intergalaktik/Extension_Boards_for_Olimex_GateMate/GamePad_I2S_audio_Buttons/KiCad/README.md

# Olimex Simple Extension Boards
Simple extension boards for Olimex GateMate FPGA Board

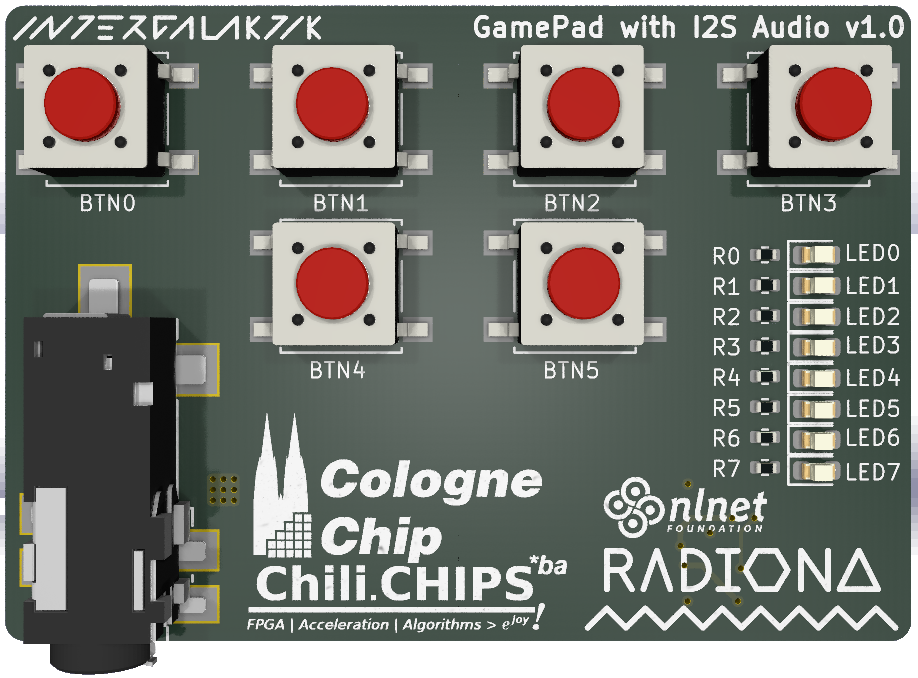
[picture p13: GamePad_I2S_audio_Buttons/pic/GamePad_I2S_audio_top.png]
GamePad_I2S_audio_TOP


Current schematic: https://github.com/intergalaktik/Extension_Boards_for_Olimex_GateMate/blob/main/GamePad_I2S_audio/doc/GamePad_I2S_audio.pdf
