intergalaktik/Extension_Boards_for_Olimex_GateMate/simpleIO/KiCad/README.md

# Olimex Simple Extension Boards
Simple extension boards for Olimex GateMate FPGA Board

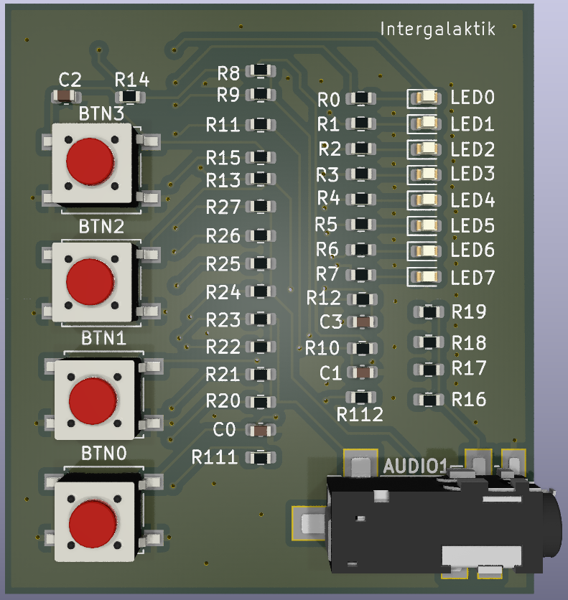
[picture p14: simpleIO/pic/simpleIO.png]
SimpleIO_TOP
