intergalaktik/Extension_Boards_for_Olimex_GateMate/extension_template/meta/olimex_extension.png

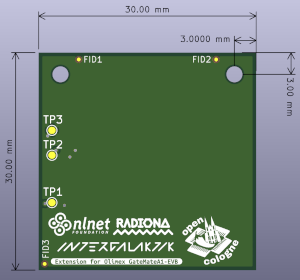
extension_template/meta/olimex_extension.png
