intergalaktik/Extension_Boards_for_Olimex_GateMate/GamePad_I2S_audio_Buttons/pic/StepUp_schematic.png

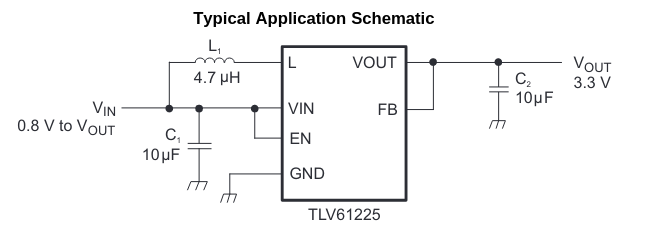
GamePad_I2S_audio_Buttons/pic/StepUp_schematic.png
