intergalaktik/Extension_Boards_for_Olimex_GateMate/(threads)

Thread 3 (2024-12-10):

dvi: GPDI_Dn and GPDI_CLK capacitor values

pu-cc, 2024-12-10:
I really like this extension!

Could you share the reasoning behind choosing 220nF for the AC coupling? For high-speed signals like DVI, I would consider changing it to 100nF to avoid excessive attenuation. 100nF is how we tested it on our platforms.

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

goran-mahovlic, 2024-12-10:
220nF is also working good - but yes I can change to lower.
I have copy pasted old version - I would say at last revision we are down to 22nF

As I have plenty of 100nF that sounds as a best value to go with...

Closed 2024-12-12.

Thread 4 (2024-12-10):

camIO: no support for LP modes and possible saving of U1

pu-cc, 2024-12-10:
Great idea for an extension!
This is more of a summary of some of my thoughts:

To support LP (single-ended) mode as well, we would have to use an additional bank that is configured to 1.2V.
It would be interesting to investigate whether we could use the entire bank with 1.2V, i.e. for both the single-ended and the differential inputs.

The Raspberry Pi Camera pull-ups `SCL` and `SDA` to 1.8V. But, thanks to the MOSFET, we could also manage without `U1` with pull-ups to 1.2V or whatever the GPIO voltage is. What do you think?
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*
(* [reference schematic](https://datasheets.raspberrypi.com/camera/camera-module-2-schematics.pdf))

Btw., I assume that the global names are still there by mistake:
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

goran-mahovlic, 2024-12-10:
Tnx!

You are right, I2C translation chip is not needed, I just assumed camera side, and was wrong :)
As you described, we just need PULL UP to our low voltage level.

2. that is just label converted to text - so nothing important, will change to just SDA/SCL

goran-mahovlic, 2024-12-10:
>> It would be interesting to investigate whether we could use the entire bank with 1.2V, i.e. for both the single-ended and the differential inputs.

oooo - no I think I get it  - you are suggesting to use remaining pins and connect them over resistor to P lines on CAM?

pu-cc, 2024-12-10:
> oooo - no I think I get it - you are suggesting to use remaining pins and connect them over resistor to P lines on CAM?

Almost :) We need both `*_N` and `*_P` in LP mode, as it transmits information such as HS-request etc. (LP-11, LP-01, LP-10 and LP-00).

Basically like this:
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
With `R{1,2,4,5,6,8}=100R` and `R{3,7,9}=150R` -- these are the values   from our evaluation with the HS bank at 2.5V and the LP bank at 1.2V.

goran-mahovlic, 2024-12-10:
@pu-cc could you check current schematic?

Now all 4 pairs have added LP on Positive side I think this could work as those are slow signals and we can always get N with just ~P.

As for R{3,7,9}=150R GateMate does not have internal termination, as that is better then terminate on extension board?

Just in case I can add termination resistors, and we can remove them and check if it is better without them.

goran-mahovlic, 2024-12-10:
@pu-cc I have placed termination resistor like on your schematics

Yes, from this picture it could be that you need P and N LP pins - but you only need P CLK pin?

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

If so I will have enough pins for the two data lines setup - like this

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

Closed 2024-12-12.

Thread 7 (2025-01-14):

usbIO - voltage lovel converter is sonnected wrong

goran-mahovlic, 2025-01-14:
This should be opposite - now we always have 3V3 on FPGA pins - voltages need to be switched so we have FPGA voltage at voltage pins, and 3V3 on USB connectors

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
