intergalaktik/Extension_Boards_for_Olimex_GateMate/ethIO/ethIO.pdf

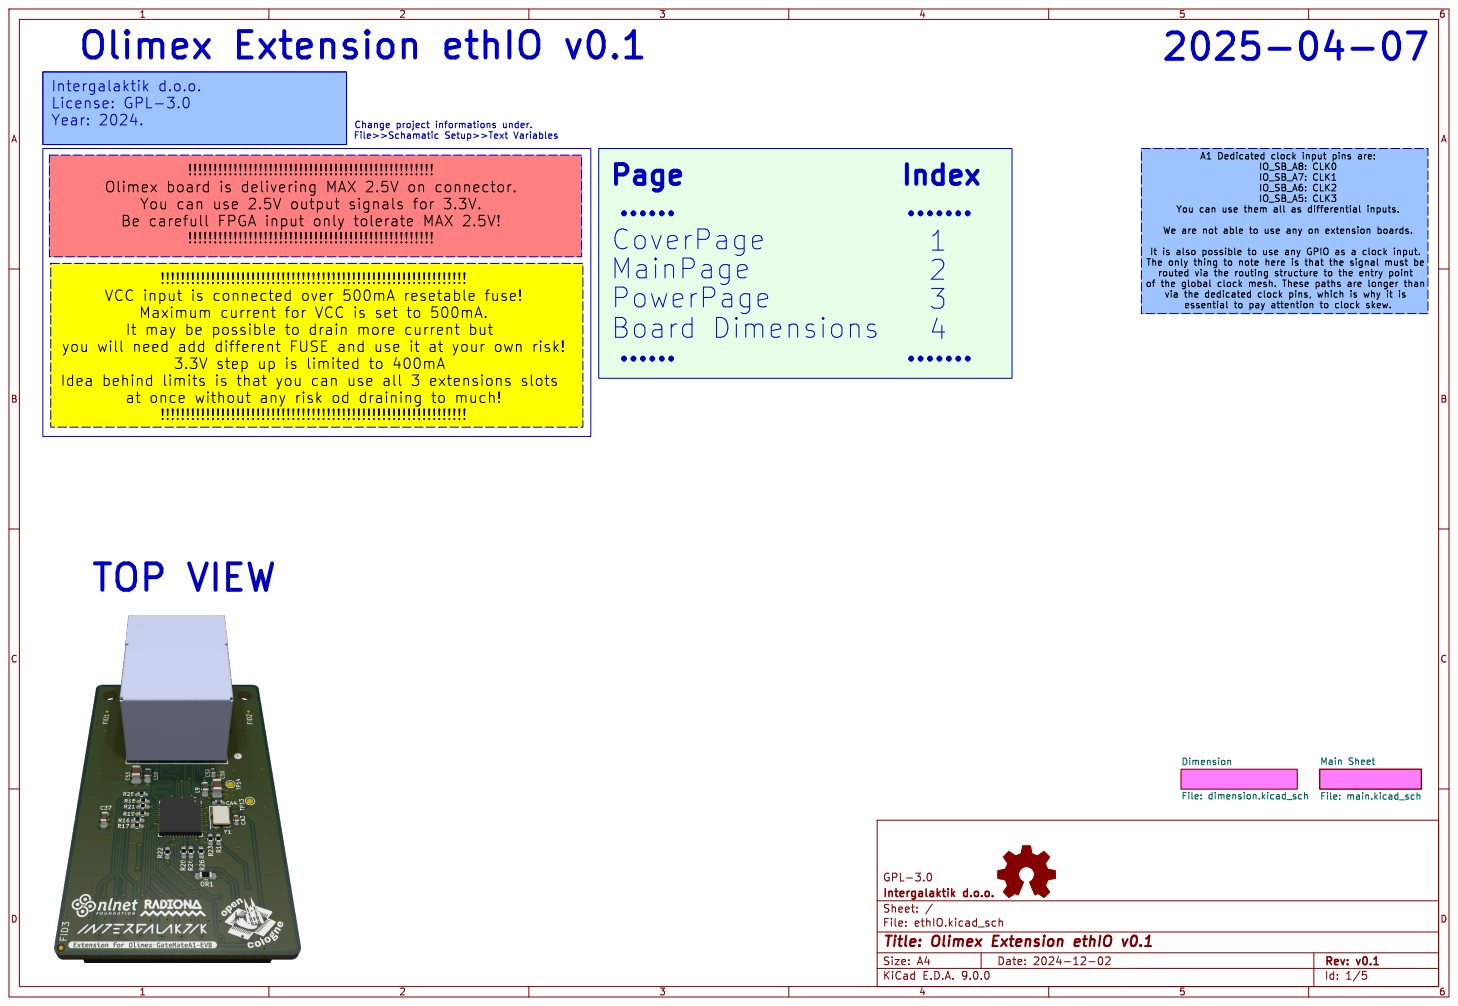
[picture p18: page 1]

You can use 2.5V output signals for 3.3V.

Maximum current for VCC is set to 500mA.
It may be possible to drain more current but

3.3V step up is limited to 400mA

at once without any risk od draining to much!

File: ethIO.kicad_sch Sheet: /
Id: 1/5 Title: Olimex Extension ethIO v0.1

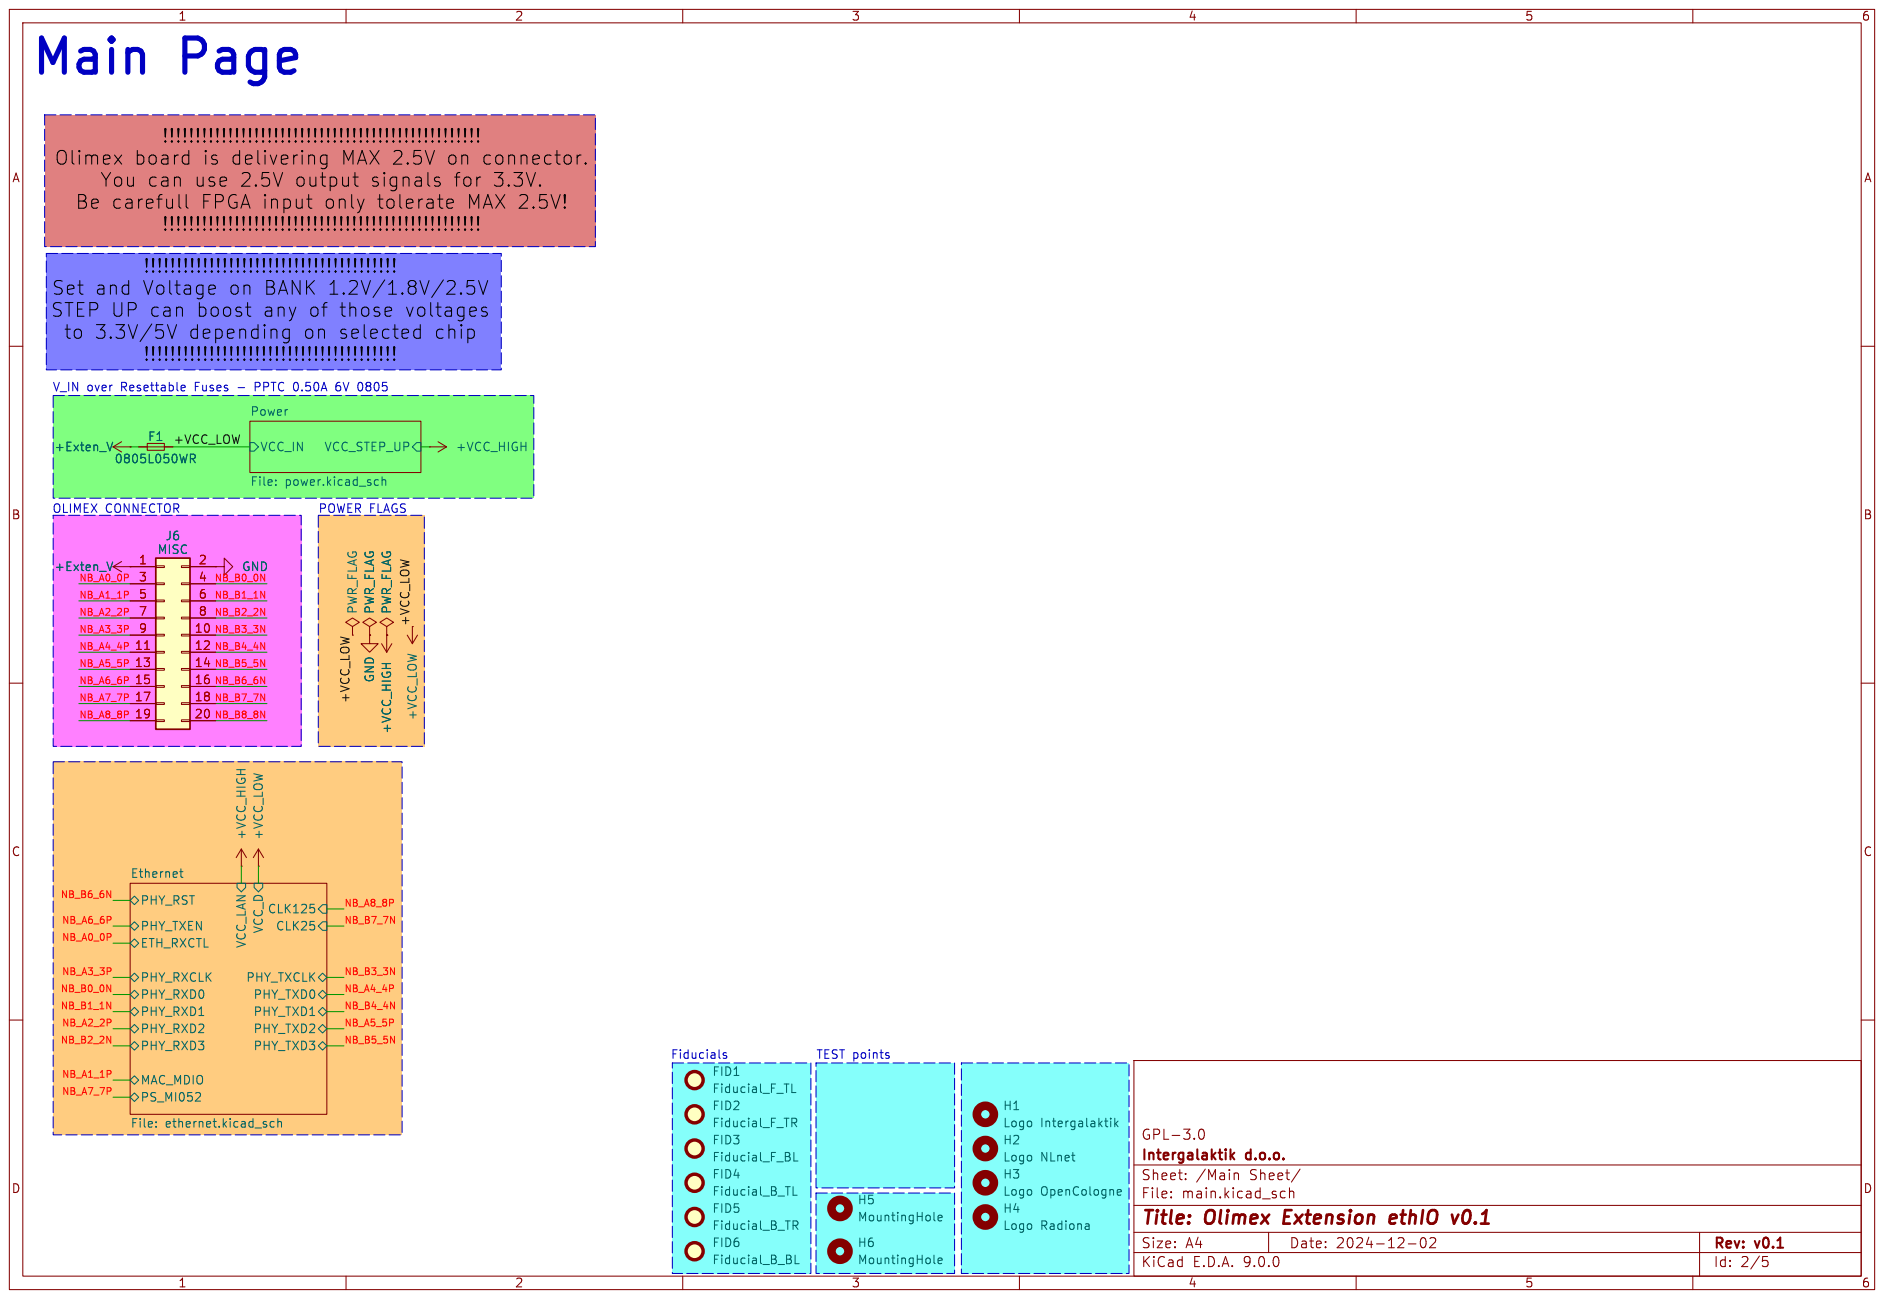
[picture p19: page 2]

You can use 2.5V output signals for 3.3V.
Power File: power.kicad_sch +VCC_LOW
J6 MISC 13579

Set and Voltage on BANK 1.2V/1.8V/2.5V
STEP UP can boost any of those voltages
to 3.3V/5V depending on selected chip

File: main.kicad_sch Sheet: /Main Sheet/
Id: 2/5 Title: Olimex Extension ethIO v0.1

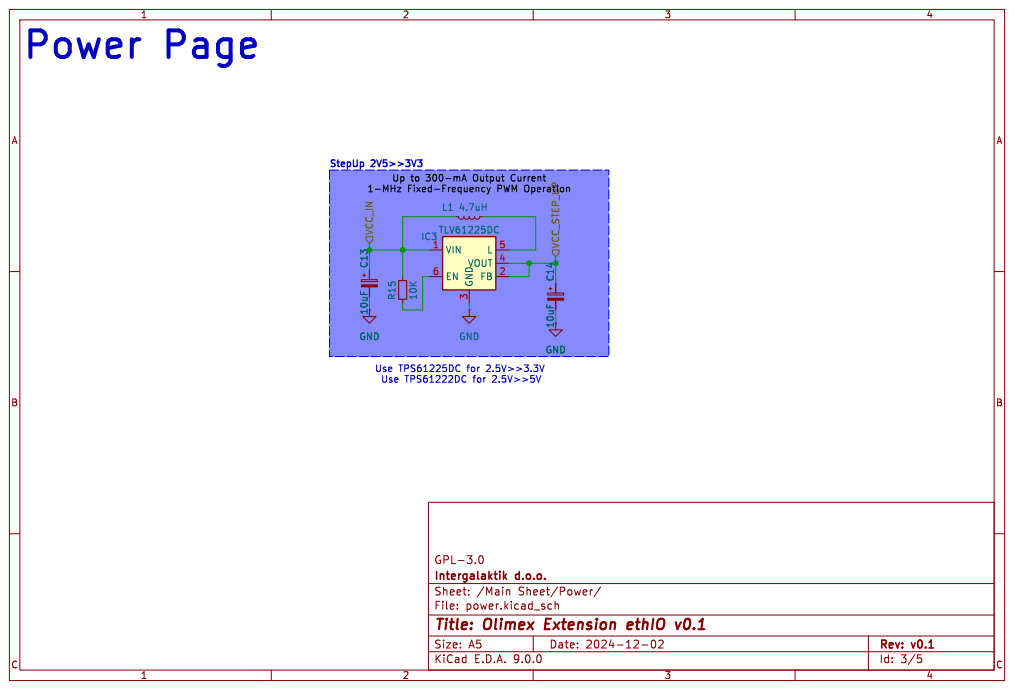
[picture p20: page 3]

Id: 3/5 Title: Olimex Extension ethIO v0.1

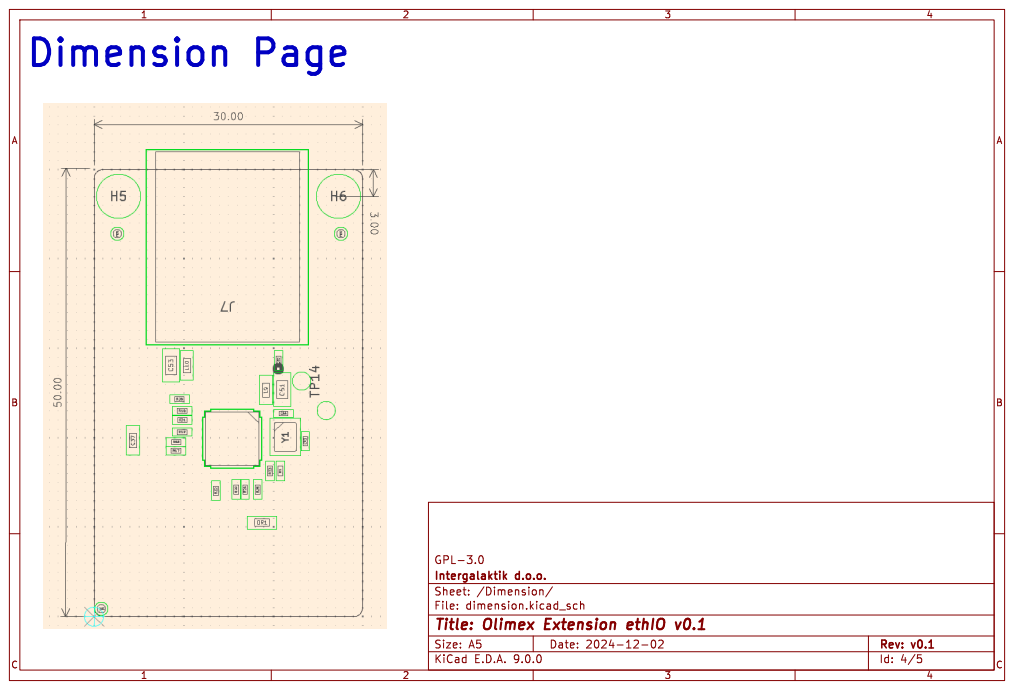
[picture p21: page 4]

File: dimension.kicad_sch Sheet: /Dimension/
Id: 4/5 Title: Olimex Extension ethIO v0.1

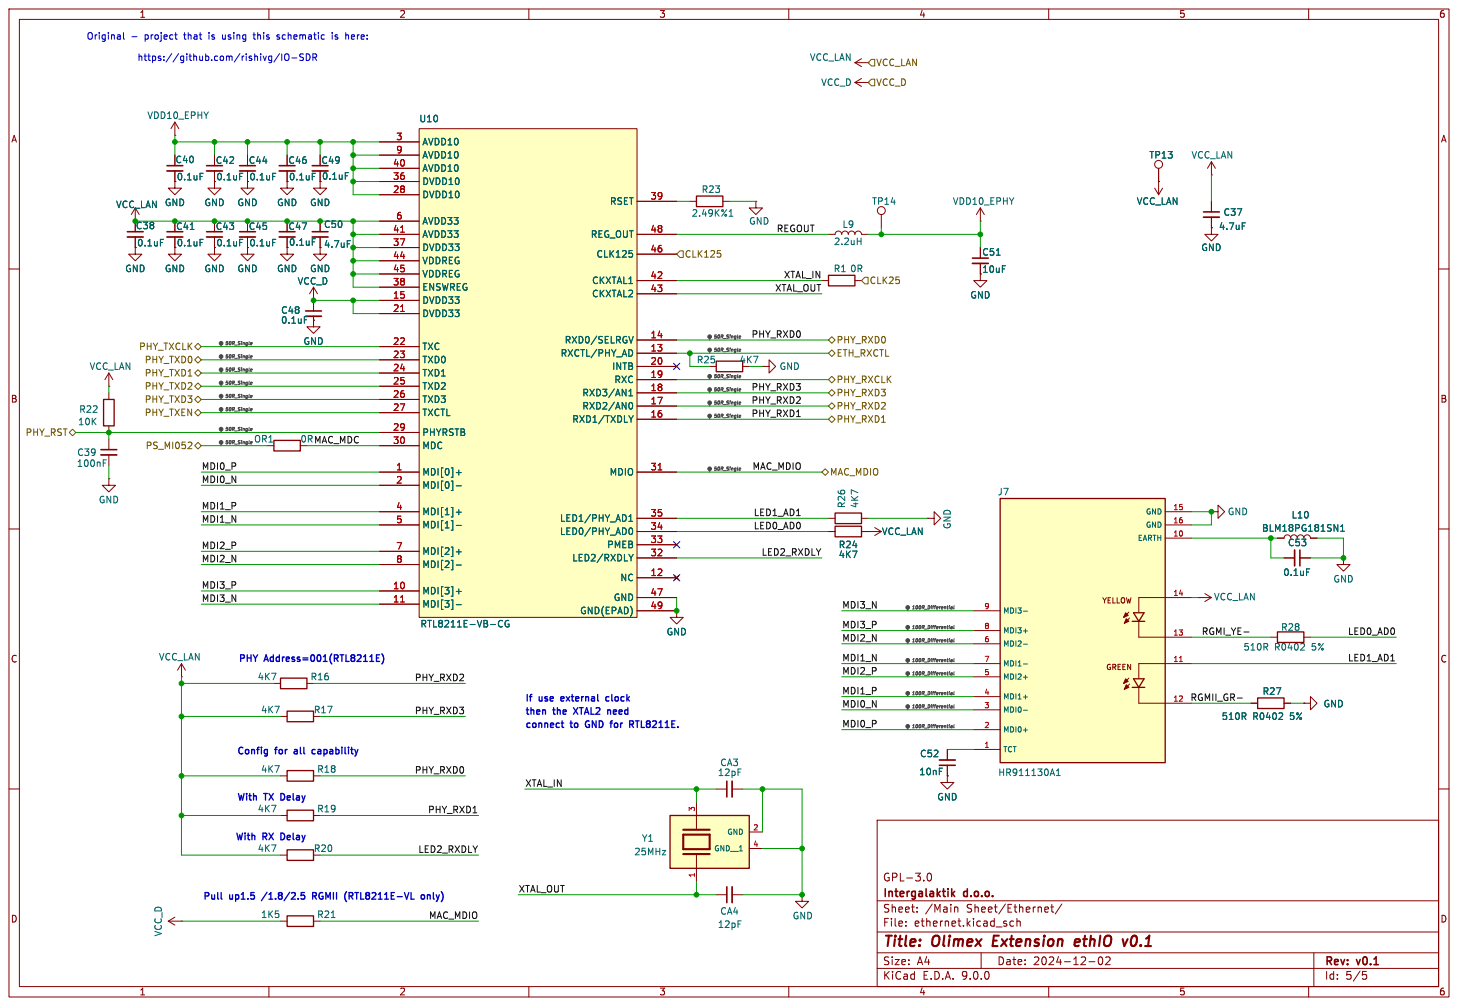
[picture p22: page 5]

If use external clock With RX Delay PHY Address=001(RTL8211E)

connect to GND for RTL8211E. With TX Delay

File: ethernet.kicad_sch Sheet: /Main Sheet/Ethernet/
Id: 5/5 Title: Olimex Extension ethIO v0.1
