intergalaktik/Extension_Boards_for_Olimex_GateMate/dvi/dvi.pdf

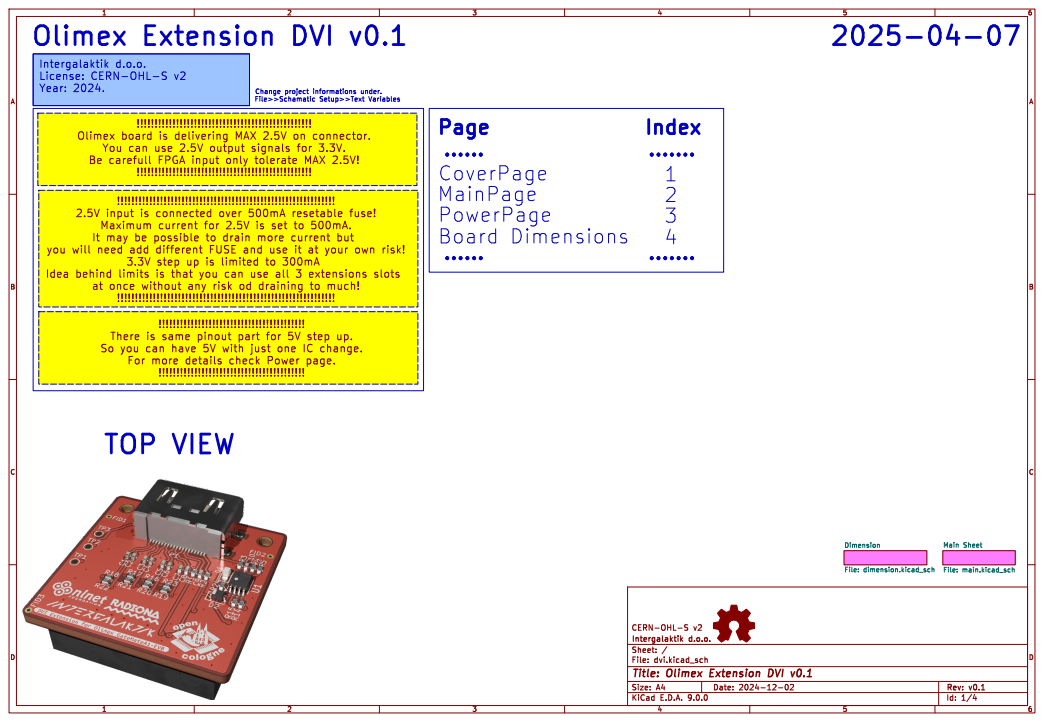
[picture p23: page 1]

You can use 2.5V output signals for 3.3V.

There is same pinout part for 5V step up.
So you can have 5V with just one IC change.
For more details check Power page.

File: dvi.kicad_sch Sheet: /
Id: 1/4 Title: Olimex Extension DVI v0.1

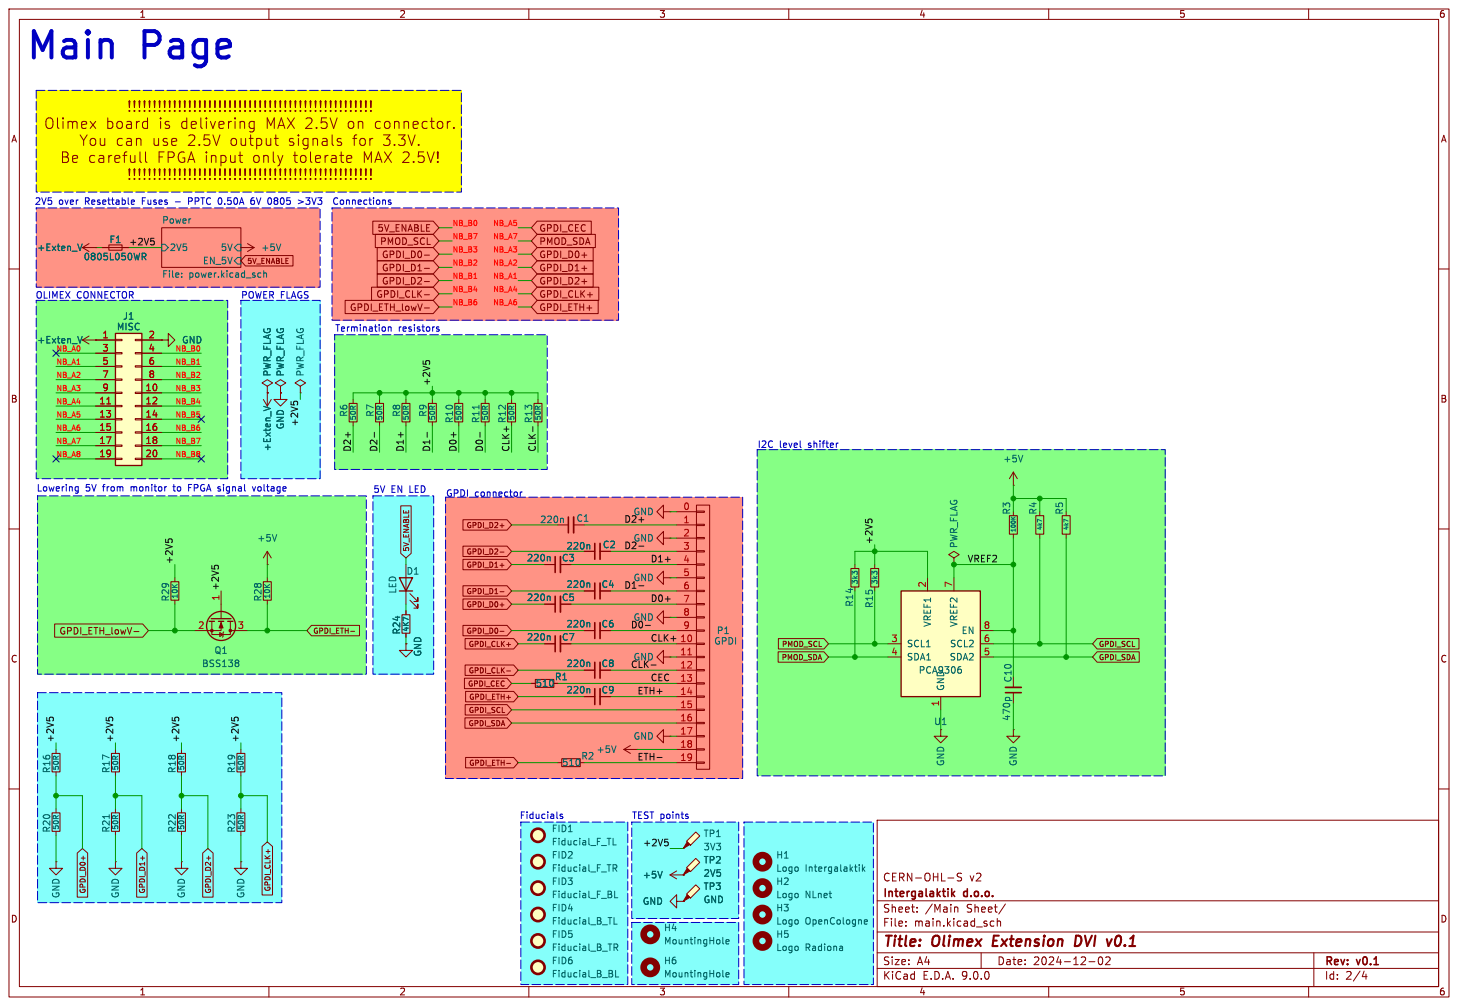
[picture p24: page 2]

You can use 2.5V output signals for 3.3V.

File: main.kicad_sch Sheet: /Main Sheet/
Id: 2/4 Title: Olimex Extension DVI v0.1

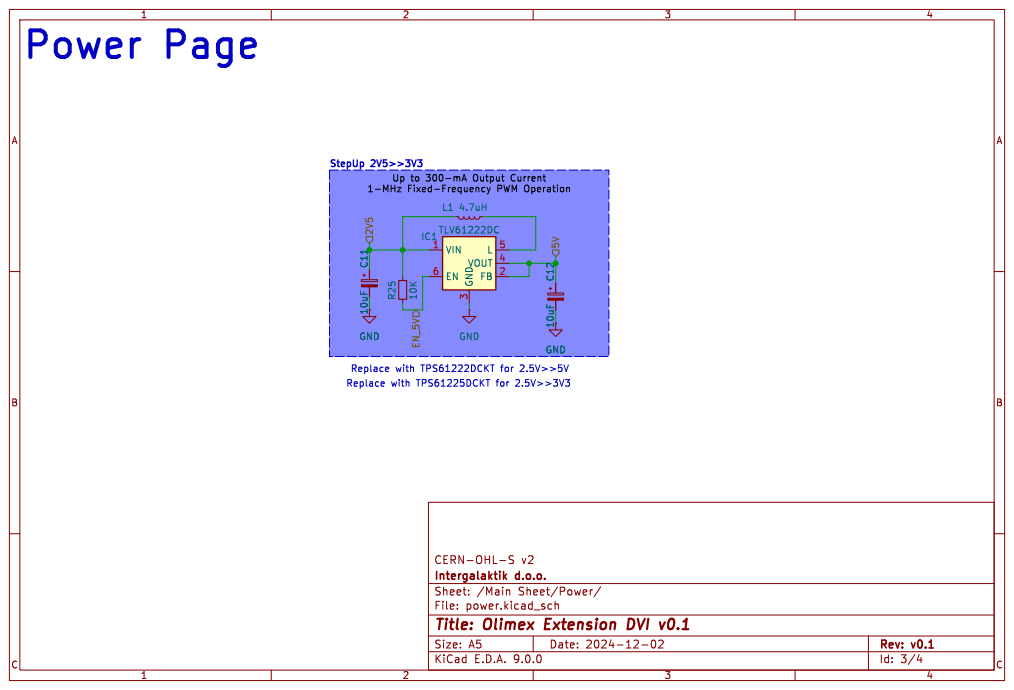
[picture p25: page 3]

Id: 3/4 Title: Olimex Extension DVI v0.1

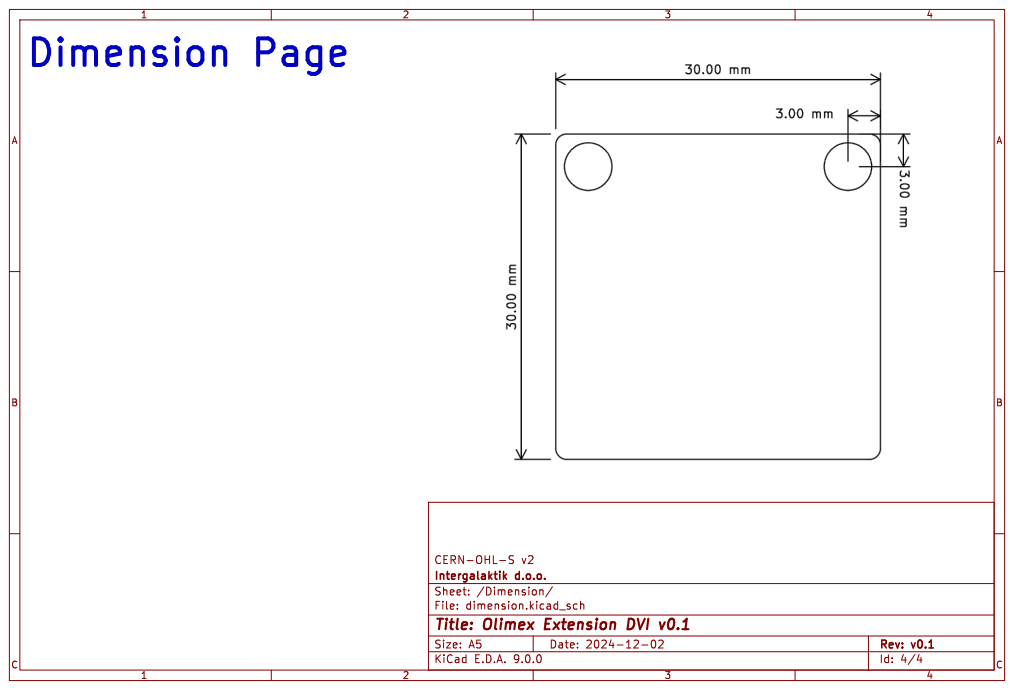
[picture p26: page 4]

File: dimension.kicad_sch Sheet: /Dimension/
Id: 4/4 Title: Olimex Extension DVI v0.1
