intergalaktik/Extension_Boards_for_Olimex_GateMate/tmrIO/tmrIO.pdf

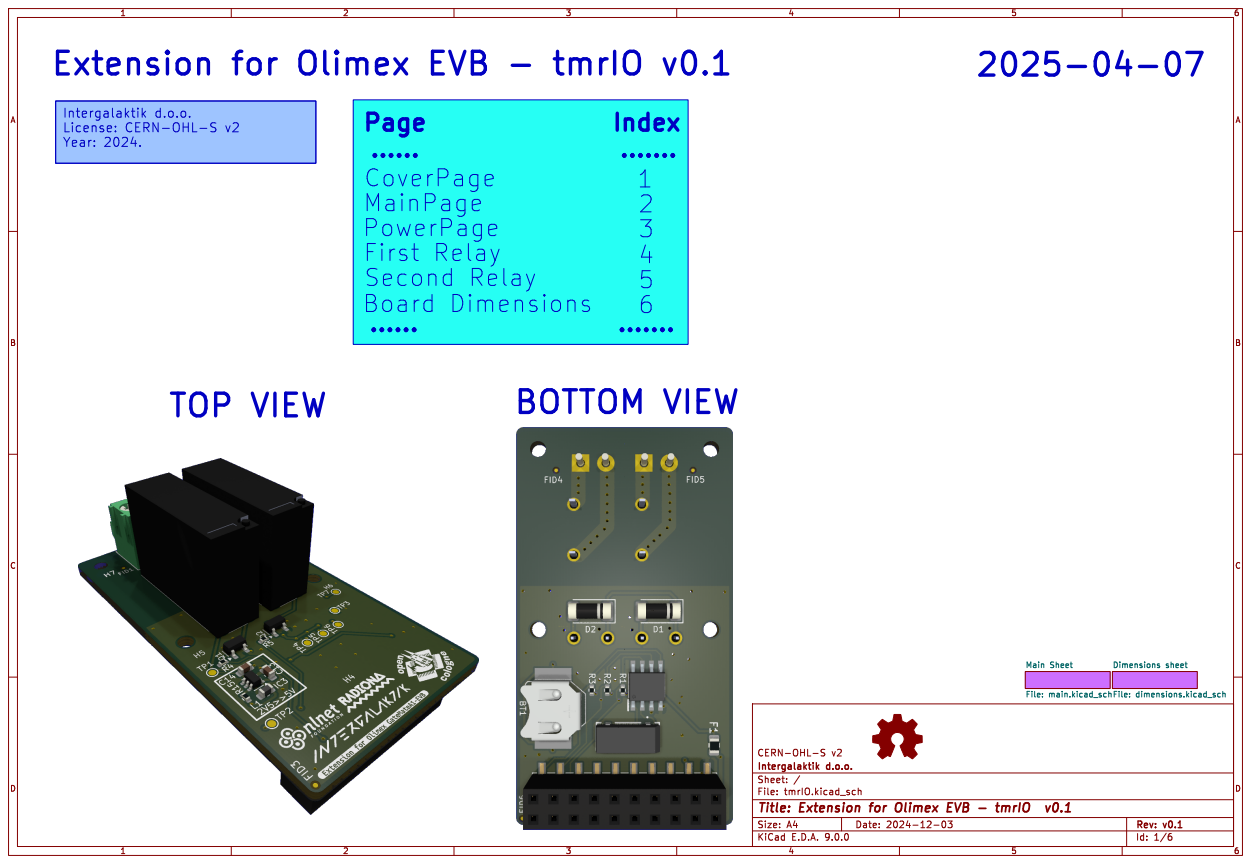
[picture p27: page 1]

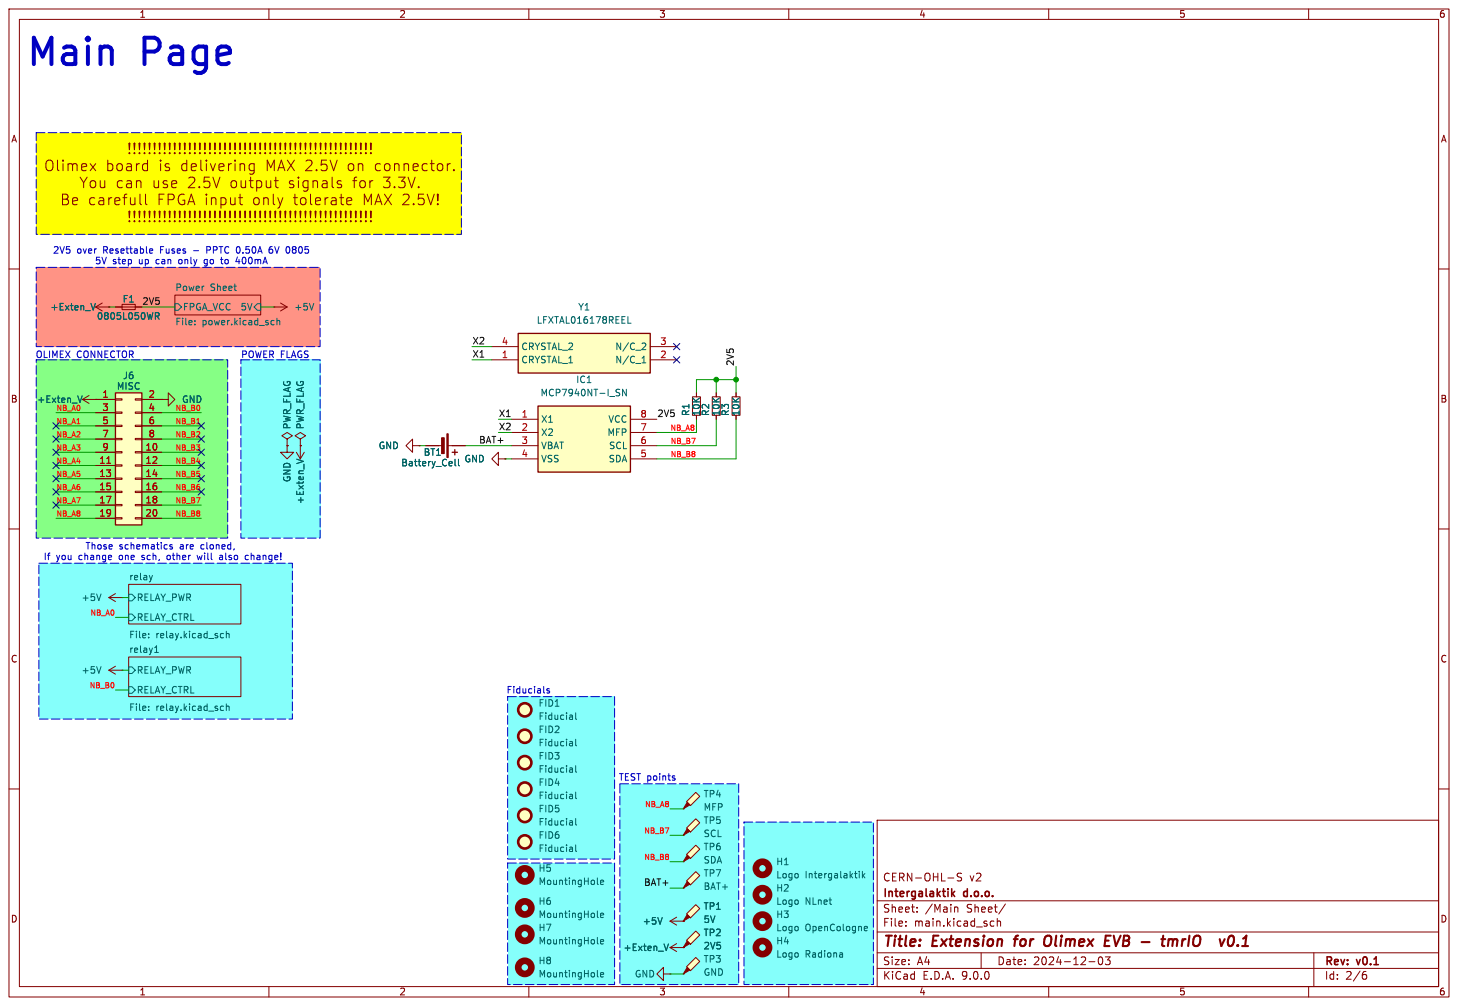
[picture p28: page 2]

You can use 2.5V output signals for 3.3V.

5V step up can only go to 400mA OLIMEX CONNECTOR

If you change one sch, other will also change! +Exten_V

5V H8 MountingHole H5 MountingHole H6 MountingHole H7 MountingHole FID5 Fiducial GND +Exten_V

File: main.kicad_sch Sheet: /Main Sheet/

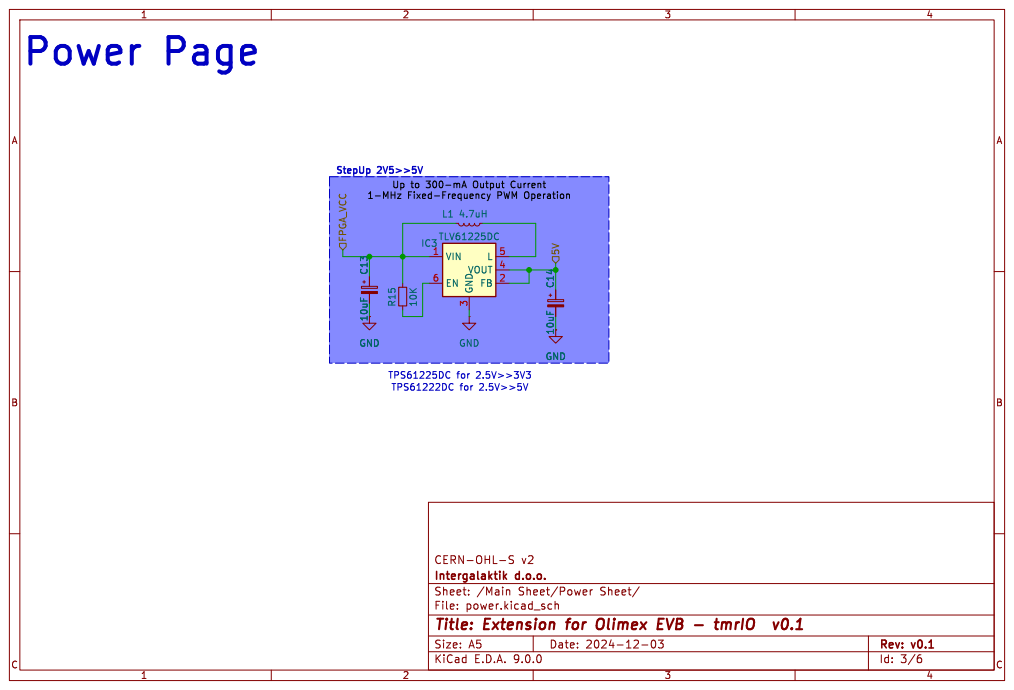
[picture p29: page 3]

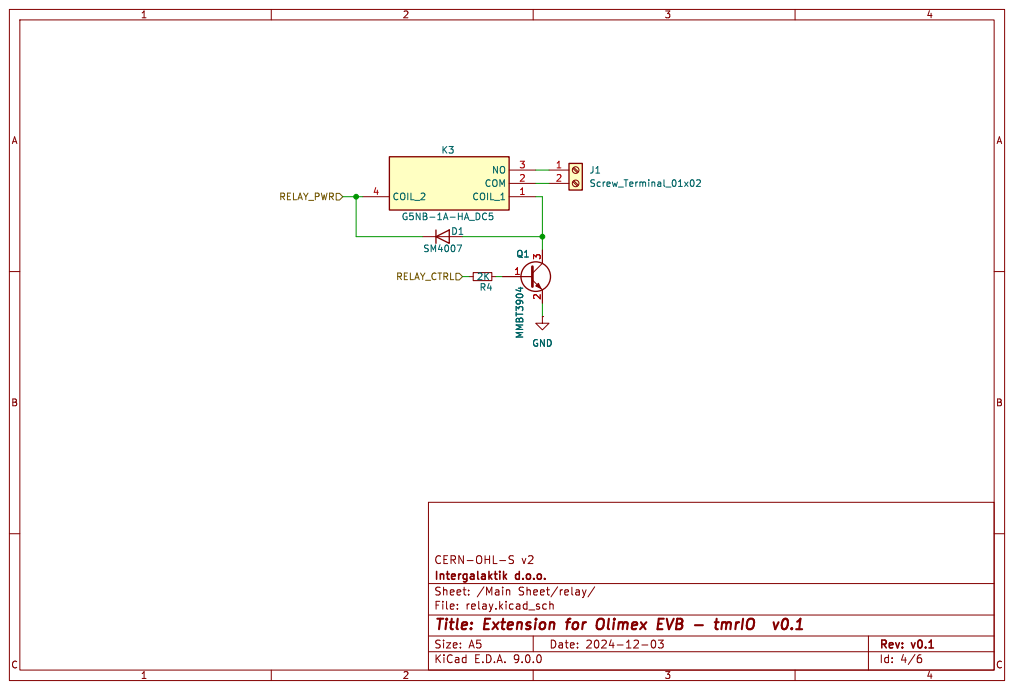
[picture p30: page 4]

File: relay.kicad_sch Sheet: /Main Sheet/relay/

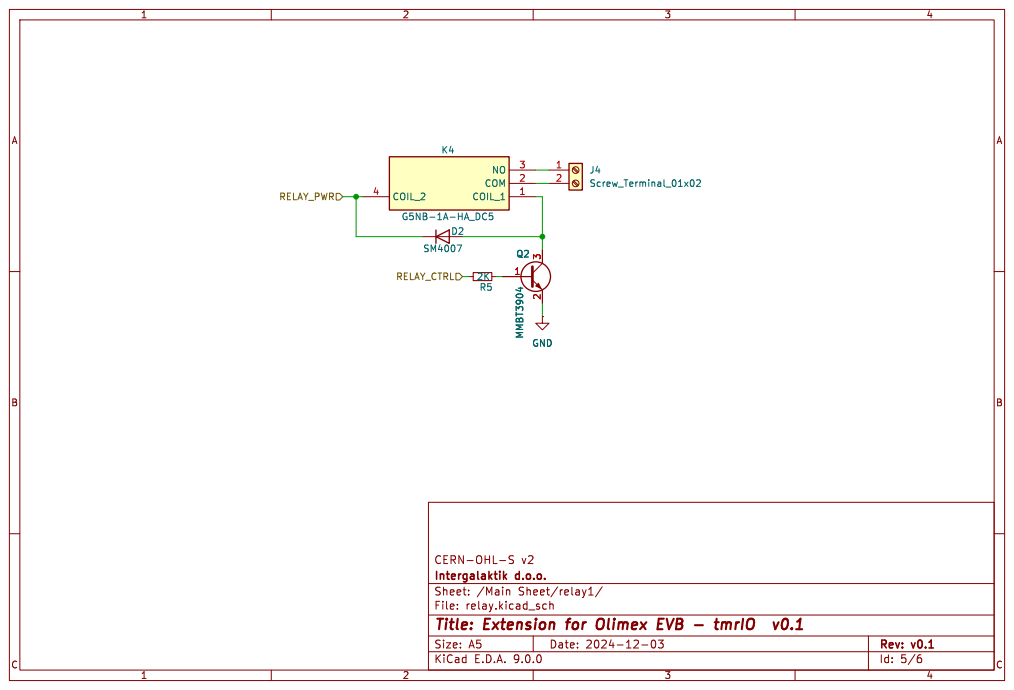
[picture p31: page 5]

File: relay.kicad_sch Sheet: /Main Sheet/relay1/

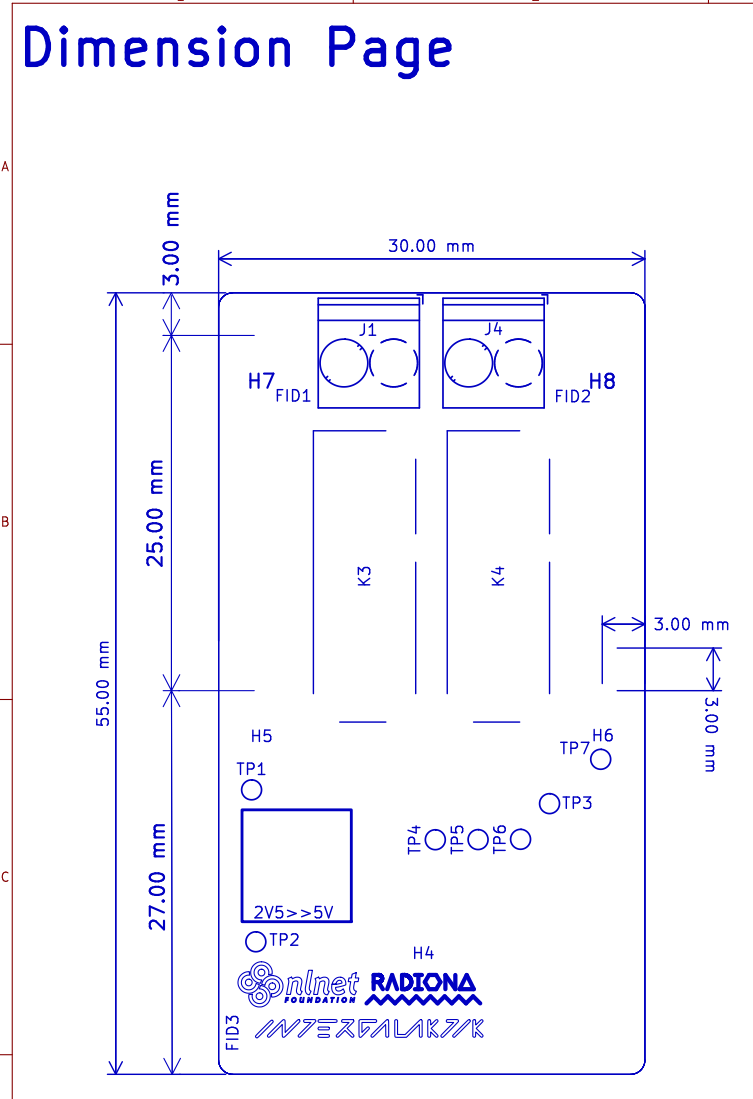
[picture p32: page 6]
