intergalaktik/Extension_Boards_for_Olimex_GateMate/adcIO/adcIO.pdf

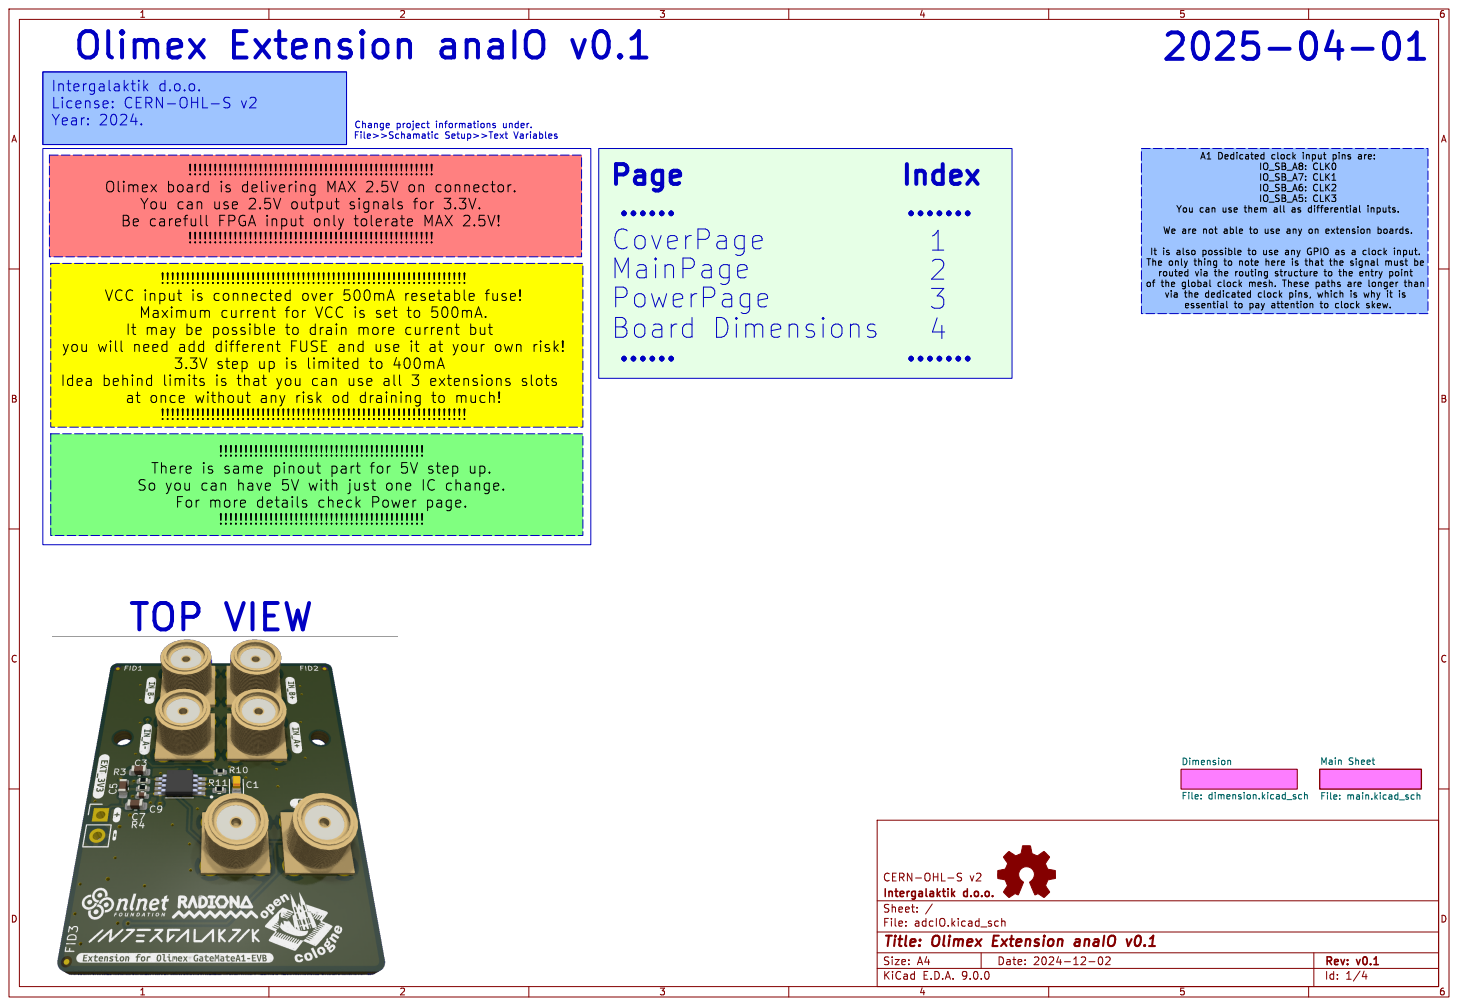
[picture p37: page 1]

You can use 2.5V output signals for 3.3V.

Maximum current for VCC is set to 500mA.
It may be possible to drain more current but

3.3V step up is limited to 400mA

at once without any risk od draining to much!

There is same pinout part for 5V step up.
So you can have 5V with just one IC change.
For more details check Power page.

File: adcIO.kicad_sch Sheet: /
Id: 1/4 Title: Olimex Extension anaIO v0.1

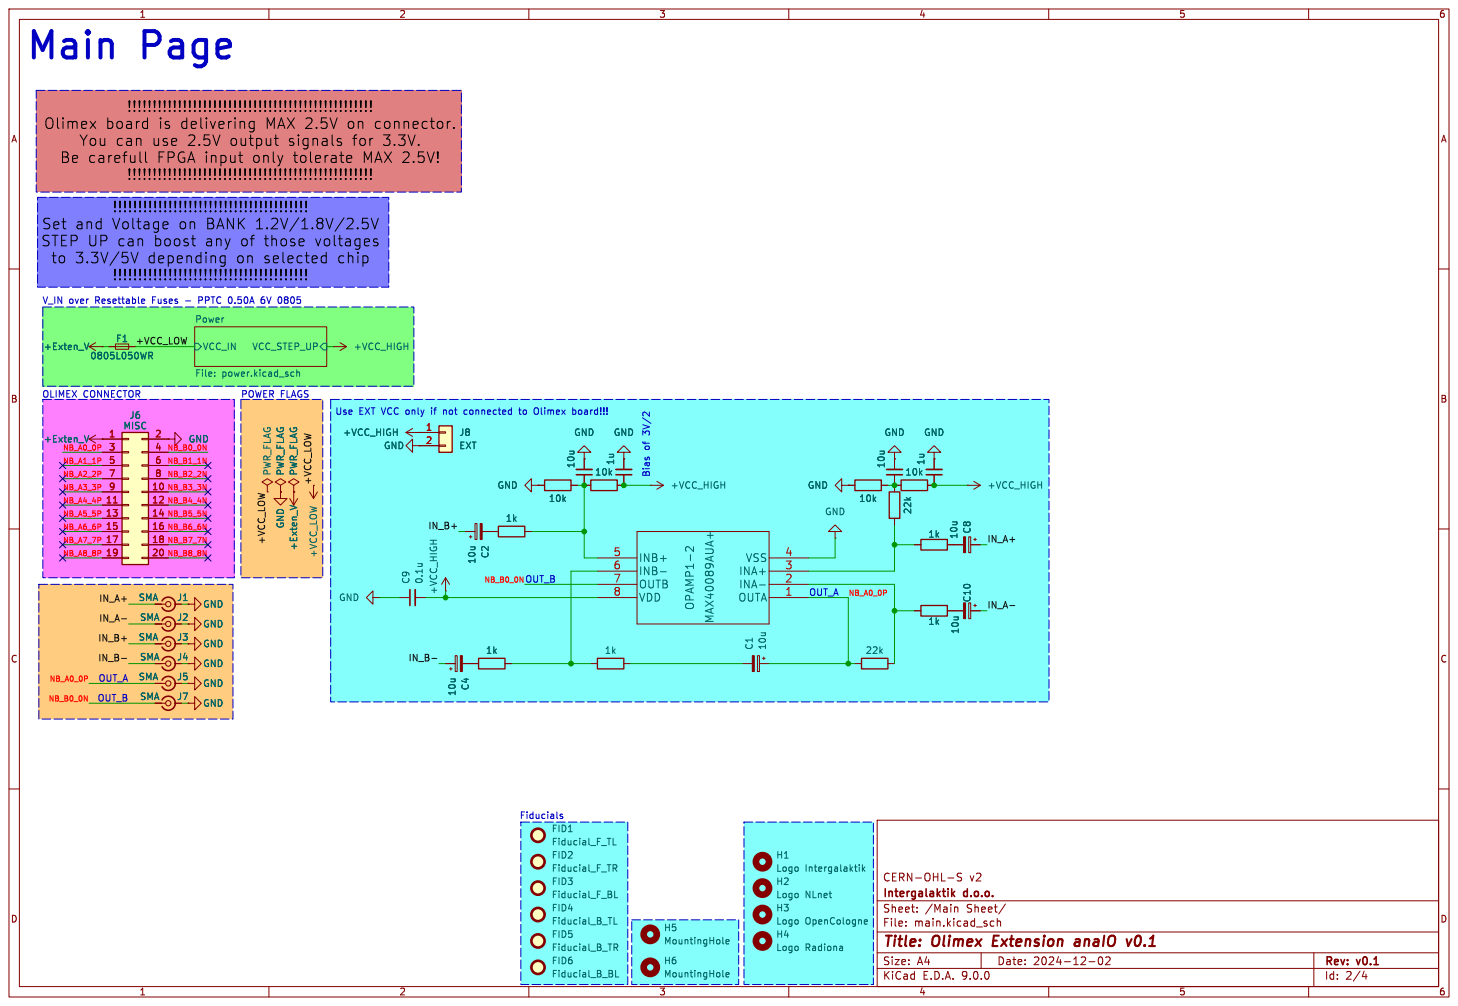
[picture p38: page 2]

You can use 2.5V output signals for 3.3V.
Power File: power.kicad_sch GND

Set and Voltage on BANK 1.2V/1.8V/2.5V
STEP UP can boost any of those voltages
to 3.3V/5V depending on selected chip

File: main.kicad_sch Sheet: /Main Sheet/
Id: 2/4 Title: Olimex Extension anaIO v0.1

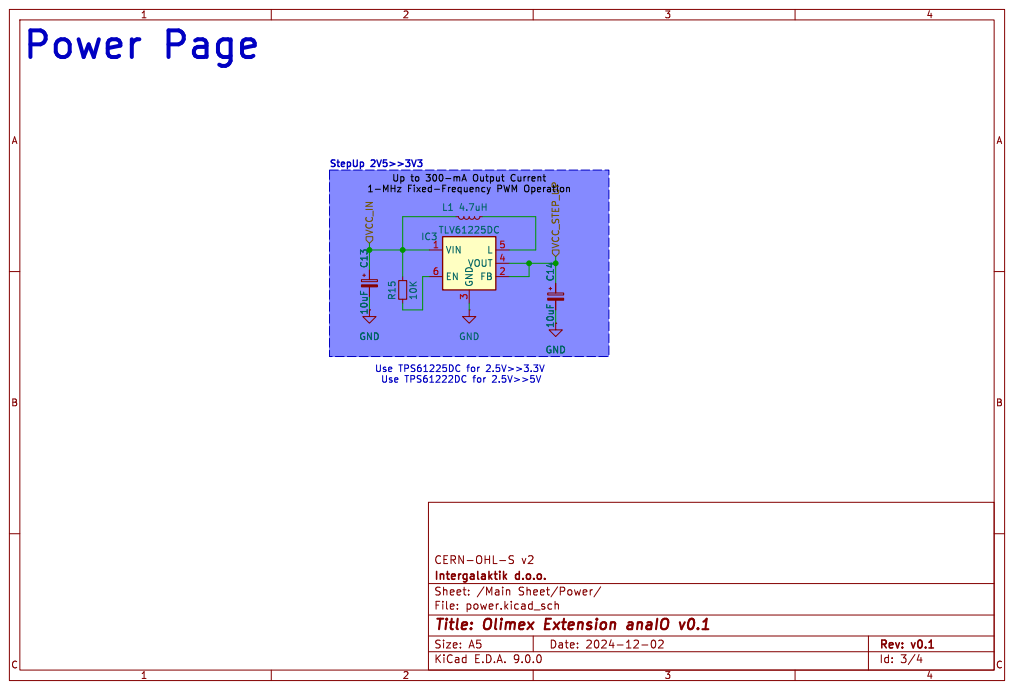
[picture p39: page 3]

Id: 3/4 Title: Olimex Extension anaIO v0.1

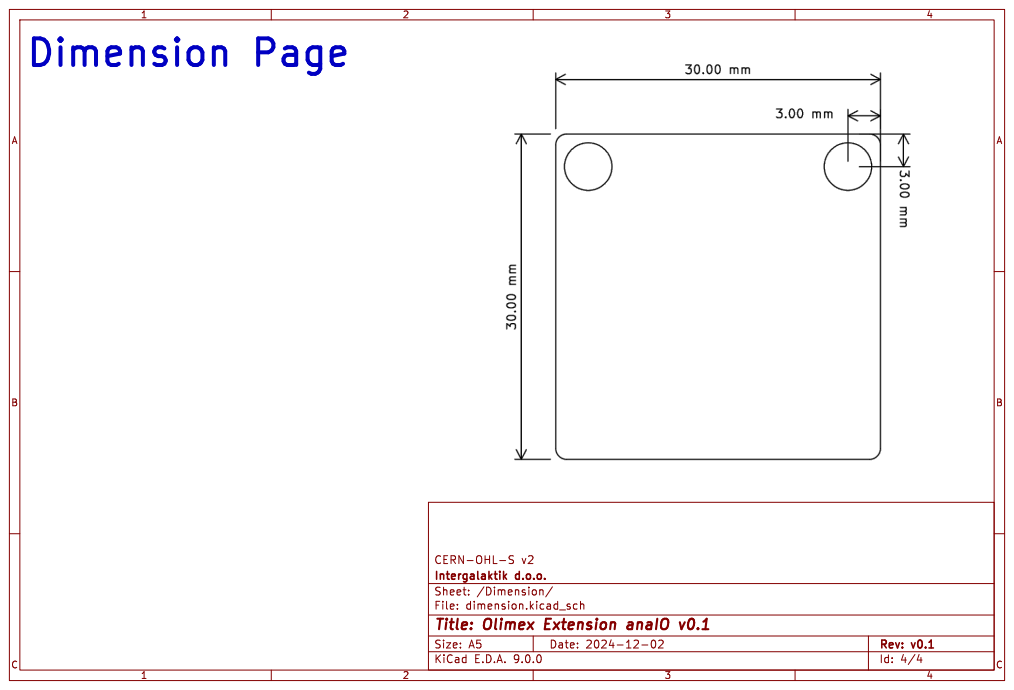
[picture p40: page 4]

File: dimension.kicad_sch Sheet: /Dimension/
Id: 4/4 Title: Olimex Extension anaIO v0.1
