intergalaktik/Extension_Boards_for_Olimex_GateMate/pwrIO/pwrIO.pdf

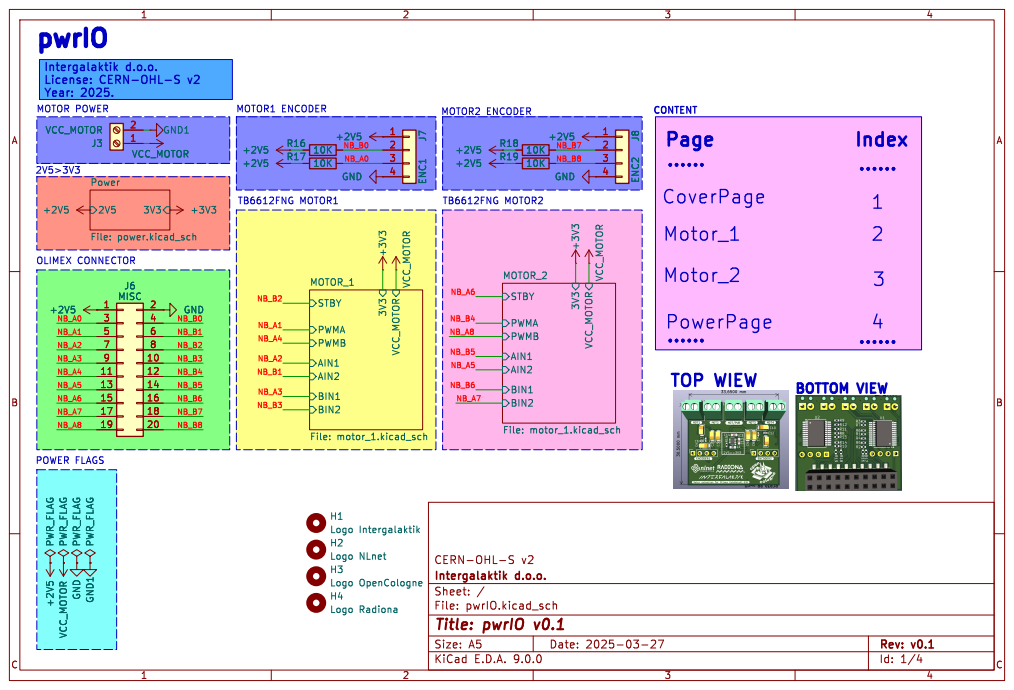
[picture p45: page 1]

POWER FLAGS MOTOR POWER pwrIO

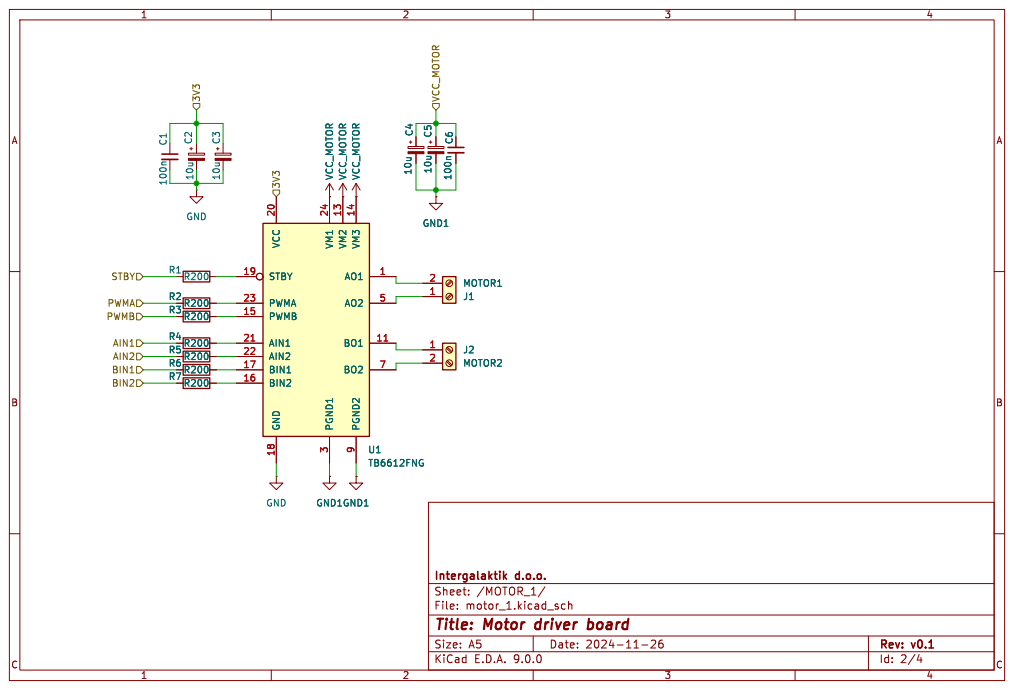
[picture p46: page 2]

File: motor_1.kicad_sch Sheet: /MOTOR_1/
Id: 2/4 Title: Motor driver board

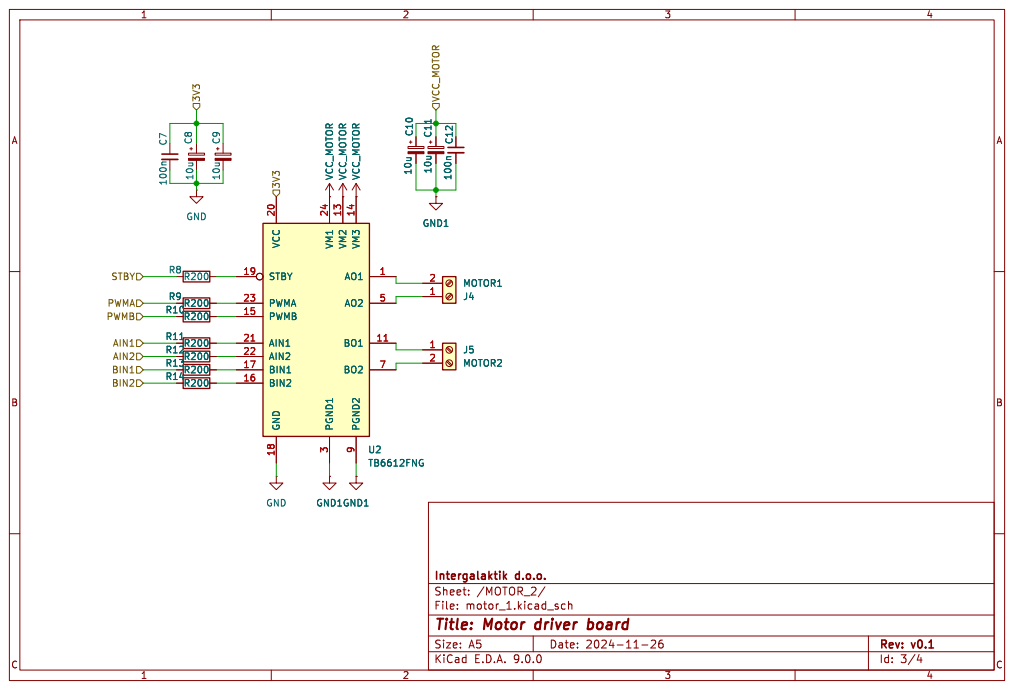
[picture p47: page 3]

File: motor_1.kicad_sch Sheet: /MOTOR_2/
Id: 3/4 Title: Motor driver board

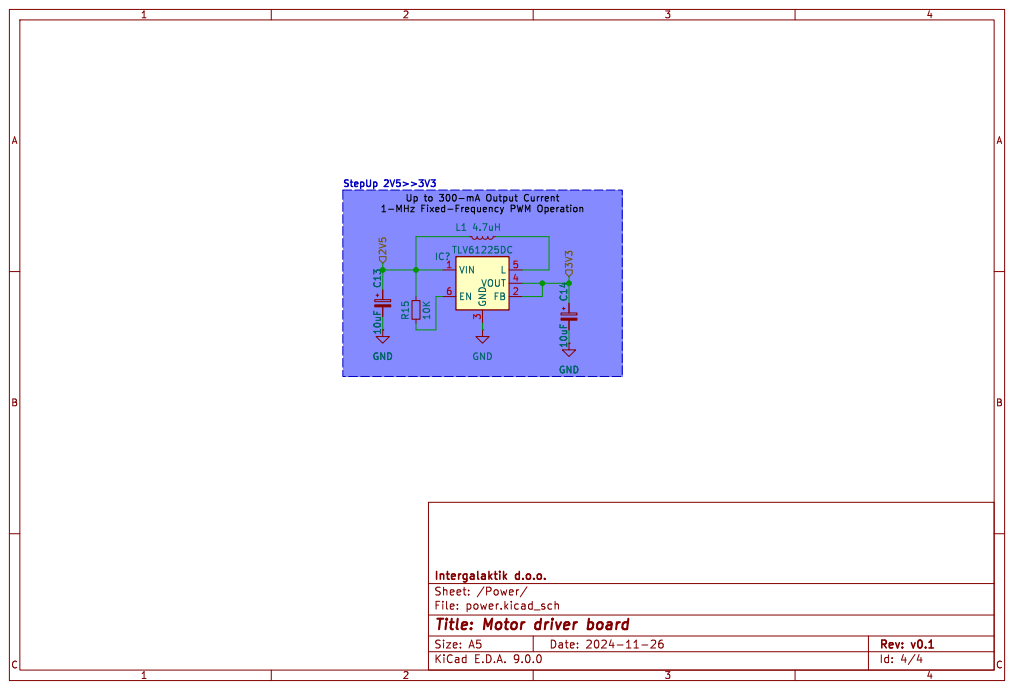
[picture p48: page 4]

Id: 4/4 Title: Motor driver board
