intergalaktik/Extension_Boards_for_Olimex_GateMate/USB/USB.pdf

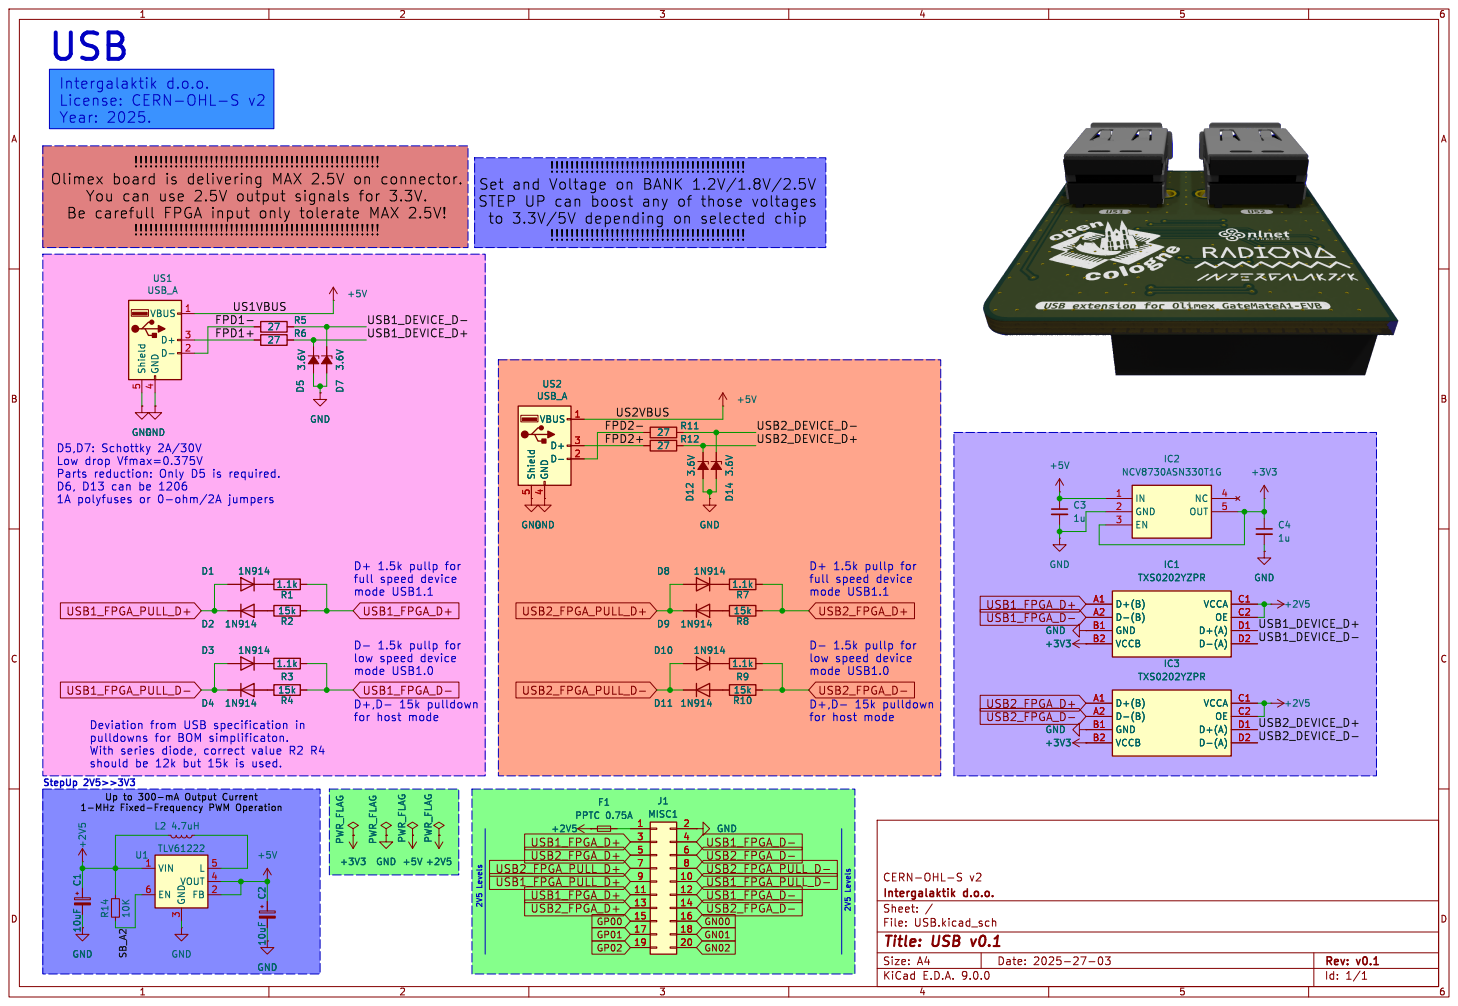
[picture p49: page 1]

You can use 2.5V output signals for 3.3V.

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

low speed device mode USB1.0 D+ 1.5k pullp for
full speed device mode USB1.1

full speed device mode USB1.1 D- 1.5k pullp for

for host mode 2V5 Levels

low speed device mode USB1.0
