intergalaktik/Extension_Boards_for_Olimex_GateMate/eduIO/eduIO.pdf

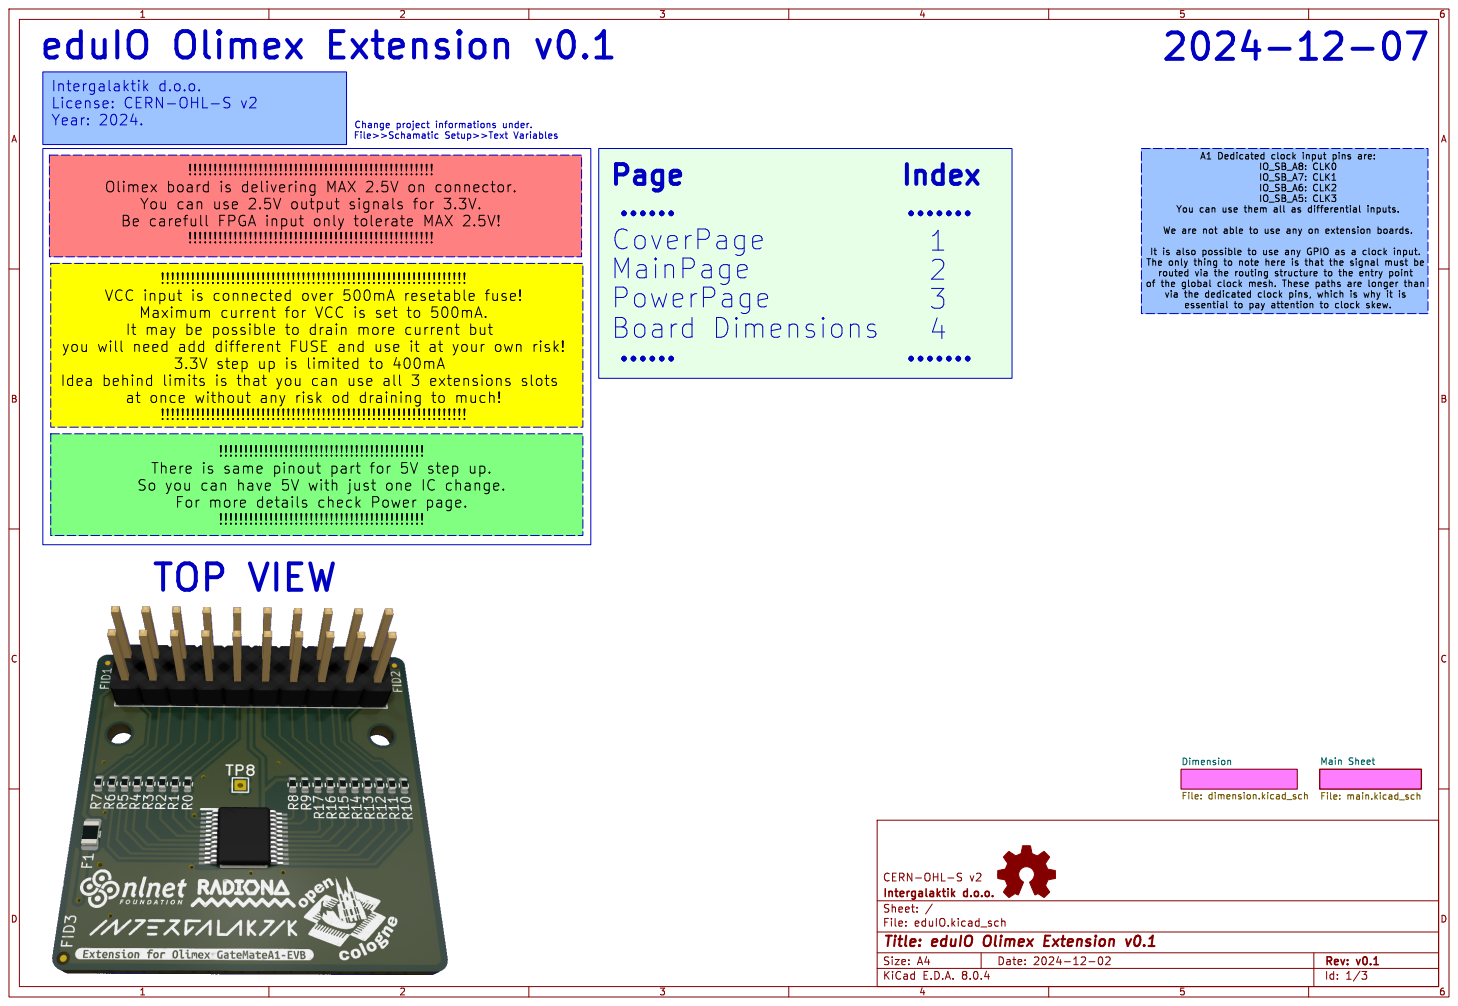
[picture p50: page 1]

You can use 2.5V output signals for 3.3V.

Maximum current for VCC is set to 500mA.
It may be possible to drain more current but

3.3V step up is limited to 400mA

at once without any risk od draining to much!

File: eduIO.kicad_sch Sheet: /
Id: 1/3 Title: eduIO Olimex Extension v0.1

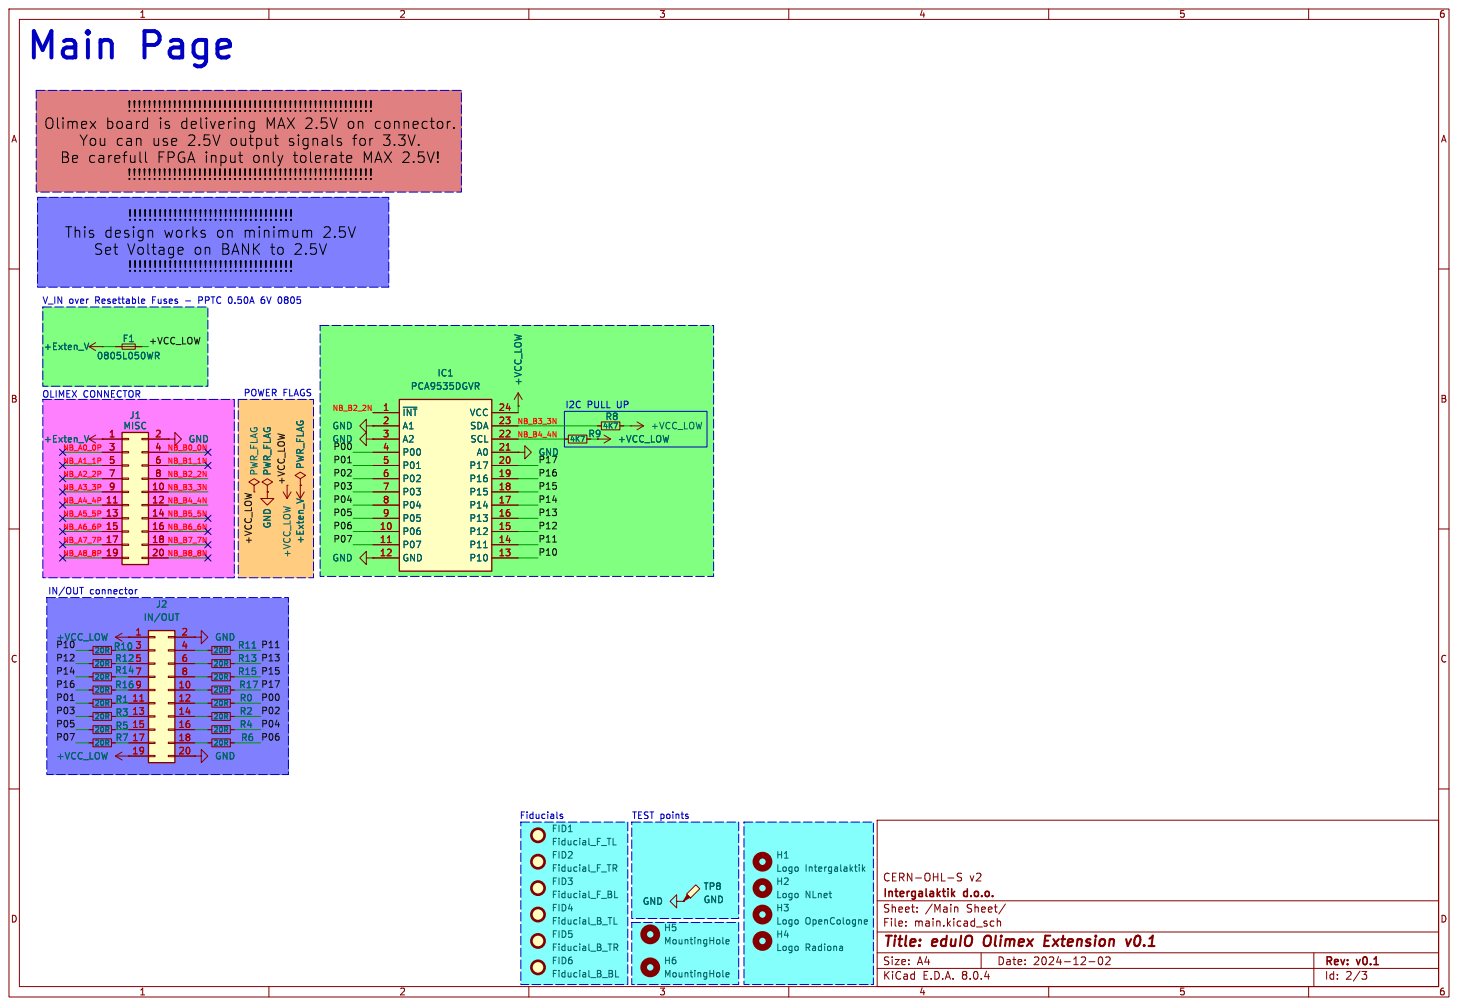
[picture p51: page 2]

You can use 2.5V output signals for 3.3V.
!!!!!!!!!!!!!!!!!!!!!!!!!!!!!!!!!!!!!!!!!!!!!!!!! OLIMEX CONNECTOR

This design works on minimum 2.5V
Set Voltage on BANK to 2.5V
!!!!!!!!!!!!!!!!!!!!!!!!!!!!!!!!! POWER FLAGS

Logo Intergalaktik H6 MountingHole GND

File: main.kicad_sch Sheet: /Main Sheet/
Id: 2/3 Title: eduIO Olimex Extension v0.1

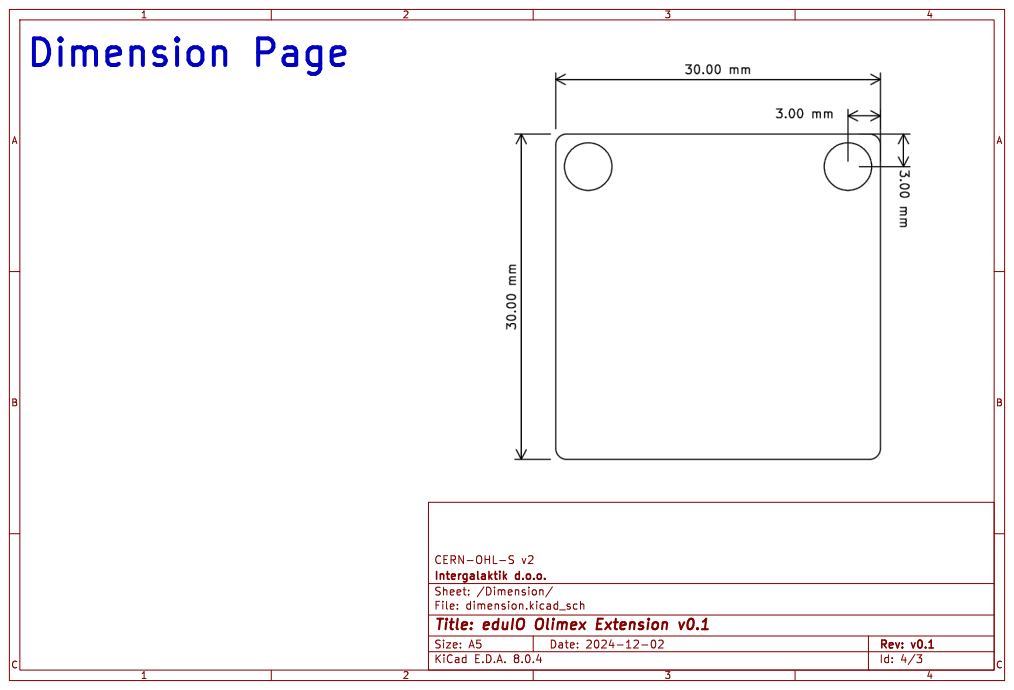
[picture p52: page 3]

File: dimension.kicad_sch Sheet: /Dimension/
Id: 4/3 Title: eduIO Olimex Extension v0.1
