intergalaktik/Extension_Boards_for_Olimex_GateMate/GamePad_I2S_audio/KiCad/GamePad_I2S_audio.pdf

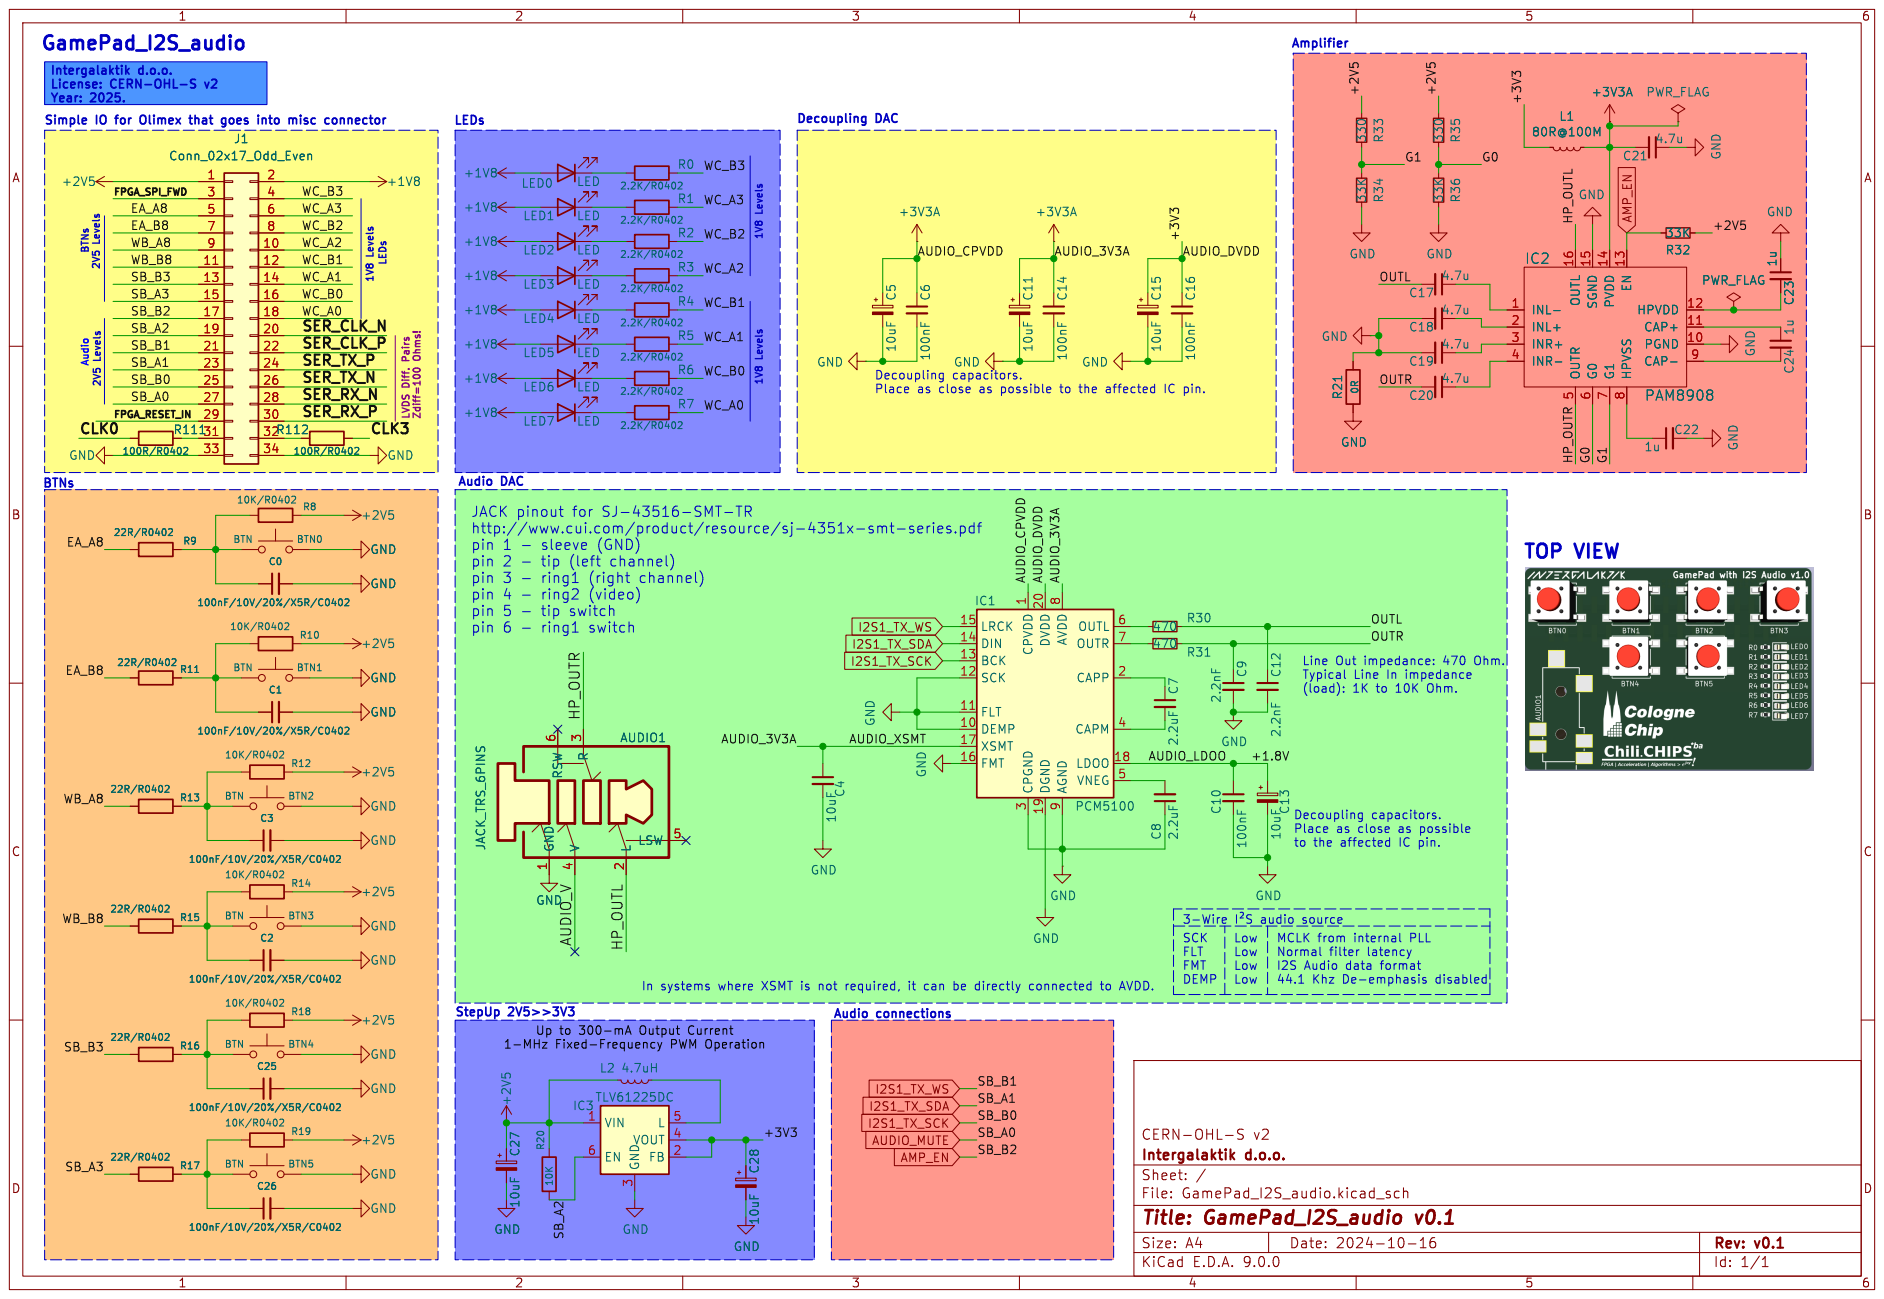
[picture p53: page 1]

Simple IO for Olimex that goes into misc connector BTNs 2V5 Levels
J1 Conn_02x17_Odd_Even GND

8 HPVDD 12 CAP+ 11 PGND 10 CAP- 9 C23 1u

8 HPVDD 12 CAP+ 11 PGND 10 CAP- 9

Low LVDS Diff. Pairs Zdiff=100 Ohms!
4.7u GND

http://www.cui.com/product/resource/sj-4351x-smt-series.pdf
pin 1 - sleeve (GND)
pin 2 - tip (left channel)
pin 3 - ring1 (right channel)
pin 4 - ring2 (video)
pin 5 - tip switch
pin 6 - ring1 switch

9 OUTL 6 OUTR 7 CAPP 2 CAPM 4
