intergalaktik/Extension_Boards_for_Olimex_GateMate/simpleIO/KiCad/simpleIO.pdf

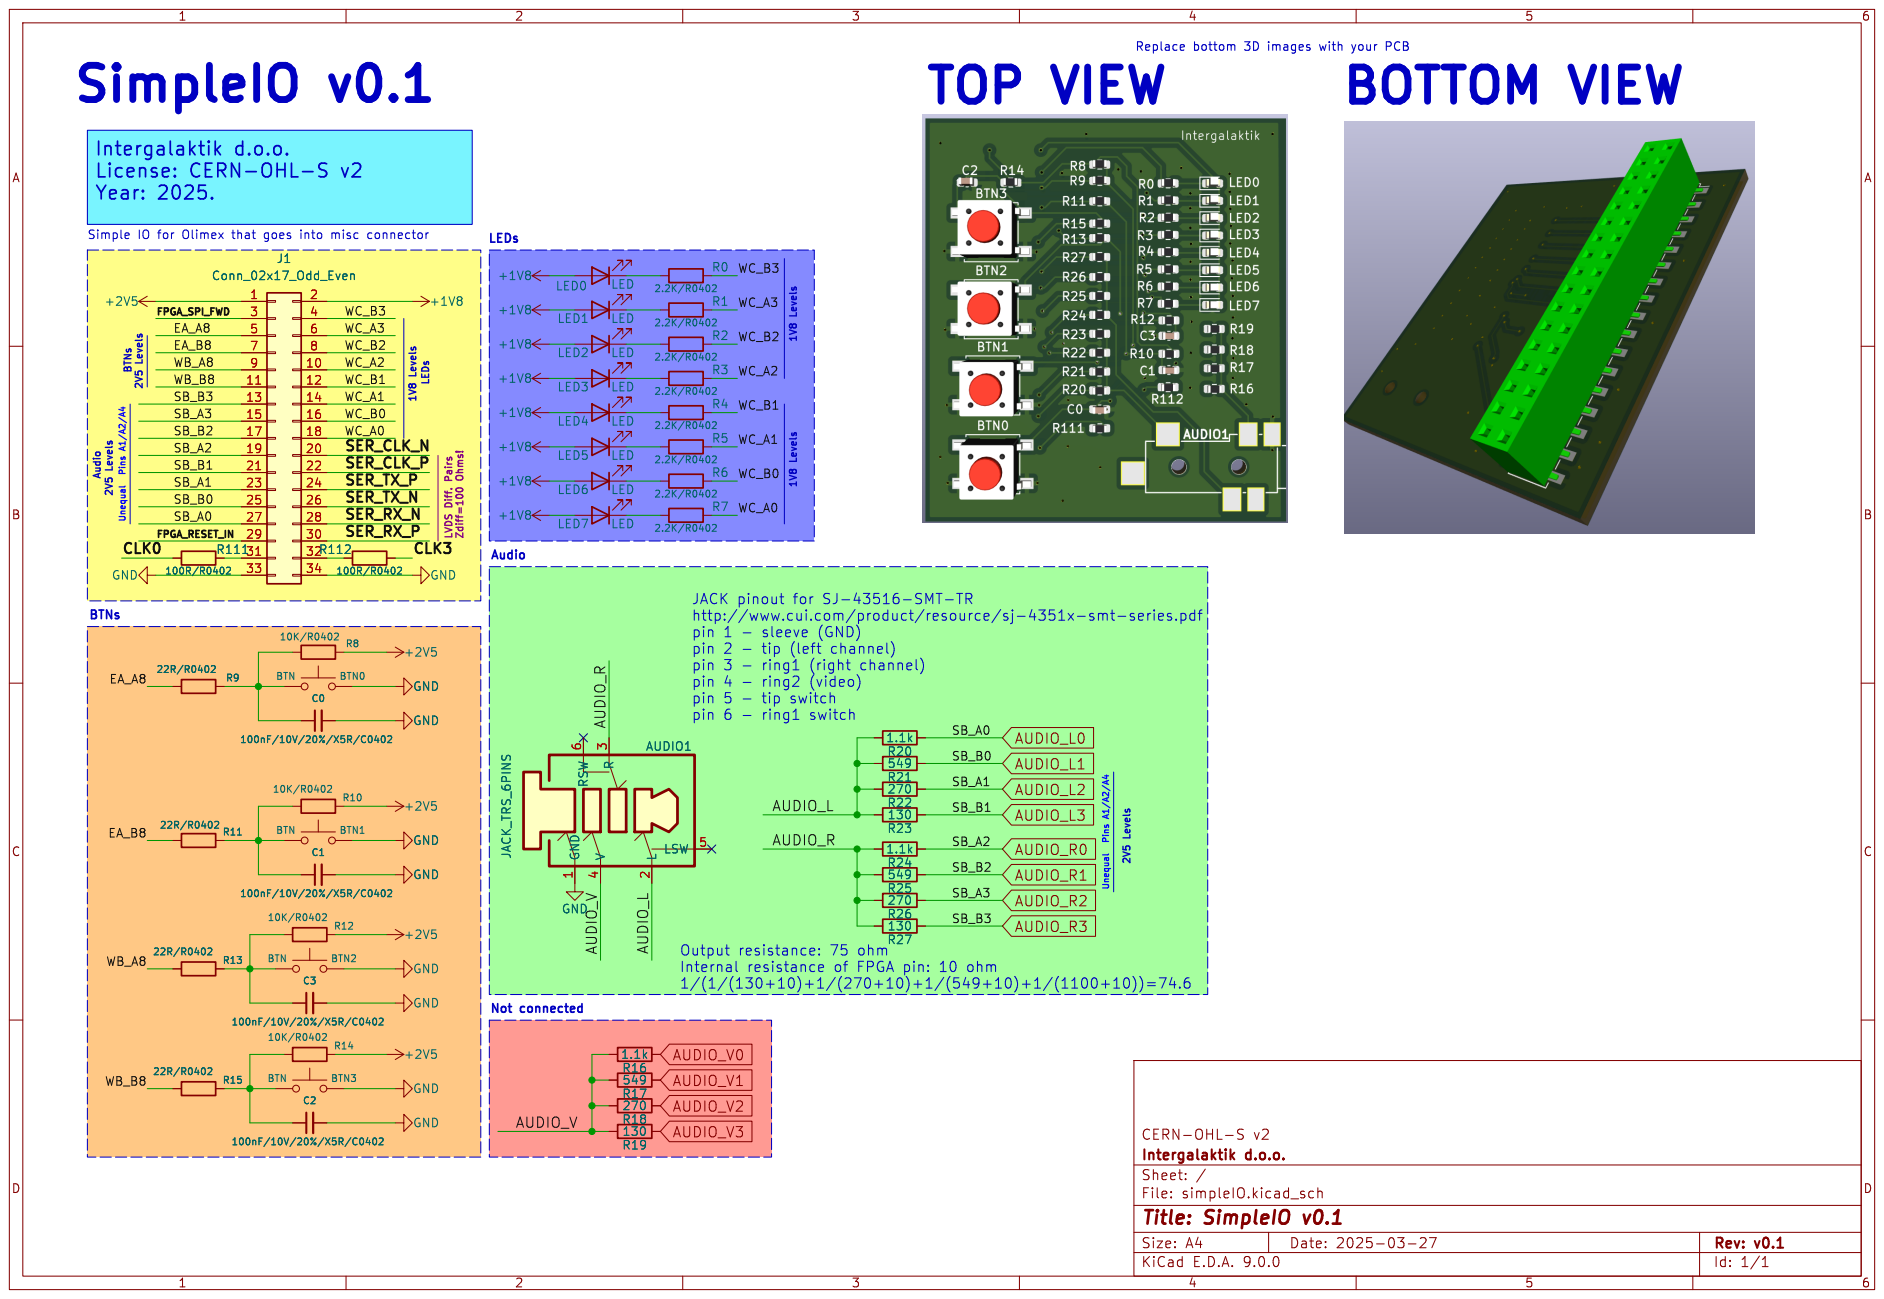
[picture p54: page 1]

Replace bottom 3D images with your PCB 1V8 Levels 1V8 Levels

JACK pinout for SJ-43516-SMT-TR
http://www.cui.com/product/resource/sj-4351x-smt-series.pdf
pin 1 - sleeve (GND)
pin 2 - tip (left channel)
pin 3 - ring1 (right channel)
pin 4 - ring2 (video)
pin 5 - tip switch
