intergalaktik/Extension_Boards_for_Olimex_GateMate/GamePad_I2S_audio_Buttons/doc/GamePad_I2S_audio.pdf

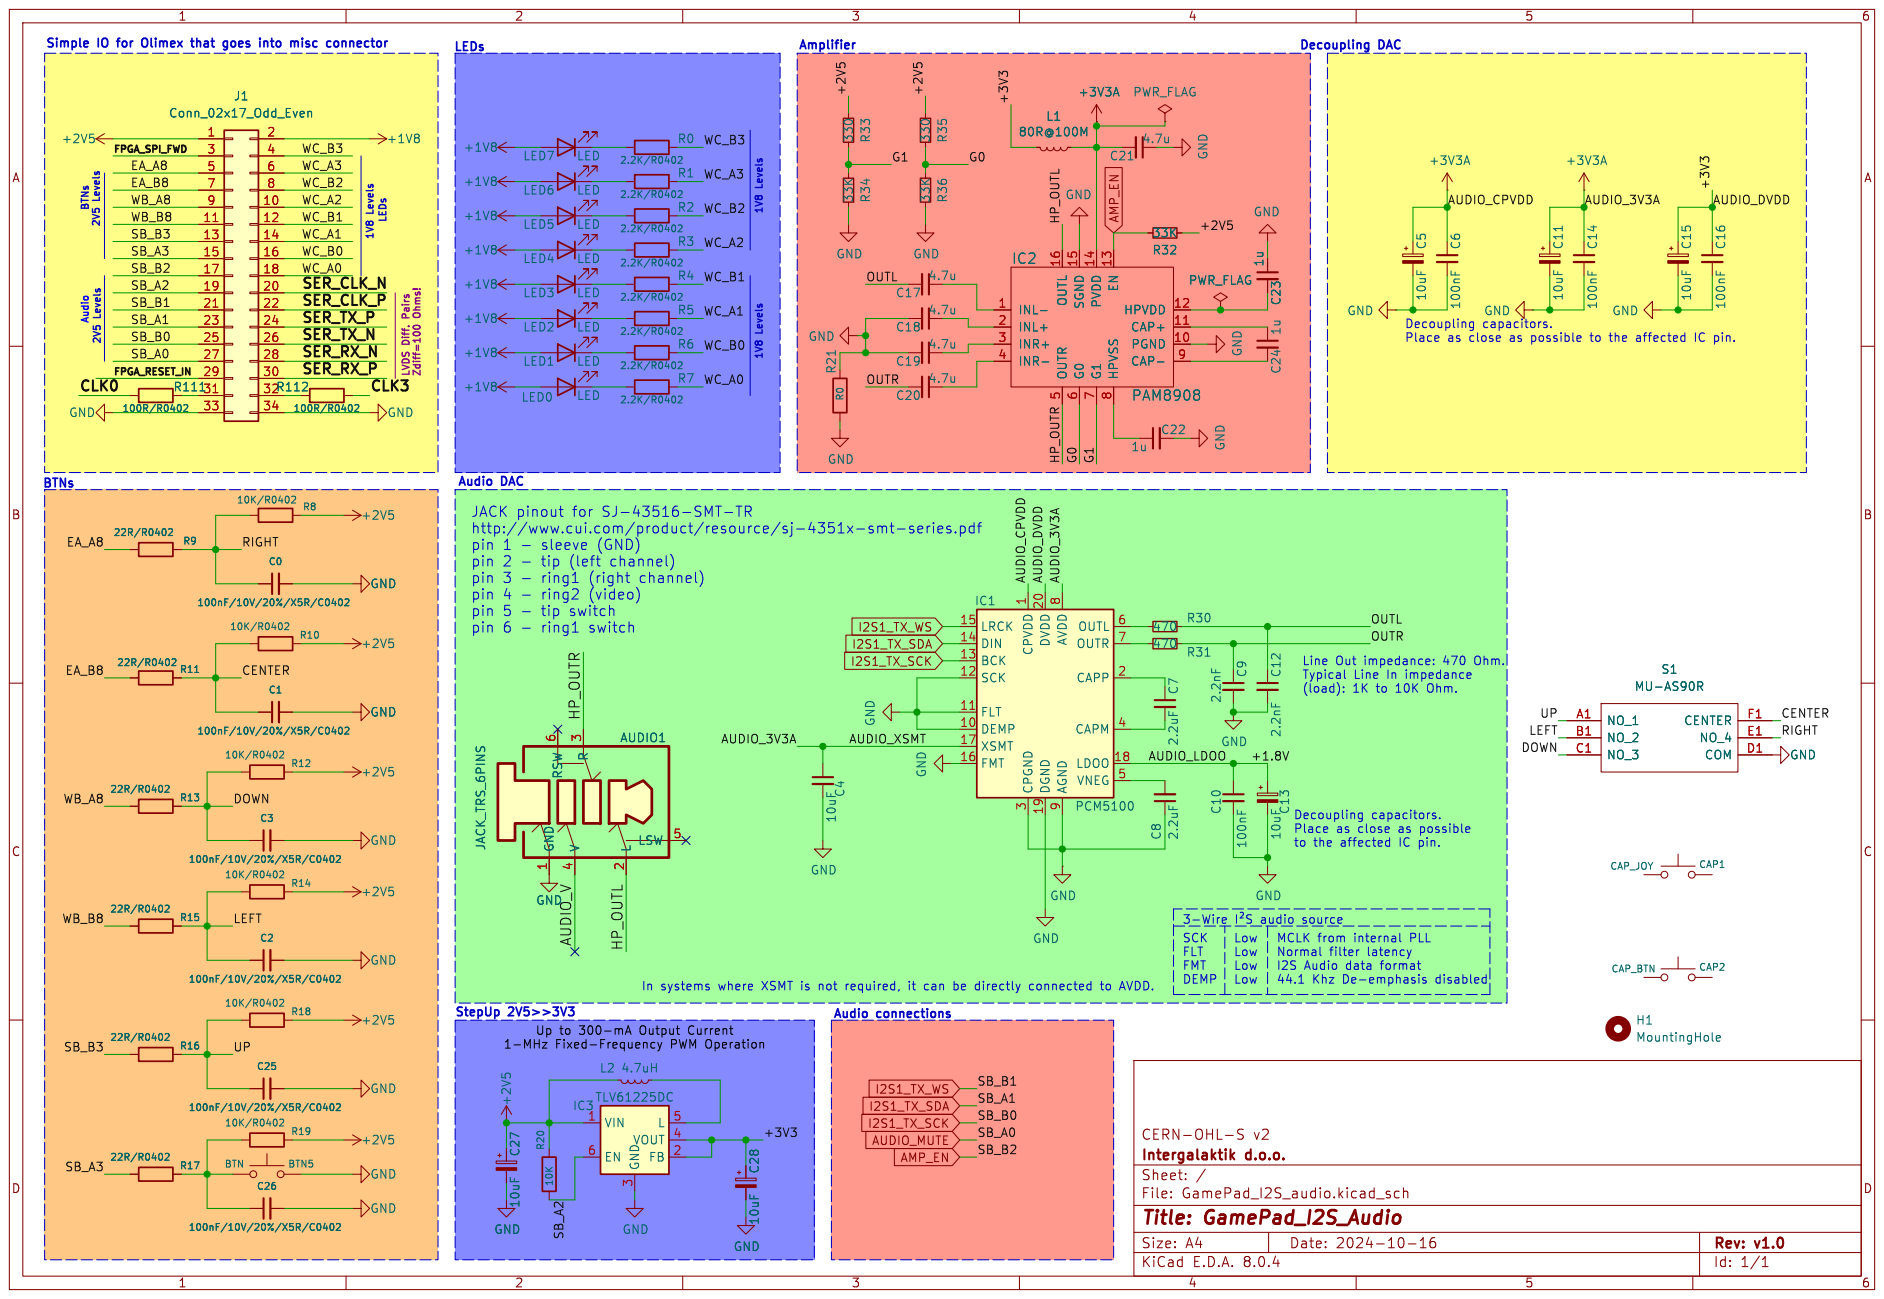
[picture p55: page 1]

Simple IO for Olimex that goes into misc connector

Audio DAC LVDS Diff. Pairs Zdiff=100 Ohms!

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

1 DEMP 10 FLT 11 SCK 12 BCK 13 DIN 14

3 CAPM 4 VNEG 5 OUTL 6 OUTR 7 AVDD
470 CPVDD
