intergalaktik/Extension_Boards_for_Olimex_GateMate/dualTranslation/dualTranslation.pdf

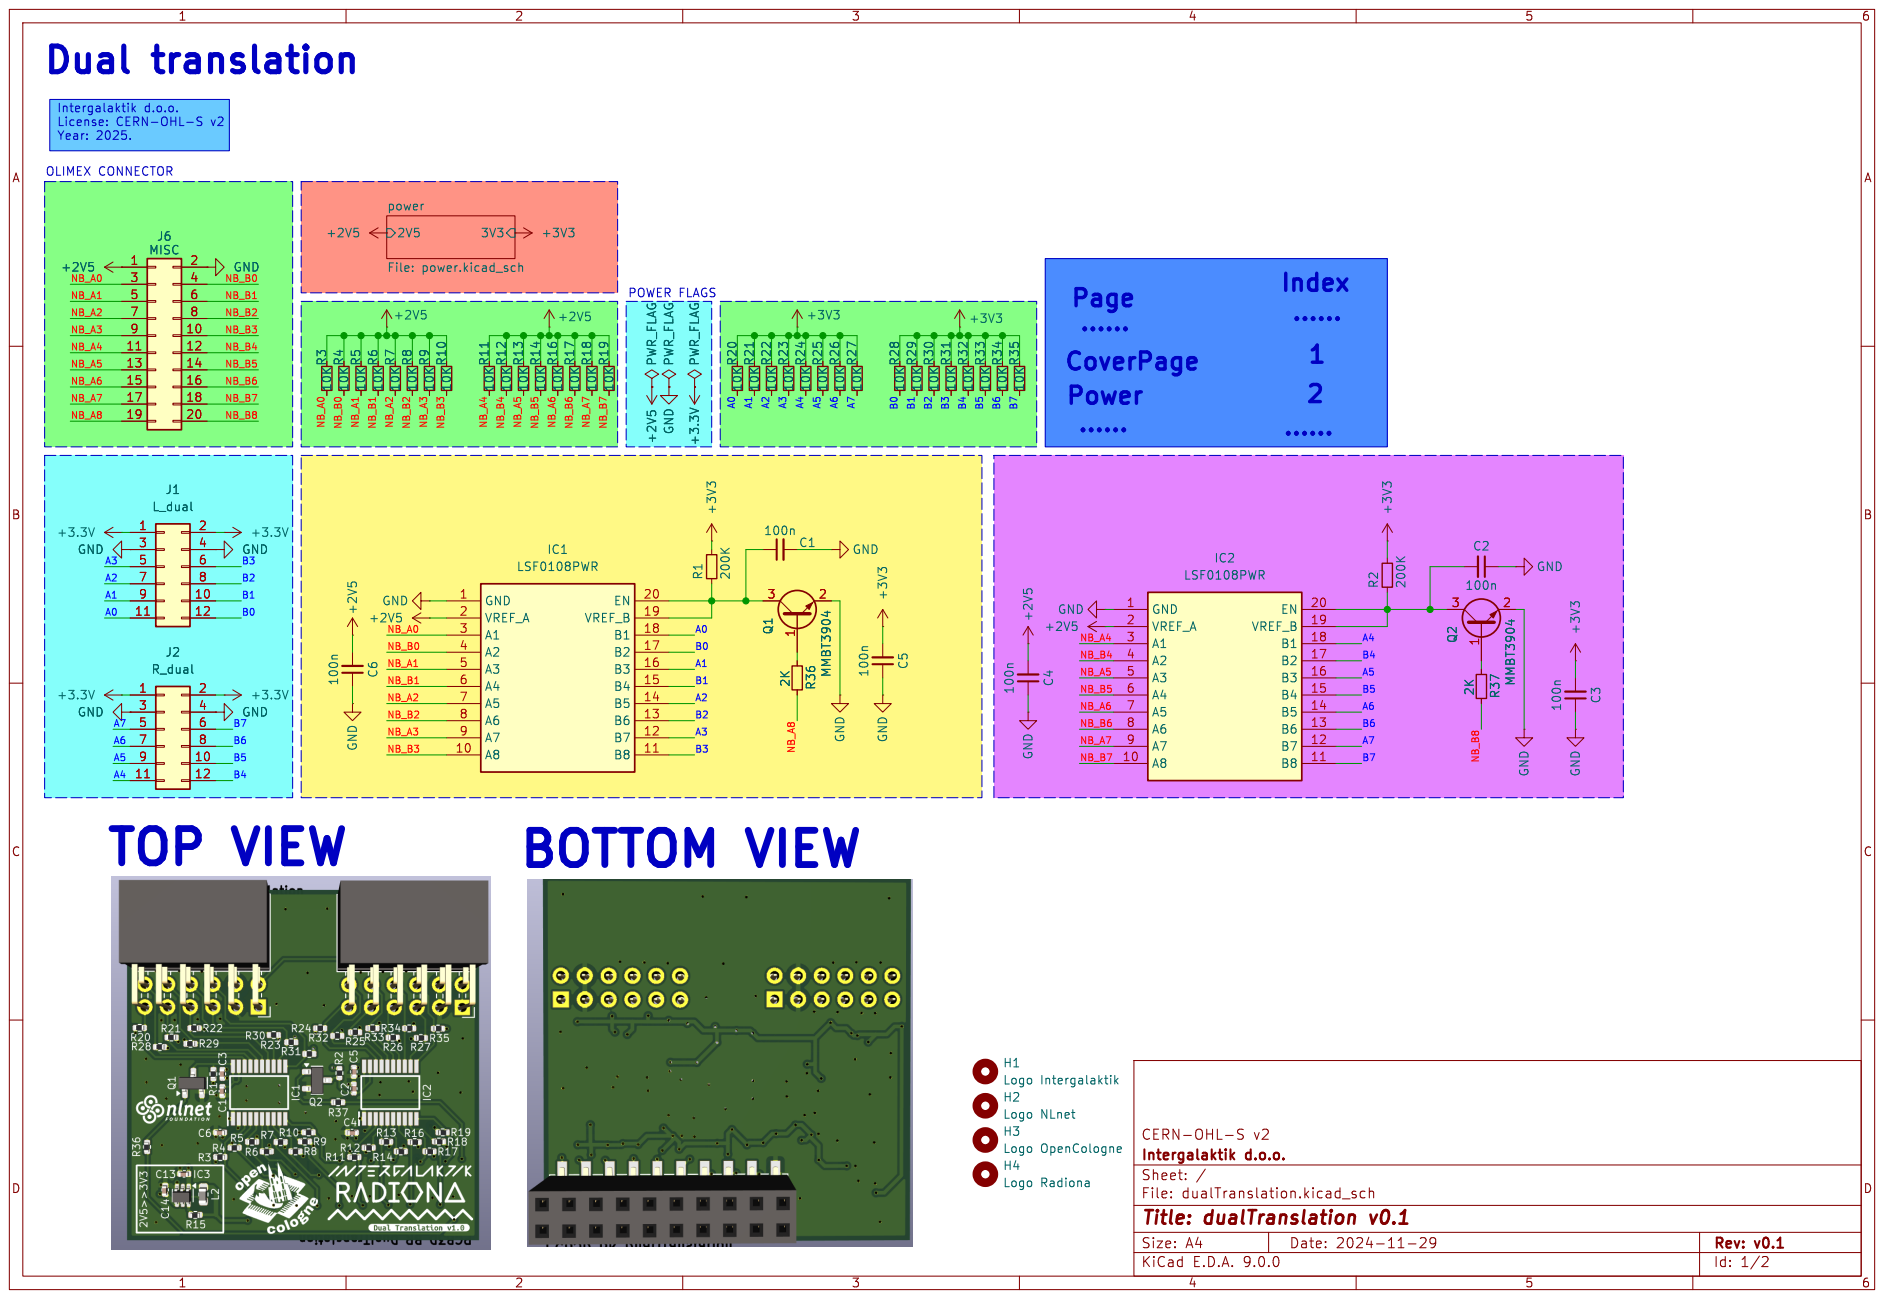
[picture p56: page 1]

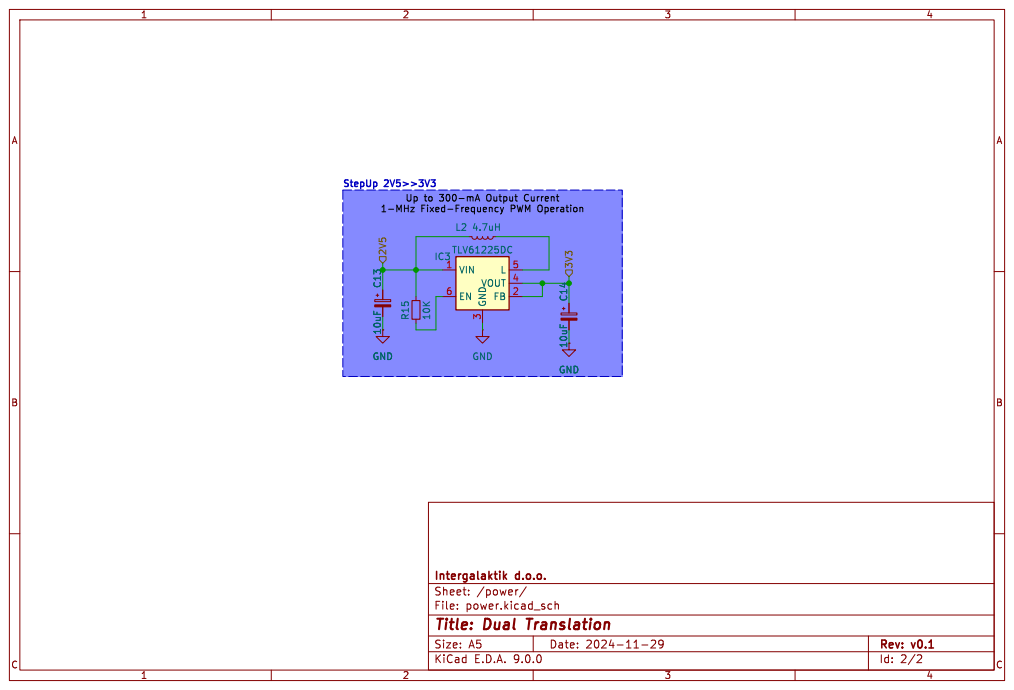
[picture p57: page 2]

Id: 2/2 Title: Dual Translation
