intergalaktik/Extension_Boards_for_Olimex_GateMate/dualTranslation/dualTranslation.kicad_pcb

## KiCad design dualTranslation/dualTranslation.kicad_pcb (2025-06-30)

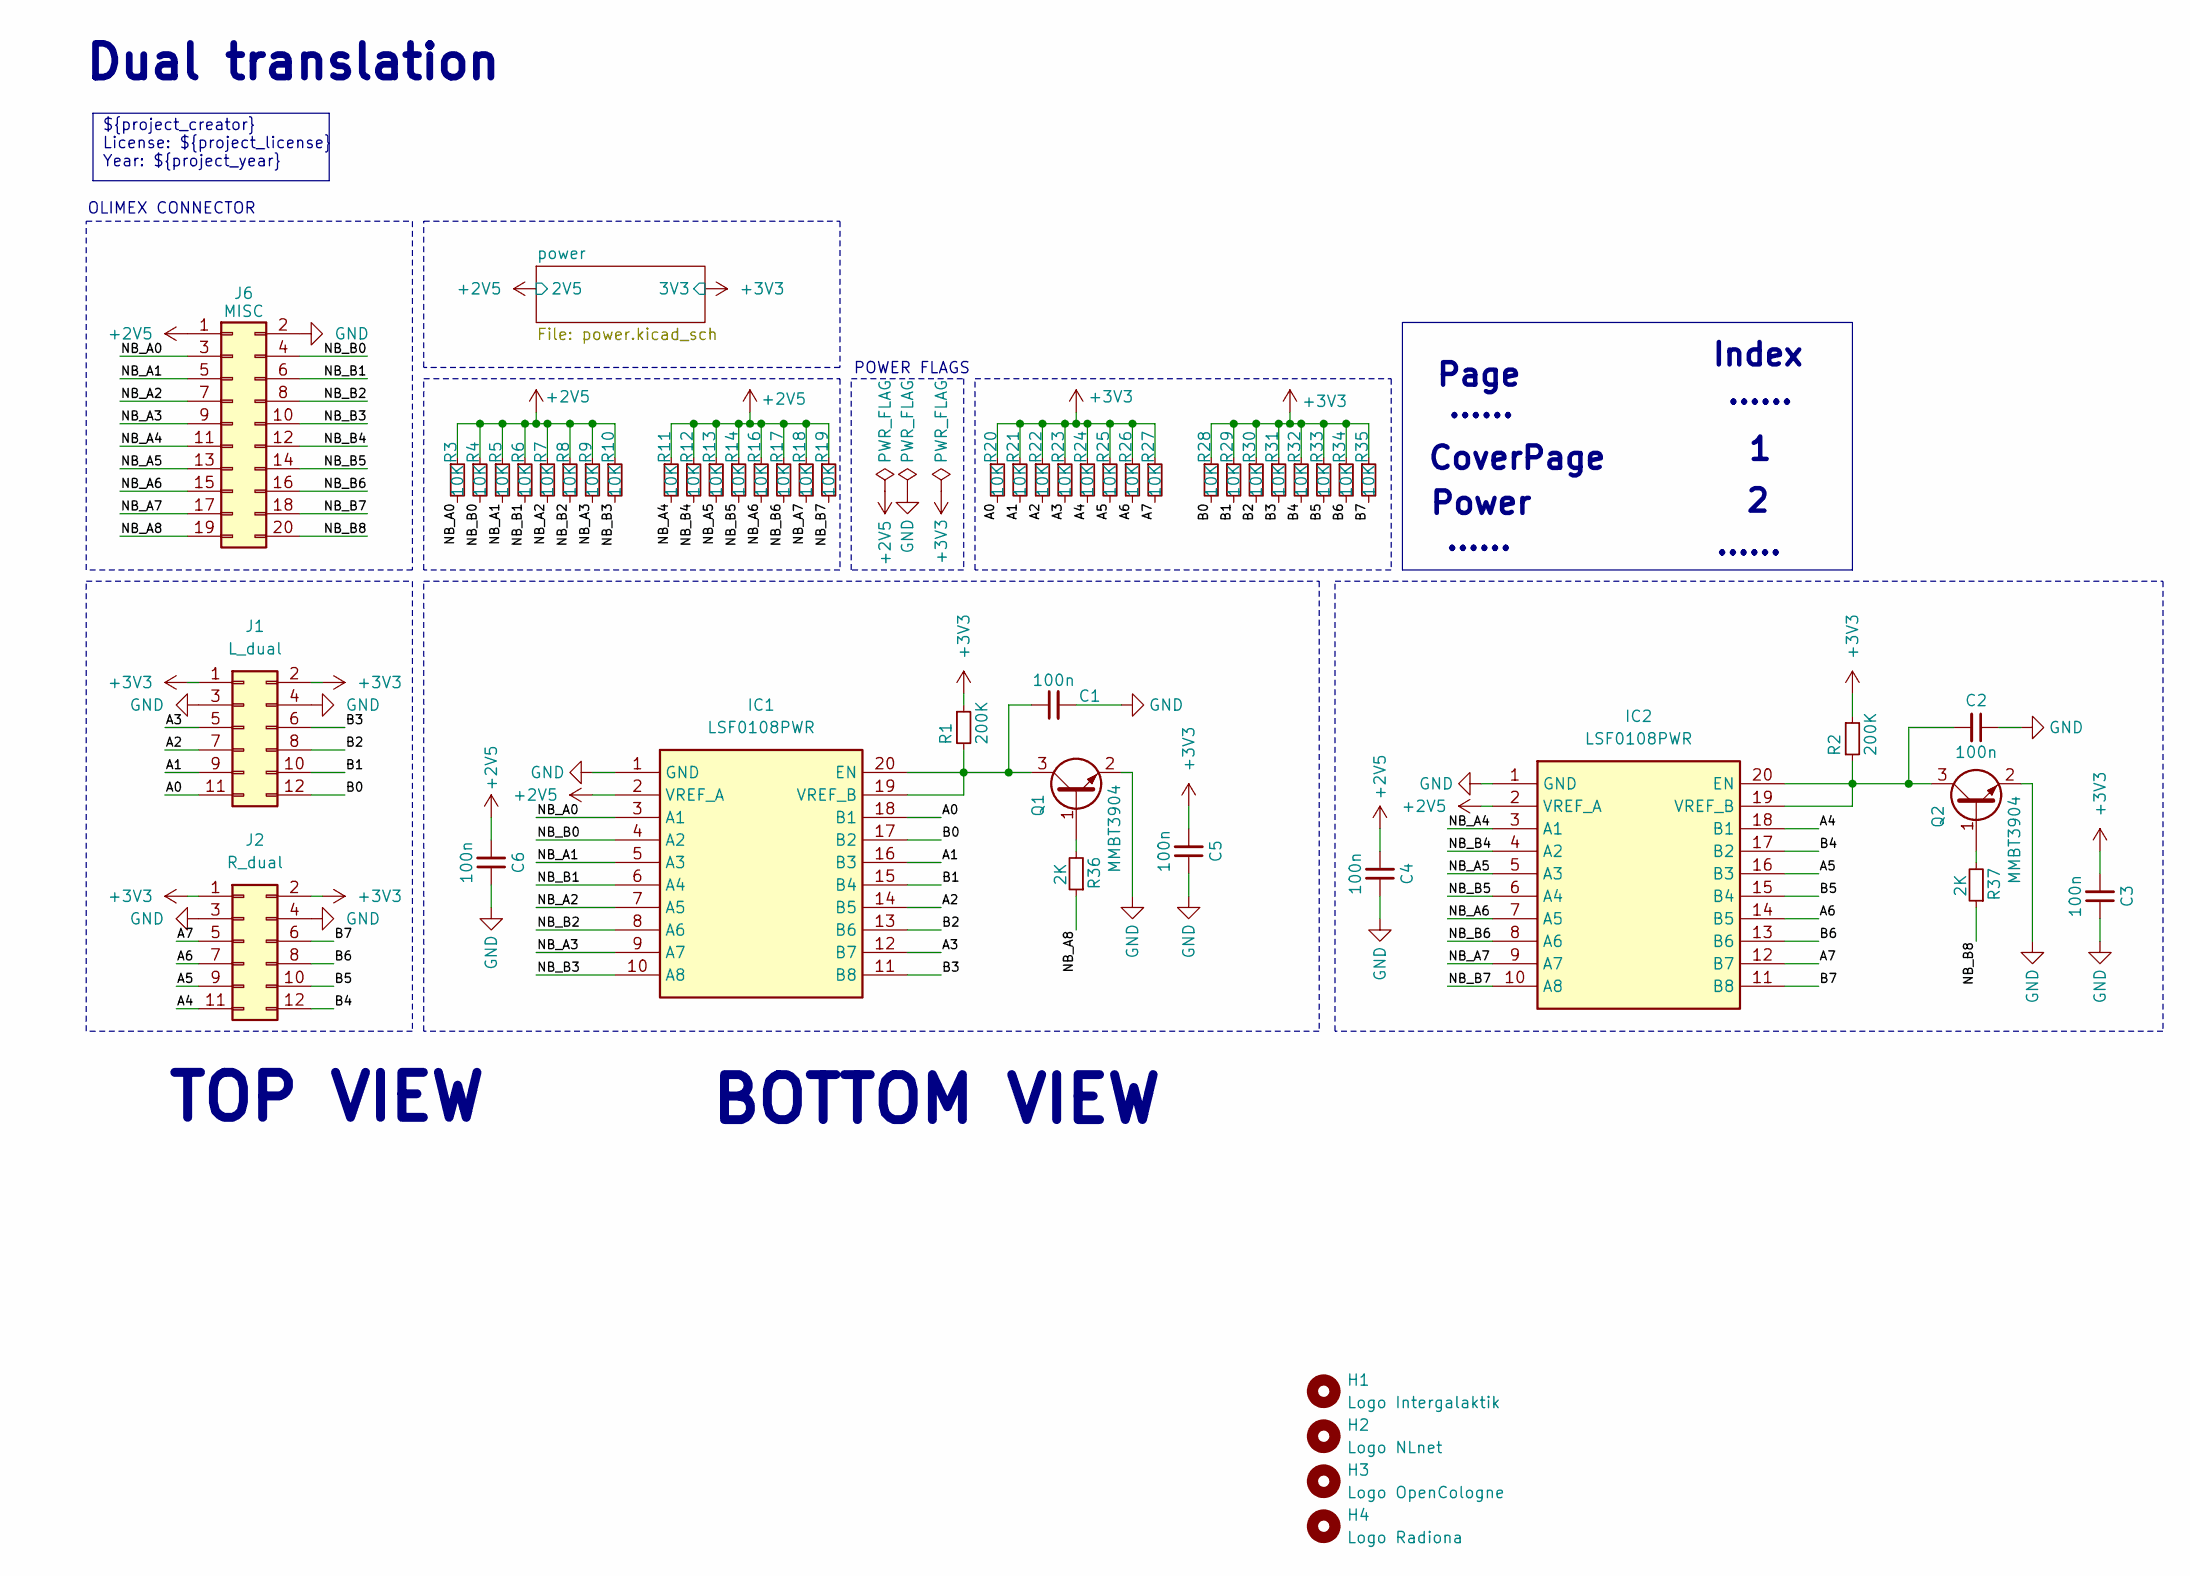
[picture p58: schematic dualTranslation.kicad_sch, ${project_name} ${project_version}]

Parts:
C1, C2, C3, C4, C5, C6: 100n; C_0402_1005Metric
H1: Logo Intergalaktik; intergalaktik
H2: Logo NLnet; nlnet
H3: Logo OpenCologne; open_cologne
H4: Logo Radiona; radiona
IC1, IC2: LSF0108PWR; SOP65P640X120-20N; Mouser Part Number 595-LSF0108PWR
J1: L_dual; PinSocket_2x06_P2.54mm_Horizontal
J2: R_dual; PinSocket_2x06_P2.54mm_Horizontal
J6: MISC; PinSocket_2x10_P2.54mm_Vertical_SMD
Q1, Q2: MMBT3904; SOT-23
R1, R2: 200K; R_0402_1005Metric; MPN RC0603FR-071K1L; Mouser 603-RC0603FR-071K1L
R3, R4, R5, R6, R7, R8, R9, R10, R11, R12, R13, R14, R16, R17, R18, R19, R20, R21, R22, R23, R24, R25, R26, R27, R28, R29, R30, R31, R32, R33, R34, R35: 10K; R_0402_1005Metric; MPN RC0603FR-071K1L; Mouser 603-RC0603FR-071K1L
R36, R37: 2K; R_0402_1005Metric; MPN RC0603FR-071K1L; Mouser 603-RC0603FR-071K1L

Connections:
+2V5: C4.2, C6.2, IC1.2 (VREF_A), IC2.2 (VREF_A), J6.1, R3.1, R4.1, R5.1, R6.1, R7.1, R8.1, R9.1, R10.1, R11.1, R12.1, R13.1, R14.1, R16.1, R17.1, R18.1, R19.1; also elsewhere on the board
+3V3: C3.2, C5.2, J1.1, J1.2, J2.1, J2.2, R1.1, R2.1, R20.1, R21.1, R22.1, R23.1, R24.1, R25.1, R26.1, R27.1, R28.1, R29.1, R30.1, R31.1, R32.1, R33.1, R34.1, R35.1; also elsewhere on the board
/A0: IC1.18 (B1), J1.11, R20.2
/A1: IC1.16 (B3), J1.9, R21.2
/A2: IC1.14 (B5), J1.7, R22.2
/A3: IC1.12 (B7), J1.5, R23.2
/A4: IC2.18 (B1), J2.11, R24.2
/A5: IC2.16 (B3), J2.9, R25.2
/A6: IC2.14 (B5), J2.7, R26.2
/A7: IC2.12 (B7), J2.5, R27.2
/B0: IC1.17 (B2), J1.12, R28.2
/B1: IC1.15 (B4), J1.10, R29.2
/B2: IC1.13 (B6), J1.8, R30.2
/B3: IC1.11 (B8), J1.6, R31.2
/B4: IC2.17 (B2), J2.12, R32.2
/B5: IC2.15 (B4), J2.10, R33.2
/B6: IC2.13 (B6), J2.8, R34.2
/B7: IC2.11 (B8), J2.6, R35.2
/NB_A0: IC1.3 (A1), J6.3, R3.2
/NB_A1: IC1.5 (A3), J6.5, R5.2
/NB_A2: IC1.7 (A5), J6.7, R7.2
/NB_A3: IC1.9 (A7), J6.9, R9.2
/NB_A4: IC2.3 (A1), J6.11, R11.2
/NB_A5: IC2.5 (A3), J6.13, R13.2
/NB_A6: IC2.7 (A5), J6.15, R16.2
/NB_A7: IC2.9 (A7), J6.17, R18.2
/NB_A8: J6.19, R36.1
/NB_B0: IC1.4 (A2), J6.4, R4.2
/NB_B1: IC1.6 (A4), J6.6, R6.2
/NB_B2: IC1.8 (A6), J6.8, R8.2
/NB_B3: IC1.10 (A8), J6.10, R10.2
/NB_B4: IC2.4 (A2), J6.12, R12.2
/NB_B5: IC2.6 (A4), J6.14, R14.2
/NB_B6: IC2.8 (A6), J6.16, R17.2
/NB_B7: IC2.10 (A8), J6.18, R19.2
/NB_B8: J6.20, R37.1
GND: C1.2, C2.1, C3.1, C4.1, C5.1, C6.1, IC1.1 (GND), IC2.1 (GND), J1.3, J1.4, J2.3, J2.4, J6.2, Q1.2 (E), Q2.2 (E); also elsewhere on the board
unnamed: C1.1, IC1.19 (VREF_B), IC1.20 (EN), Q1.3 (C), R1.2
unnamed: C2.2, IC2.19 (VREF_B), IC2.20 (EN), Q2.3 (C), R2.2
unnamed: Q1.1 (B), R36.2
unnamed: Q2.1 (B), R37.2

Notes on the sheet:
......
${project_creator} License: ${project_license} Year: ${project_year}
OLIMEX CONNECTOR
Dual translation
CoverPage
Page
Power
Index
TOP VIEW
POWER FLAGS
BOTTOM VIEW

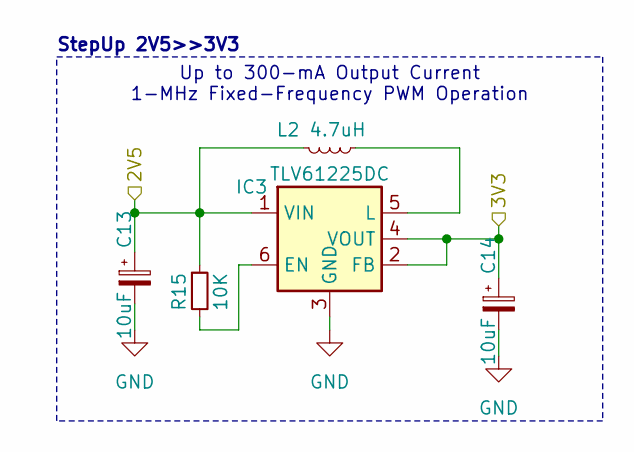
[picture p59: schematic power.kicad_sch, Dual Translation]

Parts:
C13, C14: 10uF; C_0402_1005Metric
IC3: TLV61225DC; SOT-363_SC-70-6
L2: 4.7uH; L_0603_1608Metric
R15: 10K; R_0402_1005Metric; MPN RC0603FR-071K1L; Mouser 603-RC0603FR-071K1L

Connections:
+2V5: C13.1, IC3.1 (VIN), L2.2, R15.1; also elsewhere on the board
+3V3: C14.1, IC3.2 (FB), IC3.4 (VOUT); also elsewhere on the board
GND: C13.2, C14.2, IC3.3 (GND); also elsewhere on the board
unnamed: IC3.6 (EN), R15.2
unnamed: IC3.5 (L), L2.1

Notes on the sheet:
Up to 300-mA Output Current 1-MHz Fixed-Frequency PWM Operation
StepUp 2V5>>3V3

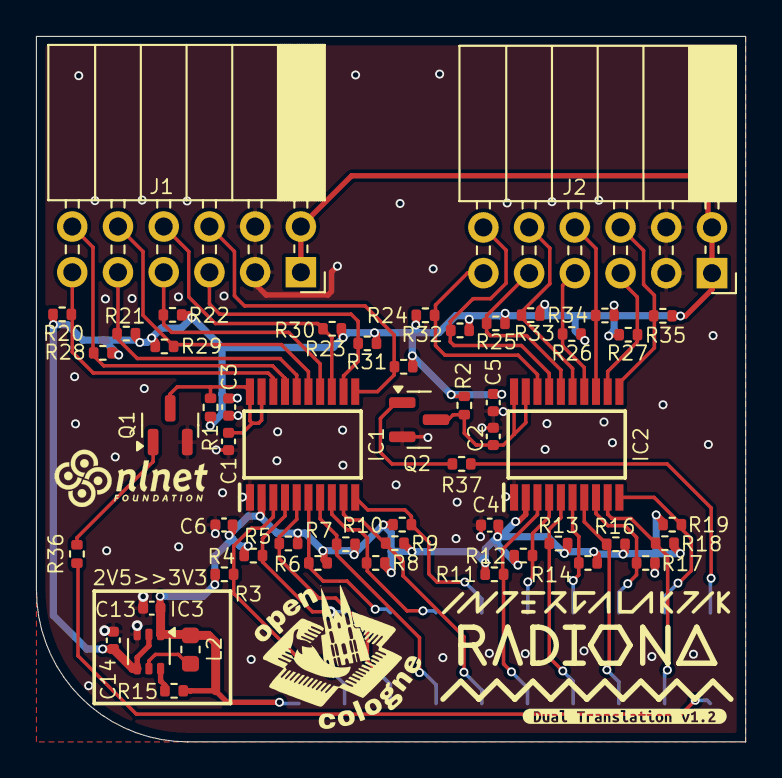
[picture p60: board dualTranslation.kicad_pcb from above]

Board: 4 copper layers, 39.4 x 39.2 mm, 59 parts (1 on the bottom side), 43 nets.

Other parts of the board:
kibuzzard-686100D9: G***; kibuzzard-686100D9
