intergalaktik/Extension_Boards_for_Olimex_GateMate/USB/USB.kicad_pcb

## KiCad design USB/USB.kicad_pcb (2025-04-24)

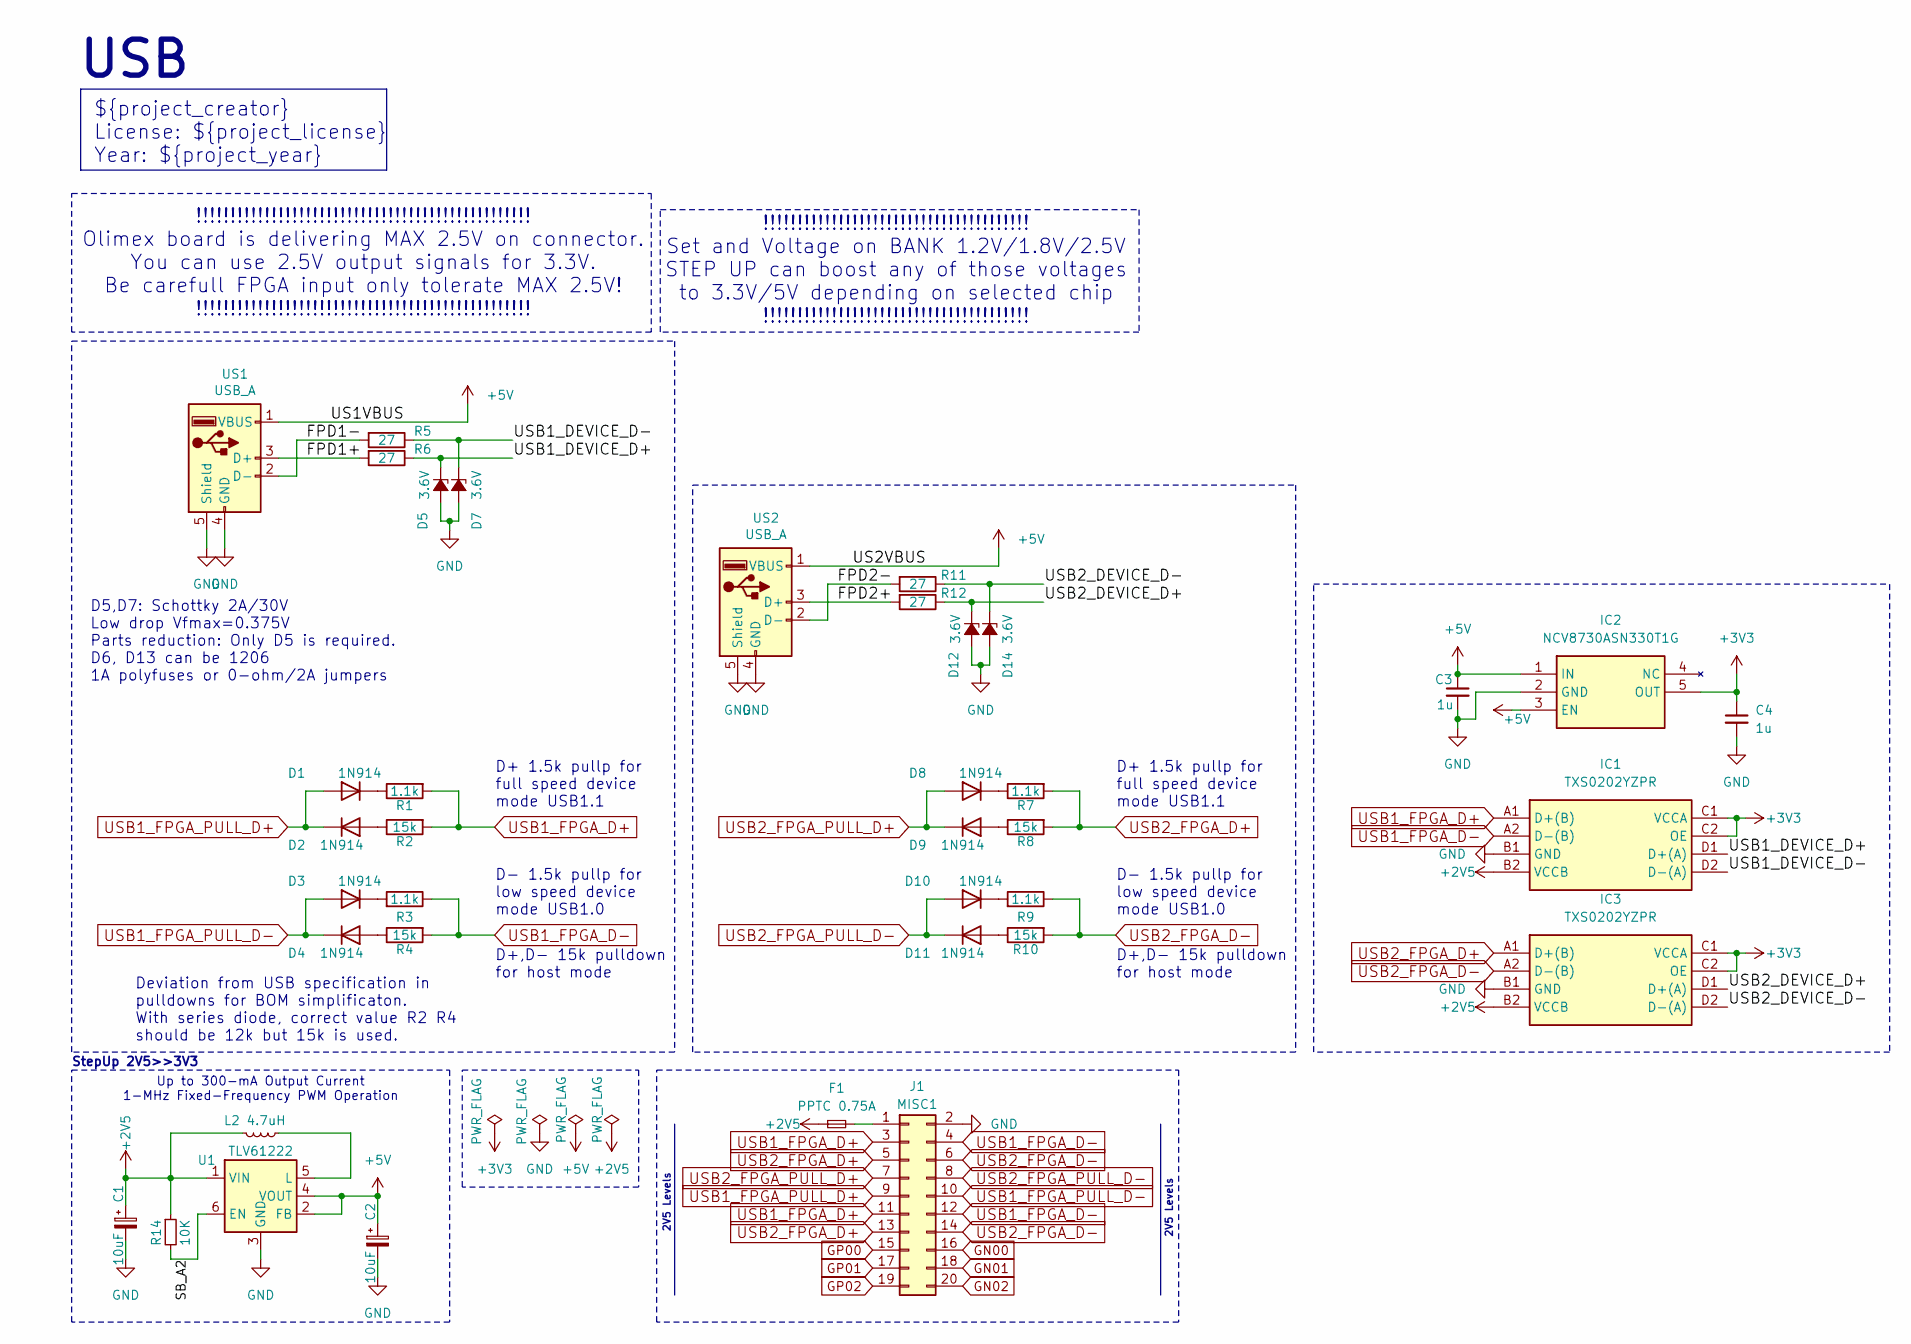
[picture p61: schematic USB.kicad_sch, ${project_name} ${project_version}]

Parts:
C1, C2: 10uF; C_0603_1608Metric
C3, C4: 1u; C_0603_1608Metric
D1, D2, D4, D8, D9, D11: 1N914; D_SOD-323_HandSoldering
D3, D10: 1N914; D_SOD-323_HandSoldering; MPN 1N4148WS
D5, D7, D12, D14: 3.6V; D_SOD-323_HandSoldering; MPN BZT52C3V6S; Mouser 833-BZT52C3V6S-TP
F1: PPTC 0.75A; Fuse_1206_3216Metric; Mouser 652-MF-NSMF075-2
IC1, IC3: TXS0202YZPR; BGA8C50P2X4_89X189X50; Mouser Part Number 595-TXS0202YZPR
IC2: NCV8730ASN330T1G; SOT95P275X110-5N; Mouser Part Number 863-NCV8730ASN330T1G
J1: MISC1; PinSocket_2x10_P2.54mm_Vertical_SMD
L2: 4.7uH; L_0603_1608Metric
R1, R3, R7, R9: 1.1k; R_0603_1608Metric
R2, R4, R8, R10: 15k; R_0603_1608Metric
R5, R6, R11, R12: 27; R_0603_1608Metric; MPN AC0603JR-0727RL
R14: 10K; R_0402_1005Metric; MPN RC0603FR-071K1L; Mouser 603-RC0603FR-071K1L
U1: TLV61222; SOT-363_SC-70-6
US1, US2: USB_A; USB_A_Stewart_SS-52100-001_Horizontal

Connections:
+2V5: C1.1, F1.1, IC1.B2 (VCCB), IC3.B2 (VCCB), L2.2, R14.1, U1.1 (VIN)
+3V3: C4.1, IC1.C1 (VCCA), IC1.C2 (OE), IC2.5 (OUT), IC3.C1 (VCCA), IC3.C2 (OE)
+5V: C2.1, C3.1, IC2.1 (IN), IC2.3 (EN), U1.2 (FB), U1.4 (VOUT), US1.1 (VBUS), US2.1 (VBUS)
/FPD1+: R6.2, US1.3 (D+)
/FPD1-: R5.2, US1.2 (D-)
/FPD2+: R12.2, US2.3 (D+)
/FPD2-: R11.2, US2.2 (D-)
/SB_A2: R14.2, U1.6 (EN)
/USB1_DEVICE_D+: D5.1 (K), IC1.D1 (D+(A)), R6.1
/USB1_DEVICE_D-: D7.1 (K), IC1.D2 (D-(A)), R5.1
/USB2_DEVICE_D+: D12.1 (K), IC3.D1 (D+(A)), R12.1
/USB2_DEVICE_D-: D14.1 (K), IC3.D2 (D-(A)), R11.1
GN00: J1.16
GN01: J1.18
GN02: J1.20
GND: C1.2, C2.2, C3.2, C4.2, D5.2 (A), D7.2 (A), D12.2 (A), D14.2 (A), IC1.B1 (GND), IC2.2 (GND), IC3.B1 (GND), J1.2, U1.3 (GND), US1.4 (GND), US1.5 (Shield), US2.4 (GND), US2.5 (Shield)
GP00: J1.15
GP01: J1.17
GP02: J1.19
unnamed: D1.1 (K), R1.1
unnamed: D2.2 (A), R2.1
unnamed: D3.1 (K), R3.2
unnamed: D4.2 (A), R4.1
unnamed: D8.1 (K), R7.1
unnamed: D9.2 (A), R8.1
unnamed: D10.1 (K), R9.2
unnamed: D11.2 (A), R10.1
unnamed: F1.2, J1.1
unnamed: L2.1, U1.5 (L)
USB1_FPGA_D+: IC1.A1 (D+(B)), J1.3, J1.11, R1.2, R2.2
USB1_FPGA_D-: IC1.A2 (D-(B)), J1.4, J1.12, R3.1, R4.2
USB1_FPGA_PULL_D+: D1.2 (A), D2.1 (K), J1.9
USB1_FPGA_PULL_D-: D3.2 (A), D4.1 (K), J1.10
USB2_FPGA_D+: IC3.A1 (D+(B)), J1.5, J1.13, R7.2, R8.2
USB2_FPGA_D-: IC3.A2 (D-(B)), J1.6, J1.14, R9.1, R10.2
USB2_FPGA_PULL_D+: D8.2 (A), D9.1 (K), J1.7
USB2_FPGA_PULL_D-: D10.2 (A), D11.1 (K), J1.8

Notes on the sheet:
2V5 Levels
D+,D- 15k pulldown for host mode
Up to 300-mA Output Current 1-MHz Fixed-Frequency PWM Operation
Deviation from USB specification in pulldowns for BOM simplificaton. With series diode, correct value R2 R4 should be 12k but 15k is used.
D+ 1.5k pullp for full speed device mode USB1.1
!!!!!!!!!!!!!!!!!!!!!!!!!!!!!!!!!!!!!!!!!!!!!!!!! Olimex board is delivering MAX 2.5V on connector. You can use 2.5V output signals for 3.3V. Be carefull FPGA input only tolerate MAX 2.5V! !!!!!!!!!!!!!!!!!!!!!!!!!!!!!!!!!!!!!!!!!!!!!!!!!
D- 1.5k pullp for low speed device mode USB1.0
StepUp 2V5>>3V3
${project_creator} License: ${project_license} Year: ${project_year}
D5,D7: Schottky 2A/30V Low drop Vfmax=0.375V Parts reduction: Only D5 is required. D6, D13 can be 1206 1A polyfuses or 0-ohm/2A jumpers
USB
!!!!!!!!!!!!!!!!!!!!!!!!!!!!!!!!!!!!!!! Set and Voltage on BANK 1.2V/1.8V/2.5V STEP UP can boost any of those voltages to 3.3V/5V depending on selected chip !!!!!!!!!!!!!!!!!!!!!!!!!!!!!!!!!!!!!!!

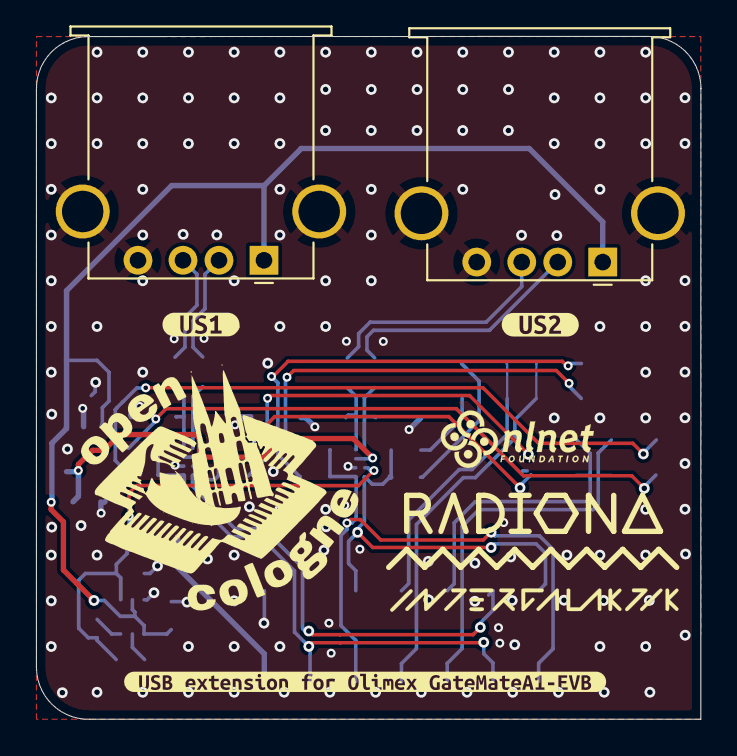
[picture p62: board USB.kicad_pcb from above]

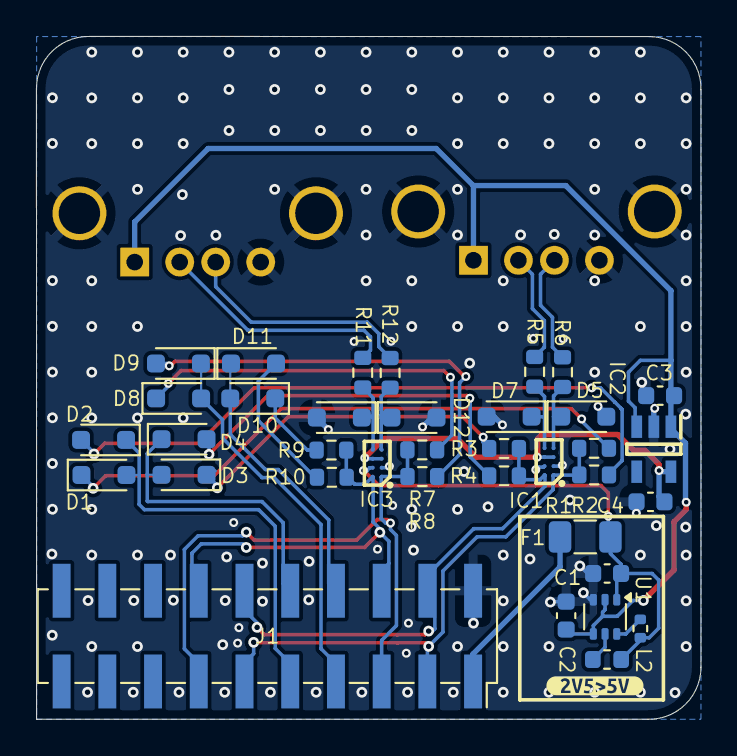
[picture p63: board USB.kicad_pcb from below]

Board: 4 copper layers, 36.9 x 37.9 mm, 46 parts (37 on the bottom side), 31 nets.

Other parts of the board:
Intergalaktik: Intergalaktik; Intergalaktik logo
NLNet: NLNet; nlnet
OpenCologne: OpenCologne; open_cologne
kibuzzard-67445C48: G***; kibuzzard-67445C48
kibuzzard-67445D8F: G***; kibuzzard-67445D8F
kibuzzard-674459A0: G***; kibuzzard-674459A0
kibuzzard-6744599A: G***; kibuzzard-6744599A
radiona: radiona
