intergalaktik/Extension_Boards_for_Olimex_GateMate/ethIO/ethIO.kicad_pcb

## KiCad design ethIO/ethIO.kicad_pcb (2024-12-11)

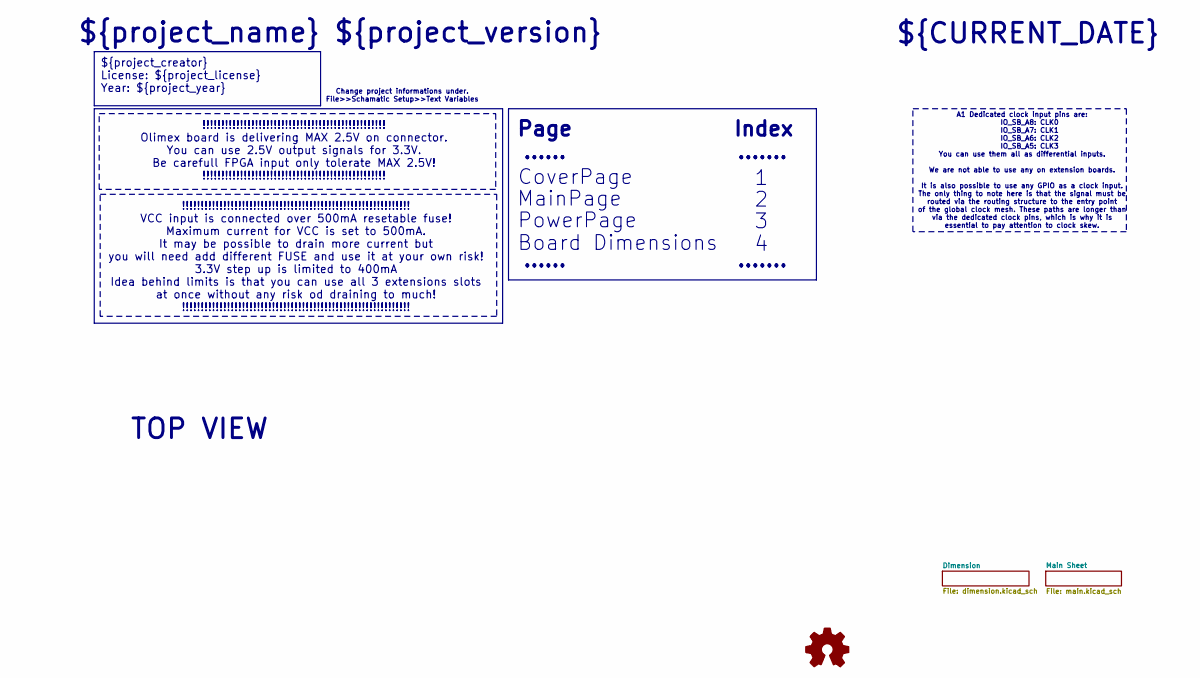
[picture p64: schematic ethIO.kicad_sch, ${project_name} ${project_version}]

Notes on the sheet:
${project_creator} License: ${project_license} Year: ${project_year}
Index
!!!!!!!!!!!!!!!!!!!!!!!!!!!!!!!!!!!!!!!!!!!!!!!!!!!!!!!!!!!!! VCC input is connected over 500mA resetable fuse! Maximum current for VCC is set to 500mA. It may be possible to drain more current but you will need add different FUSE and use it at your own risk! 3.3V step up is limited to 400mA Idea b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
!!!!!!!!!!!!!!!!!!!!!!!!!!!!!!!!!!!!!!!!!!!!!!!!! Olimex board is delivering MAX 2.5V on connector. You can use 2.5V output signals for 3.3V. Be carefull FPGA input only tolerate MAX 2.5V! !!!!!!!!!!!!!!!!!!!!!!!!!!!!!!!!!!!!!!!!!!!!!!!!!
......
PowerPage
Change project informations under. File>>Schamatic Setup>>Text Variables
.......
A1 Dedicated clock input pins are: IO_SB_A8: CLK0 IO_SB_A7: CLK1 IO_SB_A6: CLK2 IO_SB_A5: CLK3 You can use them all as differential inputs. We are not able to use any on extension boards. It is also possible to use any GPIO as a clock input. The only thing to note here is that the signal must be ro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
CoverPage
Board Dimensions
MainPage
${CURRENT_DATE}
${project_name} ${project_version}
TOP VIEW
Page

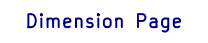
[picture p65: schematic dimension.kicad_sch, ${project_name} ${project_version}]

Notes on the sheet:
Dimension Page

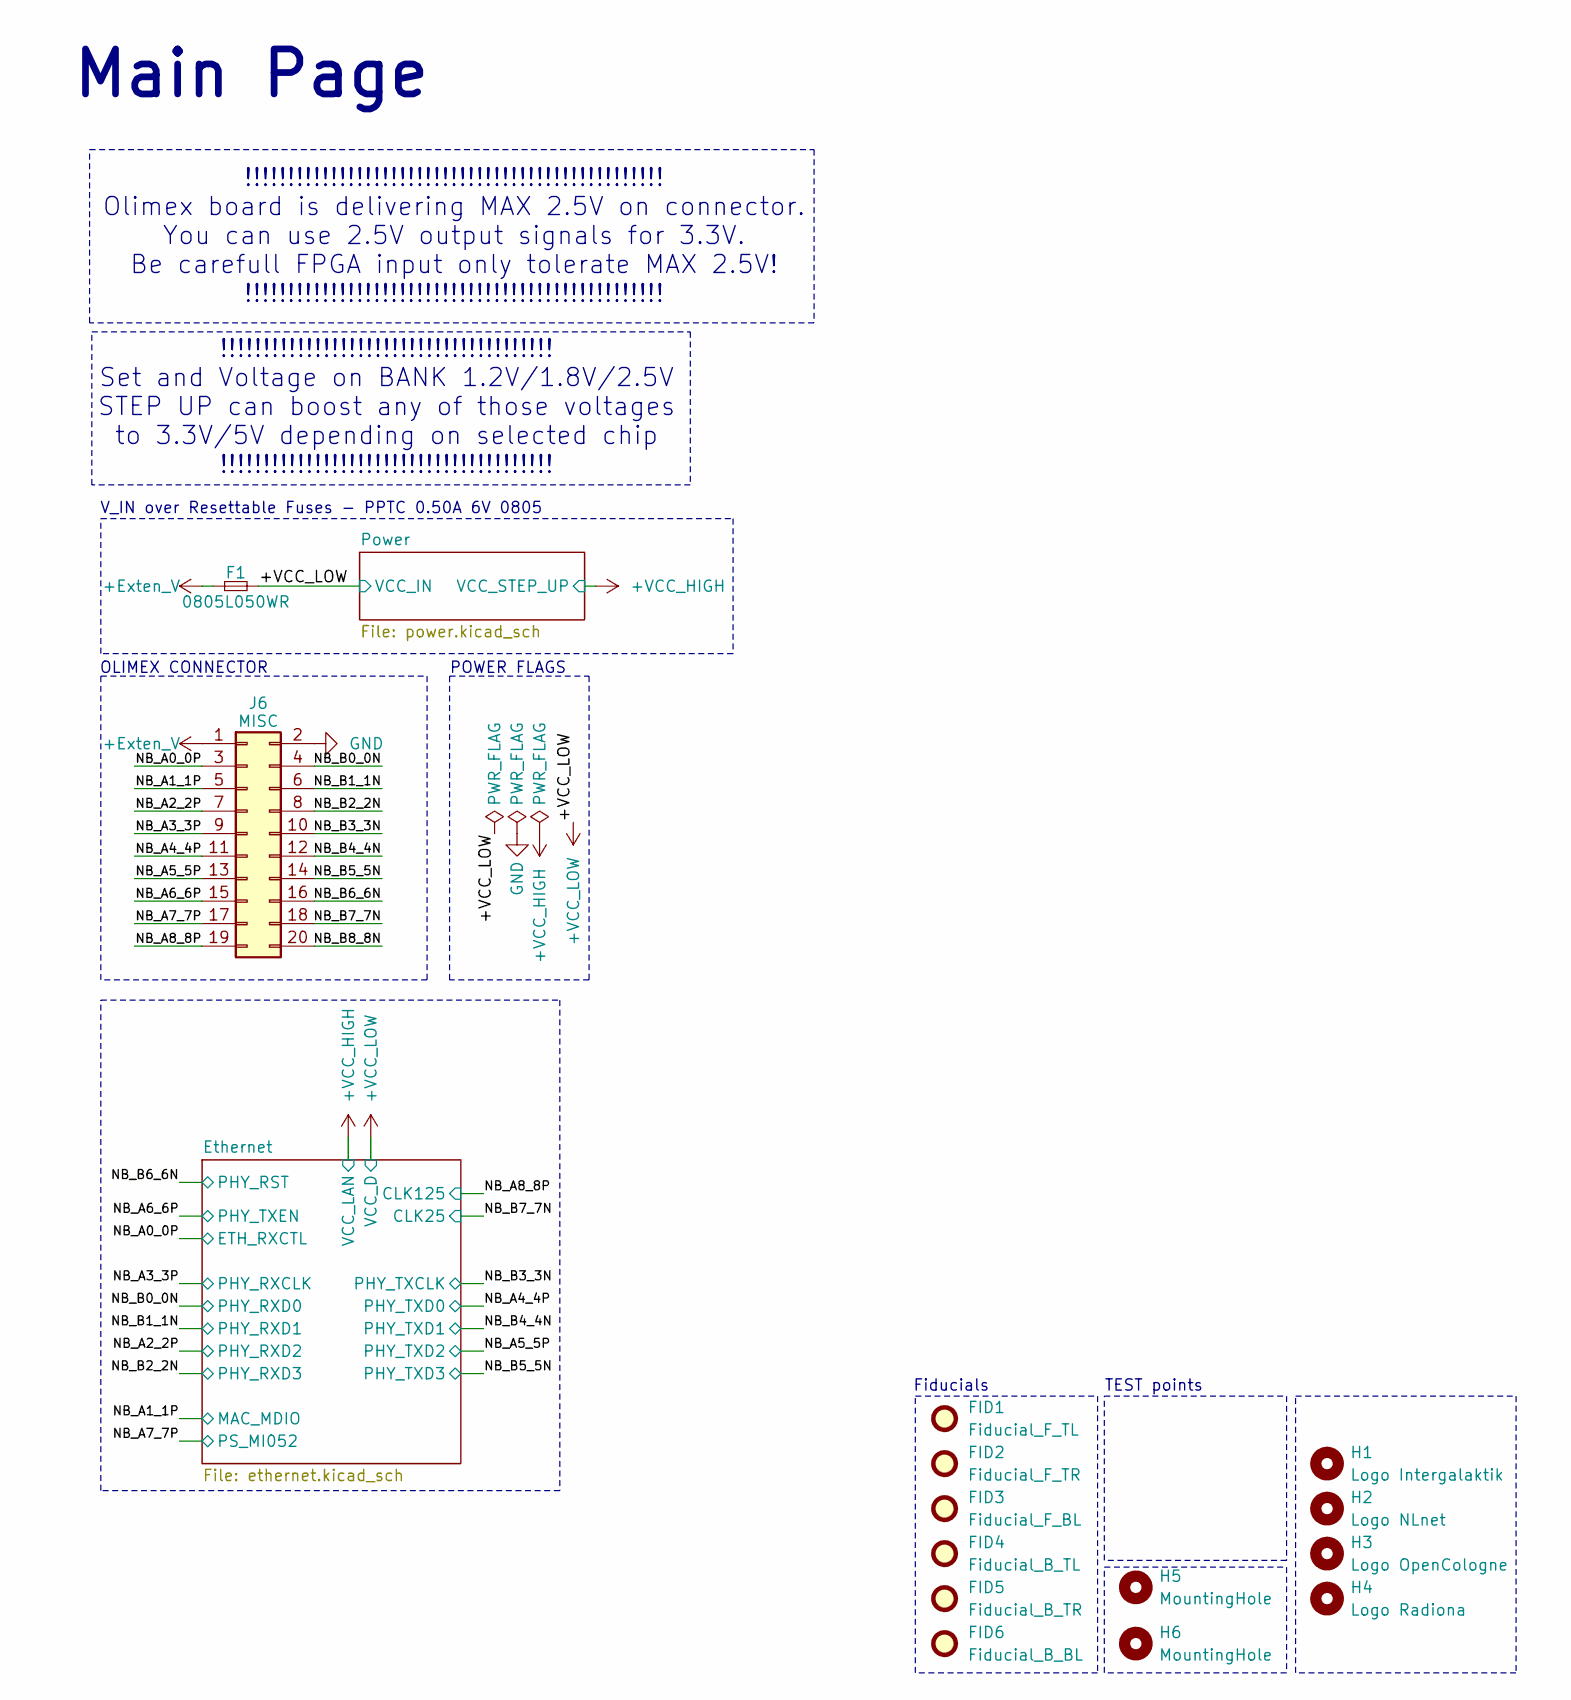
[picture p66: schematic main.kicad_sch, ${project_name} ${project_version}]

Parts:
F1: 0805L050WR; Fuse_0805_2012Metric
FID1: Fiducial_F_TL; Fiducial_0.5mm_Mask1mm
FID2: Fiducial_F_TR; Fiducial_0.5mm_Mask1mm
FID3: Fiducial_F_BL; Fiducial_0.5mm_Mask1mm
FID4: Fiducial_B_TL; Fiducial_0.5mm_Mask1mm
FID5: Fiducial_B_TR; Fiducial_0.5mm_Mask1mm
FID6: Fiducial_B_BL; Fiducial_0.5mm_Mask1mm
H1: Logo Intergalaktik; intergalaktik
H2: Logo NLnet; nlnet
H3: Logo OpenCologne; open_cologne_small
H4: Logo Radiona; radiona_small
H5, H6: MountingHole; MountingHole_2.2mm_M2
J6: MISC; PinSocket_2x10_P2.54mm_Vertical_SMD

Connections:
+Exten_V: F1.1, J6.1
+VCC_LOW: F1.2; also elsewhere on the board
/Main Sheet/NB_A0_0P: J6.3; also elsewhere on the board
/Main Sheet/NB_A1_1P: J6.5; also elsewhere on the board
/Main Sheet/NB_A2_2P: J6.7; also elsewhere on the board
/Main Sheet/NB_A3_3P: J6.9; also elsewhere on the board
/Main Sheet/NB_A4_4P: J6.11; also elsewhere on the board
/Main Sheet/NB_A5_5P: J6.13; also elsewhere on the board
/Main Sheet/NB_A6_6P: J6.15; also elsewhere on the board
/Main Sheet/NB_A7_7P: J6.17; also elsewhere on the board
/Main Sheet/NB_A8_8P: J6.19; also elsewhere on the board
/Main Sheet/NB_B0_0N: J6.4; also elsewhere on the board
/Main Sheet/NB_B1_1N: J6.6; also elsewhere on the board
/Main Sheet/NB_B2_2N: J6.8; also elsewhere on the board
/Main Sheet/NB_B3_3N: J6.10; also elsewhere on the board
/Main Sheet/NB_B4_4N: J6.12; also elsewhere on the board
/Main Sheet/NB_B5_5N: J6.14; also elsewhere on the board
/Main Sheet/NB_B6_6N: J6.16; also elsewhere on the board
/Main Sheet/NB_B7_7N: J6.18; also elsewhere on the board
/Main Sheet/NB_B8_8N: J6.20
GND: J6.2; also elsewhere on the board

Notes on the sheet:
TEST points
POWER FLAGS
V_IN over Resettable Fuses - PPTC 0.50A 6V 0805
!!!!!!!!!!!!!!!!!!!!!!!!!!!!!!!!!!!!!!!!!!!!!!!!! Olimex board is delivering MAX 2.5V on connector. You can use 2.5V output signals for 3.3V. Be carefull FPGA input only tolerate MAX 2.5V! !!!!!!!!!!!!!!!!!!!!!!!!!!!!!!!!!!!!!!!!!!!!!!!!!
Fiducials
OLIMEX CONNECTOR
Main Page
!!!!!!!!!!!!!!!!!!!!!!!!!!!!!!!!!!!!!!! Set and Voltage on BANK 1.2V/1.8V/2.5V STEP UP can boost any of those voltages to 3.3V/5V depending on selected chip !!!!!!!!!!!!!!!!!!!!!!!!!!!!!!!!!!!!!!!

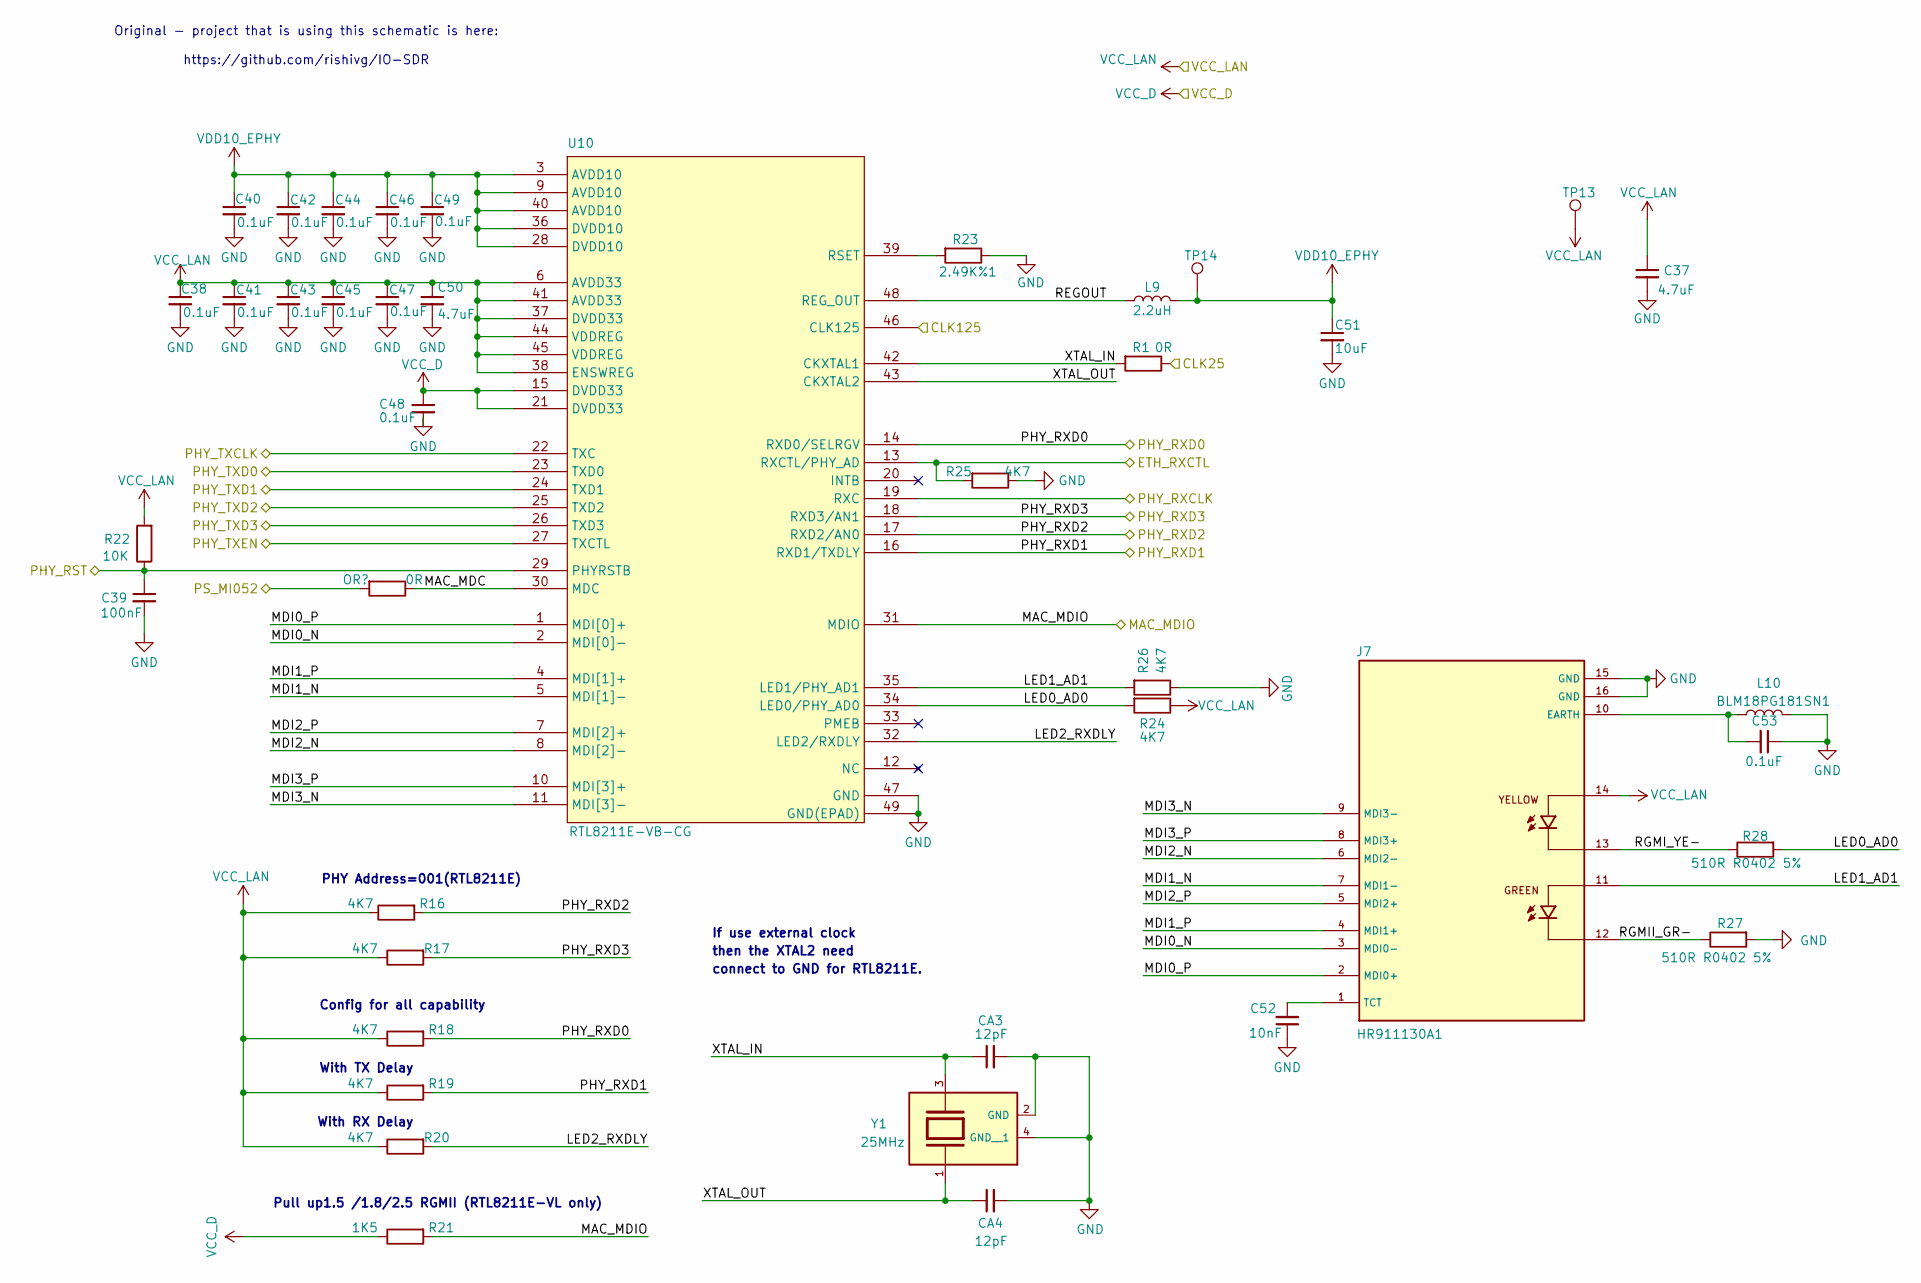
[picture p67: schematic ethernet.kicad_sch, ${project_name} ${project_version}]

Parts:
C37, C50: 4.7uF; C_0603_1608Metric_Pad1.08x0.95mm_HandSolder
C38, C40, C41, C42, C43, C44, C45, C46, C47, C48, C49: 0.1uF; C_0402_1005Metric_Pad0.74x0.62mm_HandSolder
C39: 100nF; C_0402_1005Metric_Pad0.74x0.62mm_HandSolder
C51: 10uF; C_0805_2012Metric_Pad1.18x1.45mm_HandSolder
C52: 10nF; C_0402_1005Metric_Pad0.74x0.62mm_HandSolder
C53: 0.1uF; C_0805_2012Metric_Pad1.18x1.45mm_HandSolder
CA3, CA4: 12pF; C_0402_1005Metric_Pad0.74x0.62mm_HandSolder
J7: HR911130A1; HR911130A_HAN
L9: 2.2uH; L_0603_1608Metric_Pad1.05x0.95mm_HandSolder
L10: BLM18PG181SN1; L_0603_1608Metric_Pad1.05x0.95mm_HandSolder
R1: 0R; R_0402_1005Metric_Pad0.72x0.64mm_HandSolder
R16, R17, R18, R19, R20, R24, R25, R26: 4K7; R_0402_1005Metric_Pad0.72x0.64mm_HandSolder
R21: 1K5; R_0402_1005Metric_Pad0.72x0.64mm_HandSolder
R22: 10K; R_0402_1005Metric_Pad0.72x0.64mm_HandSolder
R23: 2.49K%1; R_0402_1005Metric_Pad0.72x0.64mm_HandSolder
R27, R28: 510R R0402 5%; R_0402_1005Metric_Pad0.72x0.64mm_HandSolder
RA5: 0R; R_0603_1608Metric_Pad0.98x0.95mm_HandSolder
TP13, TP14: TestPoint; TestPoint_Pad_D1.0mm
U10: RTL8211E-VB-CG
Y1: 25MHz; Crystal_SMD_SeikoEpson_TSX3225-4Pin_3.2x2.5mm; PARTREV N/A

Connections:
+VCC_HIGH: C37.1, C38.1, C41.1, C43.1, C45.1, C47.1, C50.1, J7.14, R16.1, R17.1, R18.1, R19.1, R20.1, R22.2, R24.1, TP13.1, U10.6 (AVDD33), U10.37 (DVDD33), U10.38 (ENSWREG), U10.41 (AVDD33), U10.44 (VDDREG), U10.45 (VDDREG); also elsewhere on the board
+VCC_LOW: C48.1, R21.1, U10.15 (DVDD33), U10.21 (DVDD33); also elsewhere on the board
/Main Sheet/Ethernet/LED0_AD0: R24.2, R28.2, U10.34 (LED0/PHY_AD0)
/Main Sheet/Ethernet/LED1_AD1: J7.11, R26.2, U10.35 (LED1/PHY_AD1)
/Main Sheet/Ethernet/LED2_RXDLY: R20.2, U10.32 (LED2/RXDLY)
/Main Sheet/Ethernet/MAC_MDC: U10.30 (MDC); also elsewhere on the board
/Main Sheet/Ethernet/MDI0_N: J7.3 (MDI0-), U10.2 (MDI[0]-)
/Main Sheet/Ethernet/MDI0_P: J7.2 (MDI0+), U10.1 (MDI[0]+)
/Main Sheet/Ethernet/MDI1_N: J7.7 (MDI1-), U10.5 (MDI[1]-)
/Main Sheet/Ethernet/MDI1_P: J7.4 (MDI1+), U10.4 (MDI[1]+)
/Main Sheet/Ethernet/MDI2_N: J7.6 (MDI2-), U10.8 (MDI[2]-)
/Main Sheet/Ethernet/MDI2_P: J7.5 (MDI2+), U10.7 (MDI[2]+)
/Main Sheet/Ethernet/MDI3_N: J7.9 (MDI3-), U10.11 (MDI[3]-)
/Main Sheet/Ethernet/MDI3_P: J7.8 (MDI3+), U10.10 (MDI[3]+)
/Main Sheet/Ethernet/REGOUT: L9.1, U10.48 (REG_OUT)
/Main Sheet/Ethernet/RGMII_GR-: J7.12, R27.1
/Main Sheet/Ethernet/RGMI_YE-: J7.13, R28.1
/Main Sheet/Ethernet/XTAL_IN: CA3.1, R1.2, U10.42 (CKXTAL1), Y1.3
/Main Sheet/Ethernet/XTAL_OUT: CA4.1, U10.43 (CKXTAL2), Y1.1
/Main Sheet/NB_A0_0P: R25.2, U10.13 (RXCTL/PHY_AD); also elsewhere on the board
/Main Sheet/NB_A1_1P: R21.2, U10.31 (MDIO); also elsewhere on the board
/Main Sheet/NB_A2_2P: R16.2, U10.17 (RXD2/AN0); also elsewhere on the board
/Main Sheet/NB_A3_3P: U10.19 (RXC); also elsewhere on the board
/Main Sheet/NB_A4_4P: U10.23 (TXD0); also elsewhere on the board
/Main Sheet/NB_A5_5P: U10.25 (TXD2); also elsewhere on the board
/Main Sheet/NB_A6_6P: U10.27 (TXCTL); also elsewhere on the board
/Main Sheet/NB_A8_8P: U10.46 (CLK125); also elsewhere on the board
/Main Sheet/NB_B0_0N: R18.2, U10.14 (RXD0/SELRGV); also elsewhere on the board
/Main Sheet/NB_B1_1N: R19.2, U10.16 (RXD1/TXDLY); also elsewhere on the board
/Main Sheet/NB_B2_2N: R17.2, U10.18 (RXD3/AN1); also elsewhere on the board
/Main Sheet/NB_B3_3N: U10.22 (TXC); also elsewhere on the board
/Main Sheet/NB_B4_4N: U10.24 (TXD1); also elsewhere on the board
/Main Sheet/NB_B5_5N: U10.26 (TXD3); also elsewhere on the board
/Main Sheet/NB_B6_6N: C39.1, R22.1, U10.29 (PHYRSTB); also elsewhere on the board
/Main Sheet/NB_B7_7N: R1.1; also elsewhere on the board
GND: C37.2, C38.2, C39.2, C40.2, C41.2, C42.2, C43.2, C44.2, C45.2, C46.2, C47.2, C48.2, C49.2, C50.2, C51.2, C52.1, C53.1, CA3.2, CA4.2, J7.15 (GND), J7.16 (GND), L10.1, R23.1, R25.1, R26.1, R27.2, U10.47 (GND), U10.49 (GND(EPAD)), Y1.2 (GND), Y1.4 (GND__1); also elsewhere on the board
unnamed: C53.2, J7.10 (EARTH), L10.2
unnamed: C52.2, J7.1 (TCT)
unnamed: R23.2, U10.39 (RSET)
VDD10_EPHY: C40.1, C42.1, C44.1, C46.1, C49.1, C51.1, L9.2, TP14.1, U10.3 (AVDD10), U10.9 (AVDD10), U10.28 (DVDD10), U10.36 (DVDD10), U10.40 (AVDD10)

Notes on the sheet:
then the XTAL2 need
PHY Address=001(RTL8211E)
With RX Delay
Pull up1.5 /1.8/2.5 RGMII (RTL8211E-VL only)
connect to GND for RTL8211E.
If use external clock
Original - project that is using this schematic is here: https://github.com/rishivg/IO-SDR
Config for all capability
With TX Delay
