intergalaktik/Extension_Boards_for_Olimex_GateMate/ethIO/ethIO.kicad_pcb

## KiCad design ethIO/ethIO.kicad_pcb (continued)

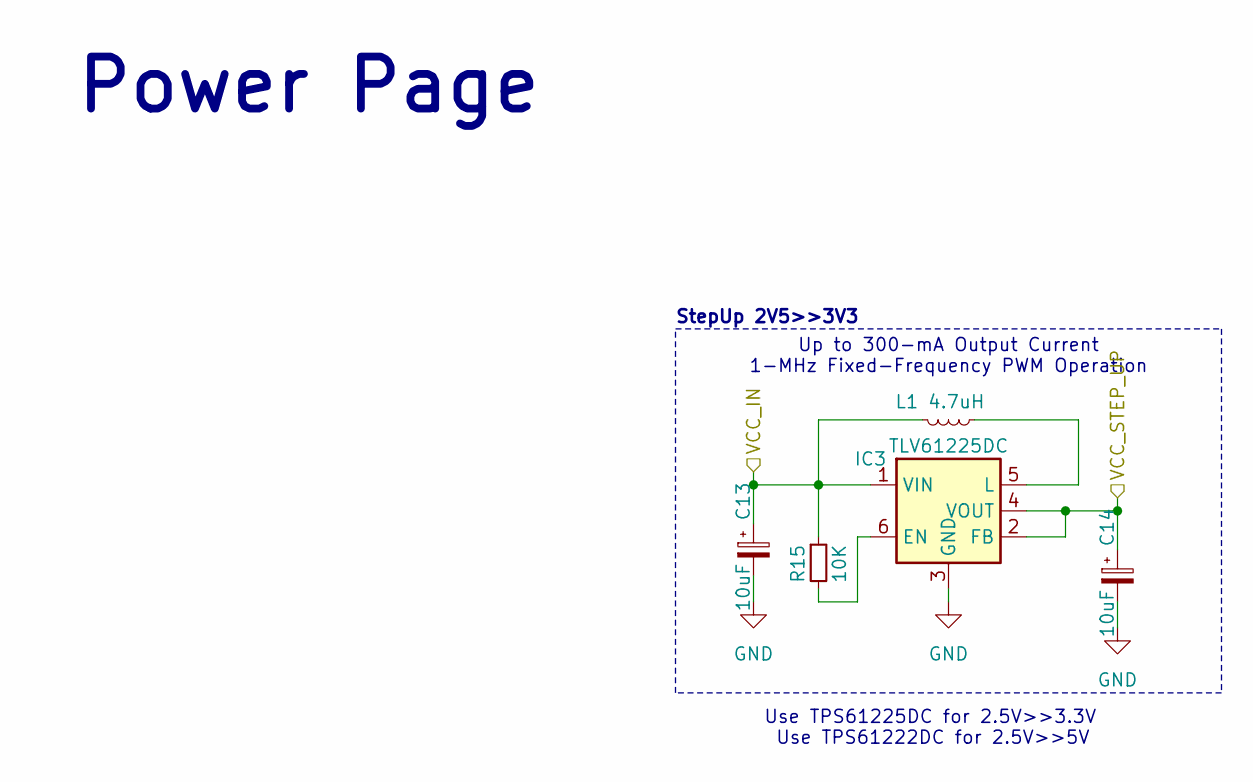
[picture p68: schematic power.kicad_sch, ${project_name} ${project_version}]

Parts:
C13, C14: 10uF; C_0603_1608Metric
IC3: TLV61225DC; SOT-363_SC-70-6
L1: 4.7uH; L_0603_1608Metric
R15: 10K; R_0402_1005Metric; MPN RC0603FR-071K1L; Mouser 603-RC0603FR-071K1L

Connections:
+VCC_HIGH: C14.1, IC3.2 (FB), IC3.4 (VOUT); also elsewhere on the board
+VCC_LOW: C13.1, IC3.1 (VIN), L1.2, R15.1; also elsewhere on the board
GND: C13.2, C14.2, IC3.3 (GND); also elsewhere on the board
unnamed: IC3.6 (EN), R15.2
unnamed: IC3.5 (L), L1.1

Notes on the sheet:
Up to 300-mA Output Current 1-MHz Fixed-Frequency PWM Operation
Use TPS61222DC for 2.5V>>5V
Power Page
StepUp 2V5>>3V3
Use TPS61225DC for 2.5V>>3.3V

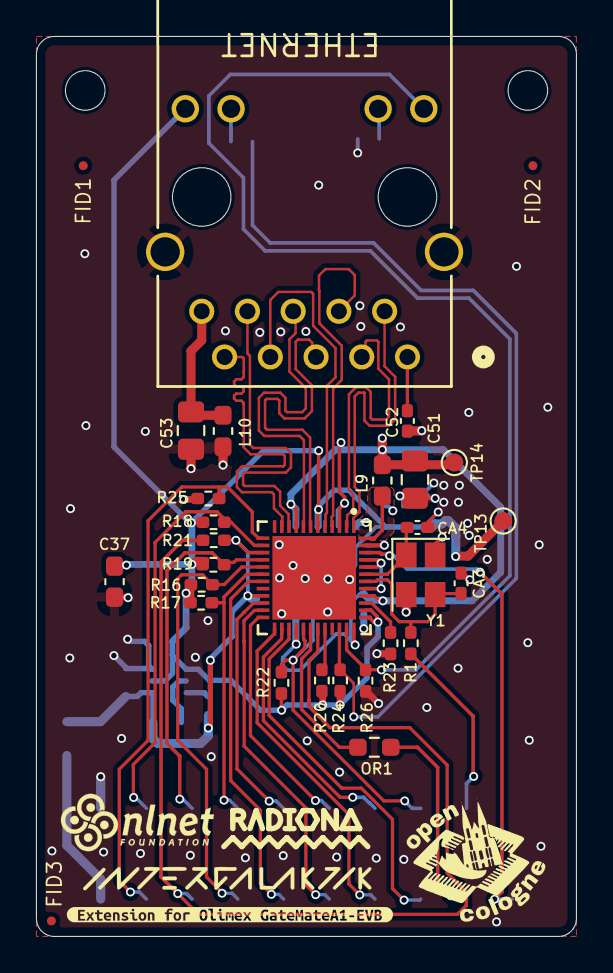
[picture p69: board ethIO.kicad_pcb from above]

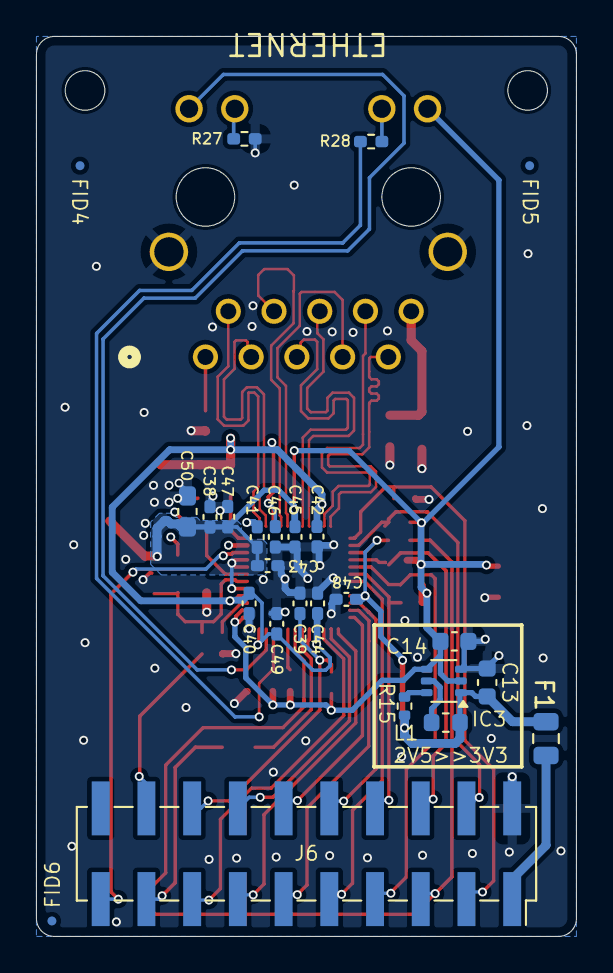
[picture p70: board ethIO.kicad_pcb from below]

Board: 4 copper layers, 30.0 x 50.0 mm, 61 parts (25 on the bottom side), 44 nets.

Other parts of the board:
OR1: 0R; R_0603_1608Metric_Pad0.98x0.95mm_HandSolder
kibuzzard-674D68C8: G***; kibuzzard-674D68C8

Their connections:
/Main Sheet/Ethernet/MAC_MDC: OR1.1; also elsewhere on the board
/Main Sheet/NB_A7_7P: OR1.2; also elsewhere on the board
