intergalaktik/Extension_Boards_for_Olimex_GateMate/dvi/dvi.kicad_pcb

## KiCad design dvi/dvi.kicad_pcb (2024-12-11)

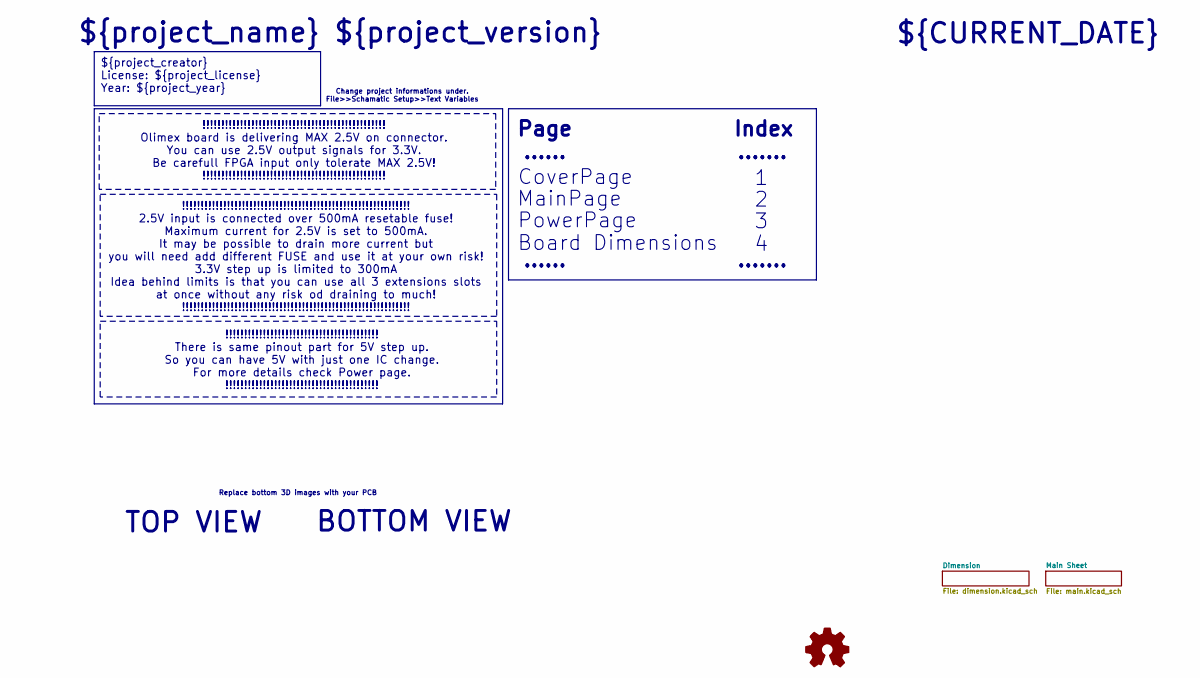
[picture p71: schematic dvi.kicad_sch, ${project_name} ${project_version}]

Notes on the sheet:
${project_creator} License: ${project_license} Year: ${project_year}
BOTTOM VIEW
Replace bottom 3D images with your PCB
Index
!!!!!!!!!!!!!!!!!!!!!!!!!!!!!!!!!!!!!!!!!!!!!!!!!!!!!!!!!!!!! 2.5V input is connected over 500mA resetable fuse! Maximum current for 2.5V is set to 500mA. It may be possible to drain more current but you will need add different FUSE and use it at your own risk! 3.3V step up is limited to 300mA Idea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
!!!!!!!!!!!!!!!!!!!!!!!!!!!!!!!!!!!!!!!!!!!!!!!!! Olimex board is delivering MAX 2.5V on connector. You can use 2.5V output signals for 3.3V. Be carefull FPGA input only tolerate MAX 2.5V! !!!!!!!!!!!!!!!!!!!!!!!!!!!!!!!!!!!!!!!!!!!!!!!!!
!!!!!!!!!!!!!!!!!!!!!!!!!!!!!!!!!!!!!!!!! There is same pinout part for 5V step up. So you can have 5V with just one IC change. For more details check Power page. !!!!!!!!!!!!!!!!!!!!!!!!!!!!!!!!!!!!!!!!!
......
PowerPage
Change project informations under. File>>Schamatic Setup>>Text Variables
.......
CoverPage
Board Dimensions
MainPage
${CURRENT_DATE}
${project_name} ${project_version}
TOP VIEW
Page


Notes on the sheet:
Dimension Page

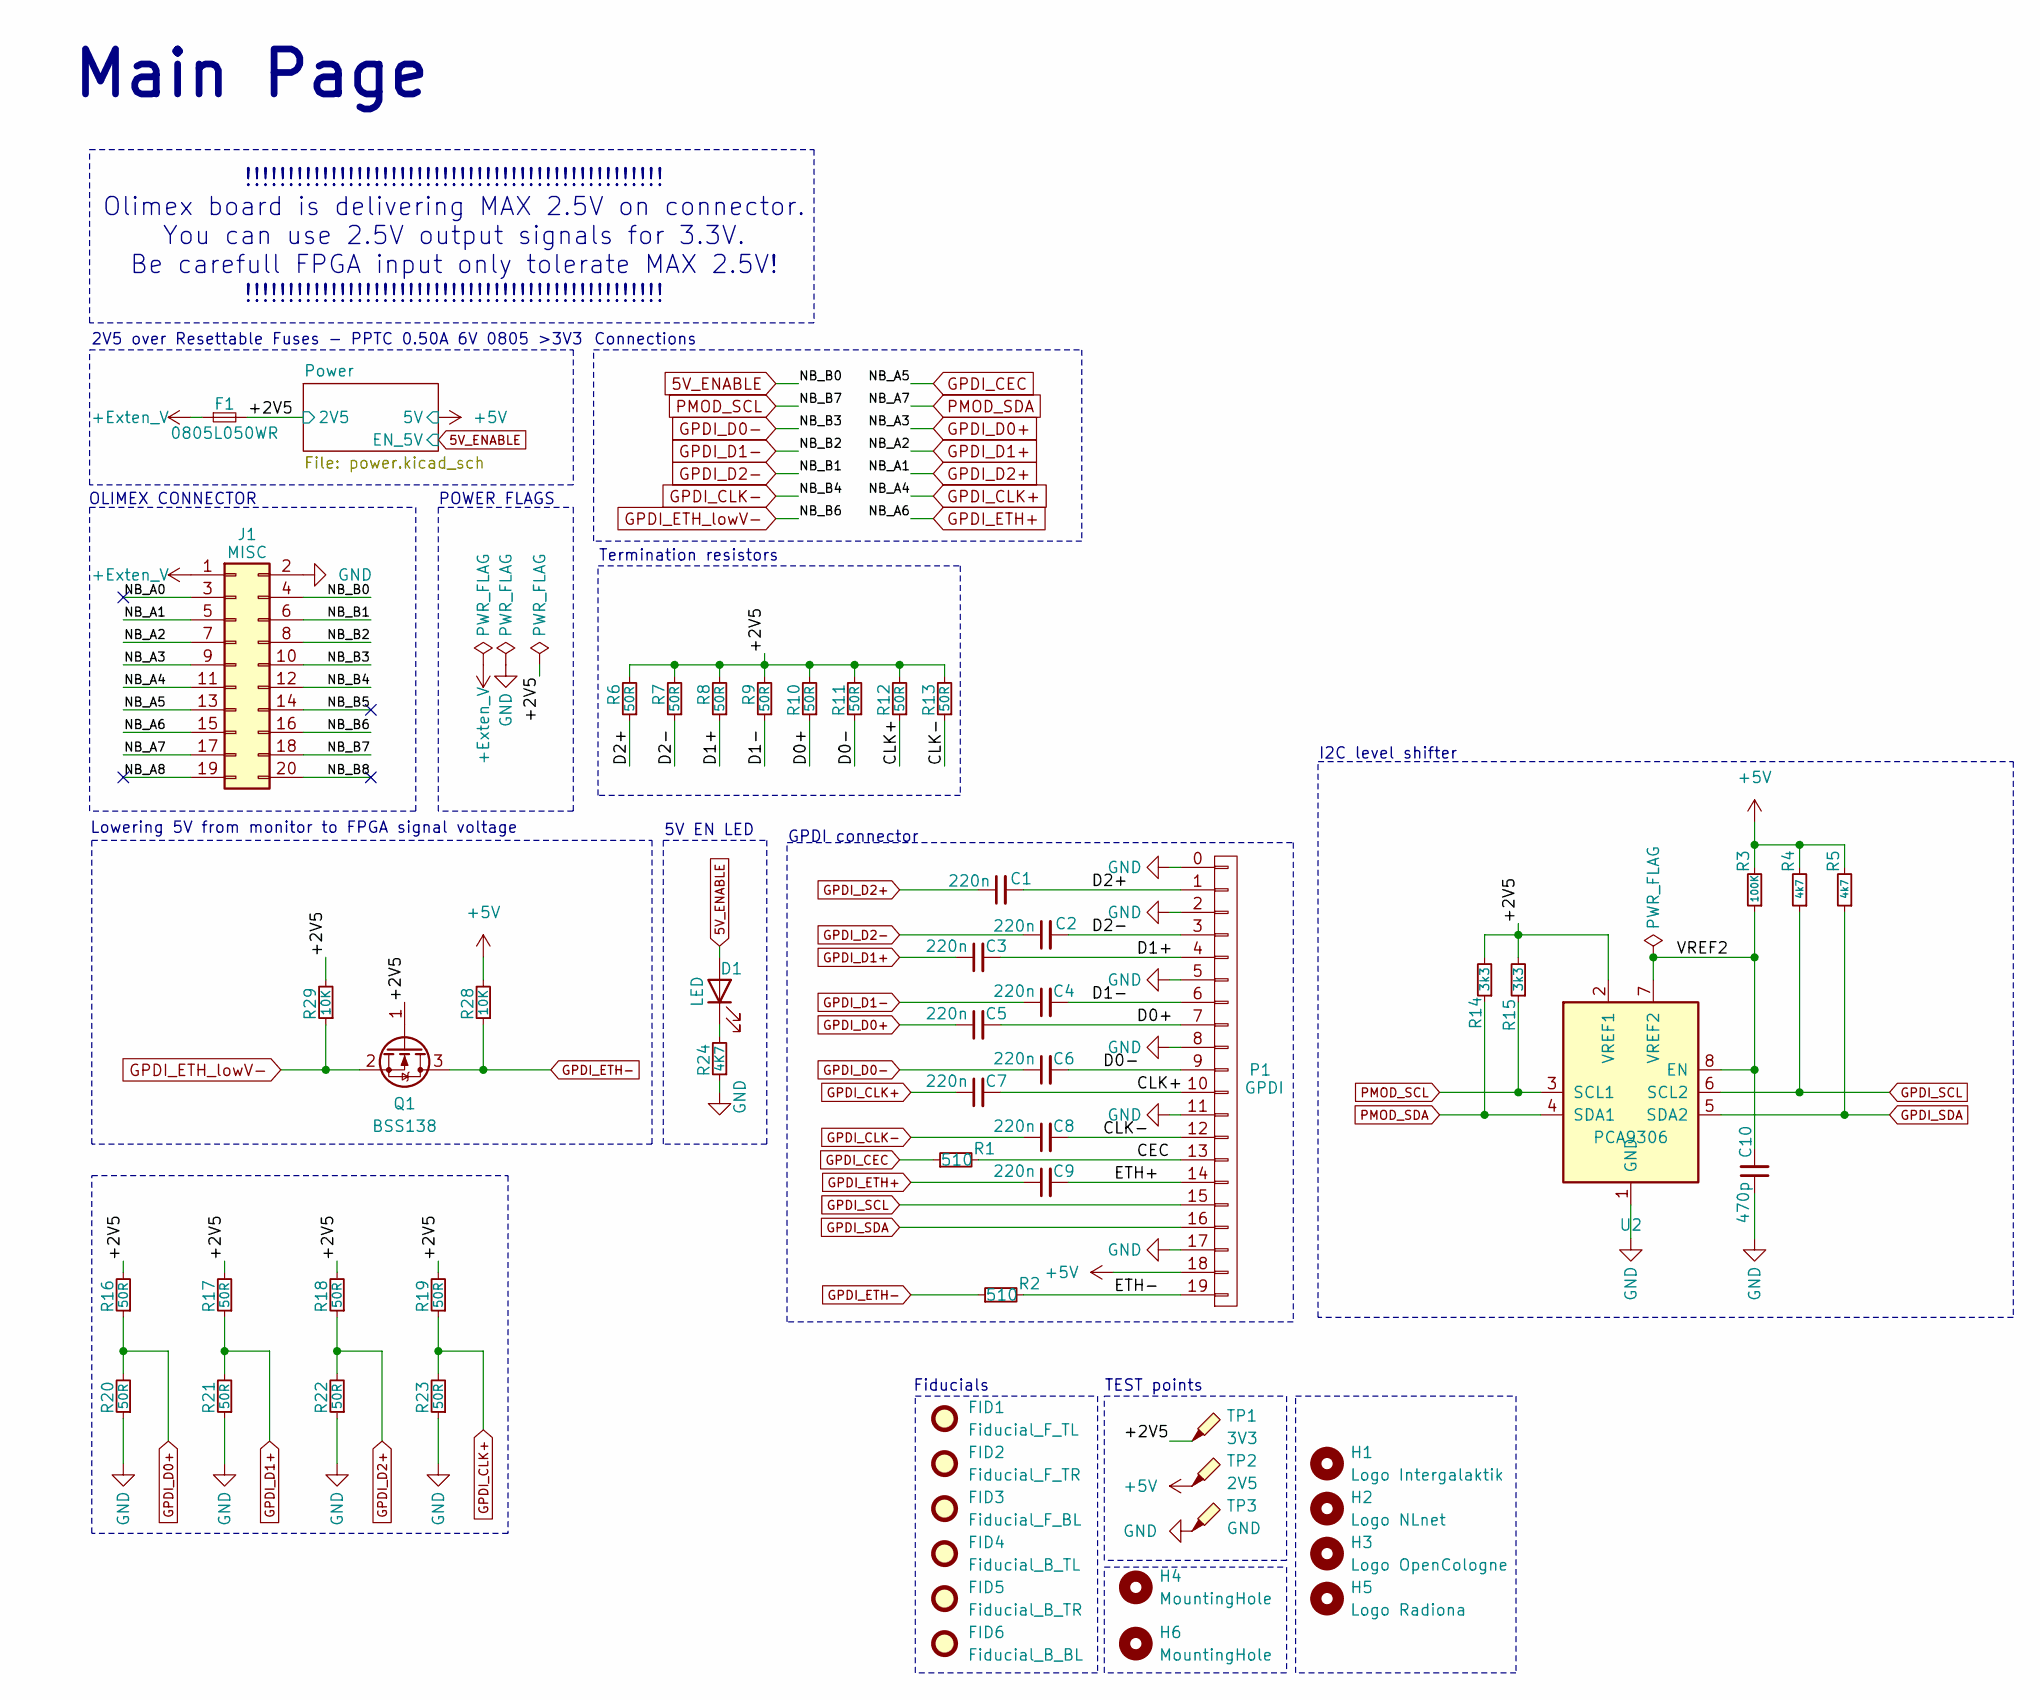
[picture p72: schematic main.kicad_sch, ${project_name} ${project_version}]

Parts:
C1, C2, C3, C4, C5, C6, C7, C8, C9: 220n; C_0402_1005Metric
C10: 470p; C_0402_1005Metric
D1: LED; LED_0603_1608Metric
F1: 0805L050WR; Fuse_0805_2012Metric
FID1: Fiducial_F_TL; Fiducial_0.5mm_Mask1mm
FID2: Fiducial_F_TR; Fiducial_0.5mm_Mask1mm
FID3: Fiducial_F_BL; Fiducial_0.5mm_Mask1mm
FID4: Fiducial_B_TL; Fiducial_0.5mm_Mask1mm
FID5: Fiducial_B_TR; Fiducial_0.5mm_Mask1mm
FID6: Fiducial_B_BL; Fiducial_0.5mm_Mask1mm
H1: Logo Intergalaktik; intergalaktik
H2: Logo NLnet; nlnet
H3: Logo OpenCologne; open_cologne_small
H4, H6: MountingHole; MountingHole_2.2mm_M2
H5: Logo Radiona; radiona_small
J1: MISC; PinSocket_2x10_P2.54mm_Vertical_SMD
P1: GPDI; CONN-10029449-111RLF
Q1: BSS138; SOT-23
R1, R2: 510; R_0402_1005Metric; MPN RC0603FR-071K1L; Mouser 603-RC0603FR-071K1L
R3: 100K; R_0402_1005Metric; MPN RC0603FR-071K1L; Mouser 603-RC0603FR-071K1L
R4, R5: 4k7; R_0402_1005Metric; MPN RC0603FR-071K1L; Mouser 603-RC0603FR-071K1L
R6, R7, R8, R9, R10, R11, R12, R13, R16, R17, R18, R19, R20, R21, R22, R23: 50R; R_0402_1005Metric; MPN RC0603FR-071K1L; Mouser 603-RC0603FR-071K1L
R14, R15: 3k3; R_0402_1005Metric; MPN RC0603FR-071K1L; Mouser 603-RC0603FR-071K1L
R24: 4K7; R_0402_1005Metric; MPN RC0603FR-071K1L; Mouser 603-RC0603FR-071K1L
R28, R29: 10K; R_0402_1005Metric; MPN RC0603FR-071K1L; Mouser 603-RC0603FR-071K1L
TP1: 3V3; TestPoint_Pad_D1.0mm
TP2: 2V5; TestPoint_Pad_D1.0mm
TP3: GND; TestPoint_Pad_D1.0mm
U2: PCA9306; SSOP-8_2.95x2.8mm_P0.65mm

Connections:
5V_ENABLE: D1.2 (A), J1.4; also elsewhere on the board
+5V: P1.18, R3.2, R4.2, R5.2, R28.2, TP2.1; also elsewhere on the board
+Exten_V: F1.1, J1.1
/Main Sheet/+2V5: F1.2, Q1.1 (G), R6.2, R7.2, R8.2, R9.2, R10.2, R11.2, R12.2, R13.2, R14.2, R15.2, R16.2, R17.2, R18.2, R19.2, R29.2, TP1.1; also elsewhere on the board
/Main Sheet/CEC: P1.13, R1.2
/Main Sheet/CLK+: C7.2, P1.10, R12.1
/Main Sheet/CLK-: C8.2, P1.12, R13.1
/Main Sheet/D0+: C5.2, P1.7, R10.1
/Main Sheet/D0-: C6.2, P1.9, R11.1
/Main Sheet/D1+: C3.2, P1.4, R8.1
/Main Sheet/D1-: C4.2, P1.6, R9.1
/Main Sheet/D2+: C1.2, P1.1, R6.1
/Main Sheet/D2-: C2.2, P1.3, R7.1
/Main Sheet/ETH+: C9.2, P1.14
/Main Sheet/ETH-: P1.19, R2.2
/Main Sheet/NB_A0: J1.3
/Main Sheet/NB_A8: J1.19
/Main Sheet/NB_B5: J1.14
/Main Sheet/NB_B8: J1.20
/Main Sheet/VREF2: C10.2, R3.1; also elsewhere on the board
GND: C10.1, J1.2, P1.0, P1.2, P1.5, P1.8, P1.11, P1.17, R20.1, R21.1, R22.1, R23.1, R24.1, TP3.1; also elsewhere on the board
GPDI_CEC: J1.13, R1.1
GPDI_CLK+: C7.1, J1.11, R19.1, R23.2
GPDI_CLK-: C8.1, J1.12
GPDI_D0+: C5.1, J1.9, R16.1, R20.2
GPDI_D0-: C6.1, J1.10
GPDI_D1+: C3.1, J1.7, R17.1, R21.2
GPDI_D1-: C4.1, J1.8
GPDI_D2+: C1.1, J1.5, R18.1, R22.2
GPDI_D2-: C2.1, J1.6
GPDI_ETH+: C9.1, J1.15
GPDI_ETH-: Q1.3 (D), R2.1, R28.1
GPDI_ETH_lowV-: J1.16, Q1.2 (S), R29.1
GPDI_SCL: P1.15, R4.1; also elsewhere on the board
GPDI_SDA: P1.16, R5.1; also elsewhere on the board
unnamed: D1.1 (K), R24.2
PMOD_SCL: J1.18, R15.1; also elsewhere on the board
PMOD_SDA: J1.17, R14.1; also elsewhere on the board

Notes on the sheet:
TEST points
POWER FLAGS
2V5 over Resettable Fuses - PPTC 0.50A 6V 0805 >3V3
!!!!!!!!!!!!!!!!!!!!!!!!!!!!!!!!!!!!!!!!!!!!!!!!! Olimex board is delivering MAX 2.5V on connector. You can use 2.5V output signals for 3.3V. Be carefull FPGA input only tolerate MAX 2.5V! !!!!!!!!!!!!!!!!!!!!!!!!!!!!!!!!!!!!!!!!!!!!!!!!!
Termination resistors
GPDI connector
Fiducials
I2C level shifter
Lowering 5V from monitor to FPGA signal voltage
OLIMEX CONNECTOR
Connections
5V EN LED
Main Page

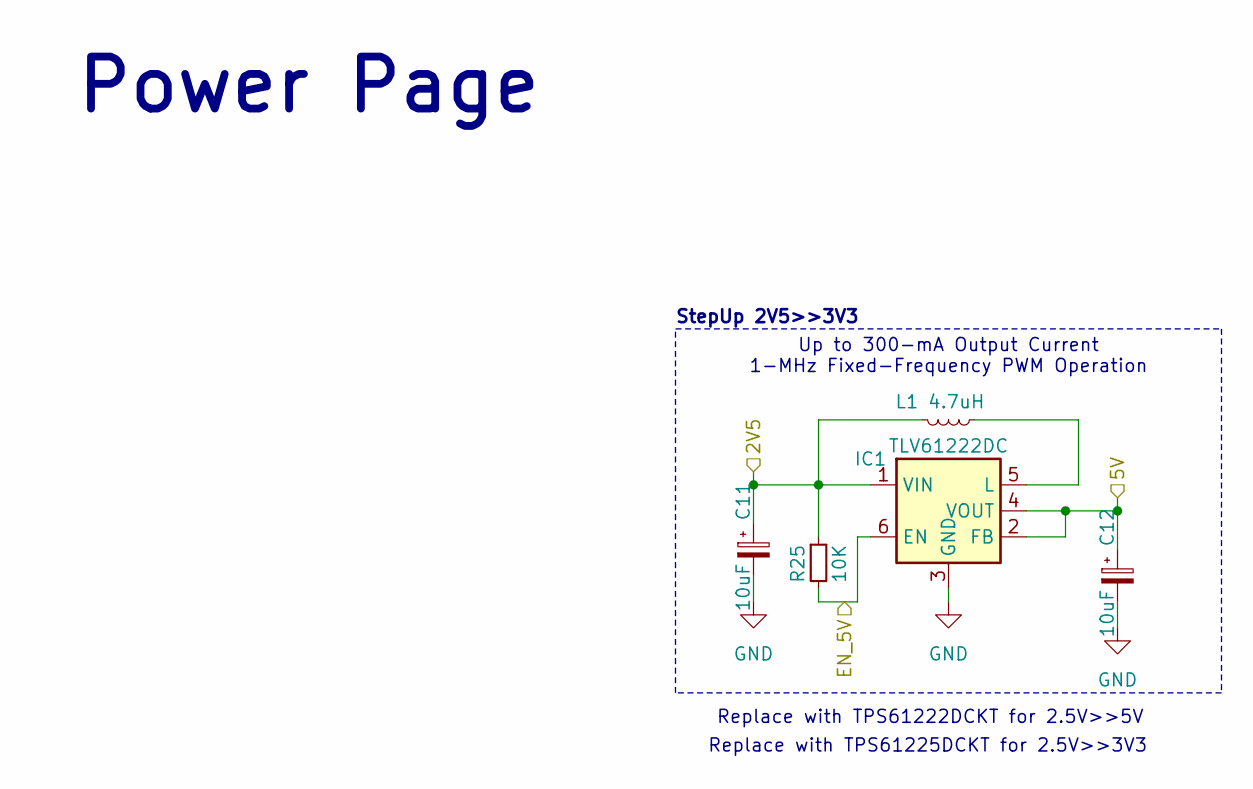
[picture p73: schematic power.kicad_sch, ${project_name} ${project_version}]

Parts:
C11, C12: 10uF; C_0603_1608Metric
IC1: TLV61222DC; SOT-363_SC-70-6
L1: 4.7uH; L_0603_1608Metric
R25: 10K; R_0402_1005Metric; MPN RC0603FR-071K1L; Mouser 603-RC0603FR-071K1L

Connections:
5V_ENABLE: IC1.6 (EN), R25.2; also elsewhere on the board
+5V: C12.1, IC1.2 (FB), IC1.4 (VOUT); also elsewhere on the board
/Main Sheet/+2V5: C11.1, IC1.1 (VIN), L1.2, R25.1; also elsewhere on the board
GND: C11.2, C12.2, IC1.3 (GND); also elsewhere on the board
unnamed: IC1.5 (L), L1.1

Notes on the sheet:
Up to 300-mA Output Current 1-MHz Fixed-Frequency PWM Operation
Power Page
StepUp 2V5>>3V3
Replace with TPS61225DCKT for 2.5V>>3V3
Replace with TPS61222DCKT for 2.5V>>5V

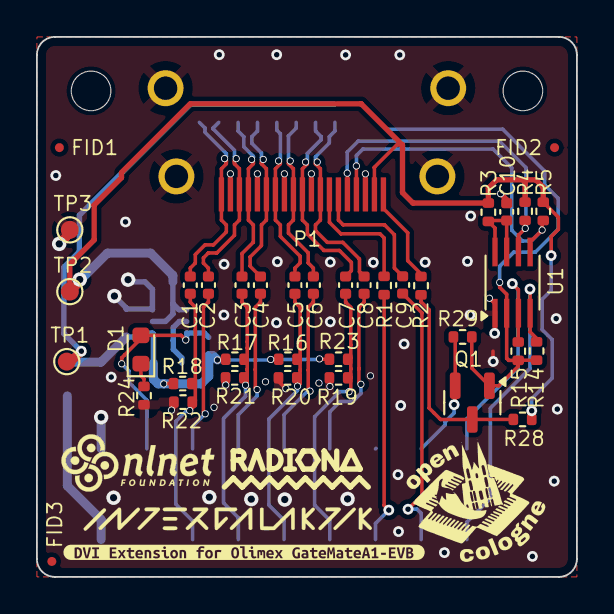
[picture p74: board dvi.kicad_pcb from above]

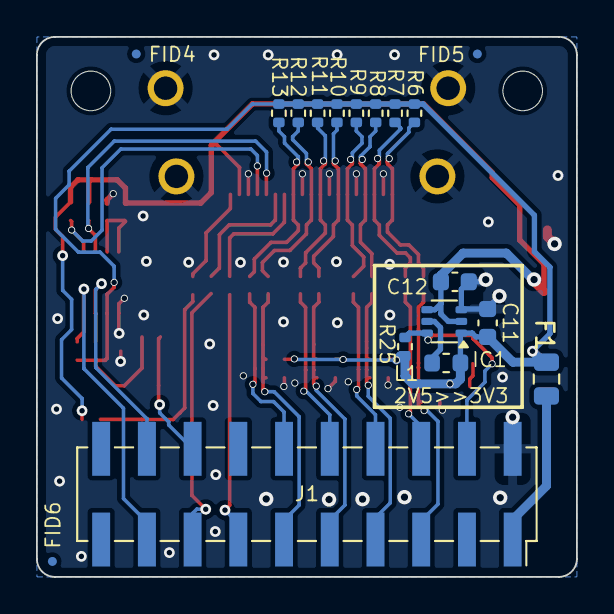
[picture p75: board dvi.kicad_pcb from below]

Board: 4 copper layers, 30.0 x 30.0 mm, 63 parts (18 on the bottom side), 35 nets.

Other parts of the board:
U1: PCA9306; SSOP-8_2.95x2.8mm_P0.65mm
kibuzzard-6750A0AE: G***; kibuzzard-6750A0AE

Their connections:
/Main Sheet/+2V5: U1.2 (VREF1); also elsewhere on the board
/Main Sheet/VREF2: U1.7 (VREF2), U1.8 (EN); also elsewhere on the board
GND: U1.1 (GND); also elsewhere on the board
GPDI_SCL: U1.6 (SCL2); also elsewhere on the board
GPDI_SDA: U1.5 (SDA2); also elsewhere on the board
PMOD_SCL: U1.3 (SCL1); also elsewhere on the board
PMOD_SDA: U1.4 (SDA1); also elsewhere on the board
