intergalaktik/Extension_Boards_for_Olimex_GateMate/eduIO/eduIO.kicad_pcb

## KiCad design eduIO/eduIO.kicad_pcb (2024-12-11)

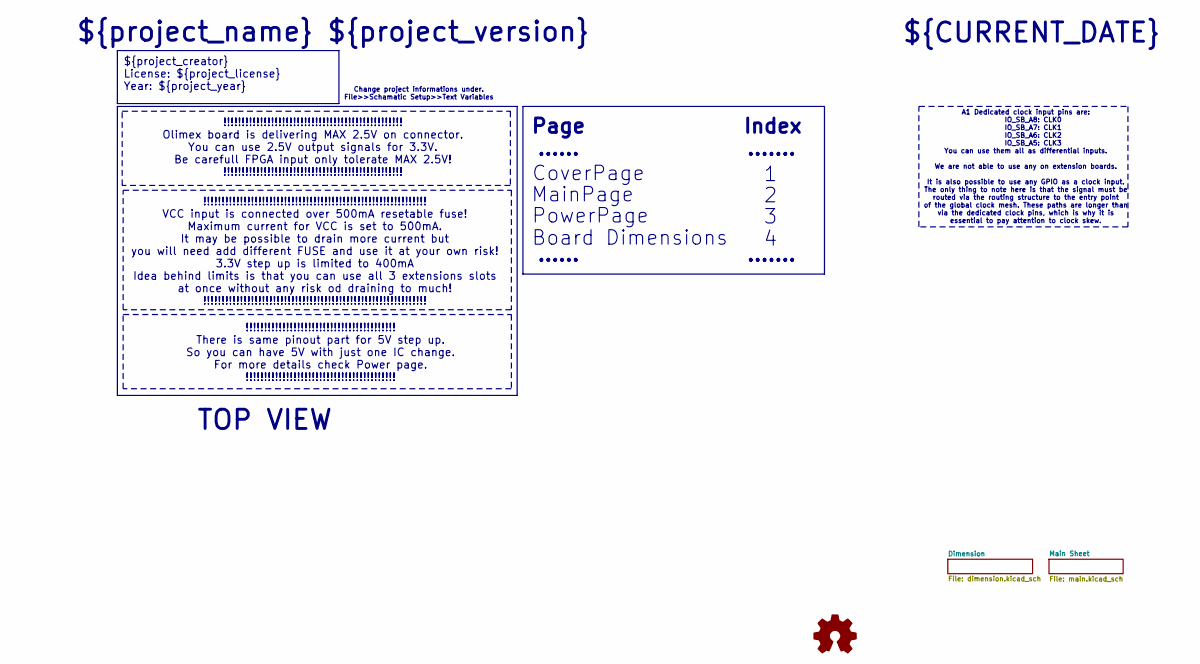
[picture p76: schematic eduIO.kicad_sch, ${project_name} ${project_version}]

Notes on the sheet:
${project_creator} License: ${project_license} Year: ${project_year}
Index
!!!!!!!!!!!!!!!!!!!!!!!!!!!!!!!!!!!!!!!!!!!!!!!!!!!!!!!!!!!!! VCC input is connected over 500mA resetable fuse! Maximum current for VCC is set to 500mA. It may be possible to drain more current but you will need add different FUSE and use it at your own risk! 3.3V step up is limited to 400mA Idea b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
!!!!!!!!!!!!!!!!!!!!!!!!!!!!!!!!!!!!!!!!!!!!!!!!! Olimex board is delivering MAX 2.5V on connector. You can use 2.5V output signals for 3.3V. Be carefull FPGA input only tolerate MAX 2.5V! !!!!!!!!!!!!!!!!!!!!!!!!!!!!!!!!!!!!!!!!!!!!!!!!!
!!!!!!!!!!!!!!!!!!!!!!!!!!!!!!!!!!!!!!!!! There is same pinout part for 5V step up. So you can have 5V with just one IC change. For more details check Power page. !!!!!!!!!!!!!!!!!!!!!!!!!!!!!!!!!!!!!!!!!
......
PowerPage
Change project informations under. File>>Schamatic Setup>>Text Variables
.......
A1 Dedicated clock input pins are: IO_SB_A8: CLK0 IO_SB_A7: CLK1 IO_SB_A6: CLK2 IO_SB_A5: CLK3 You can use them all as differential inputs. We are not able to use any on extension boards. It is also possible to use any GPIO as a clock input. The only thing to note here is that the signal must be ro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
CoverPage
Board Dimensions
MainPage
${CURRENT_DATE}
${project_name} ${project_version}
TOP VIEW
Page


Notes on the sheet:
Dimension Page

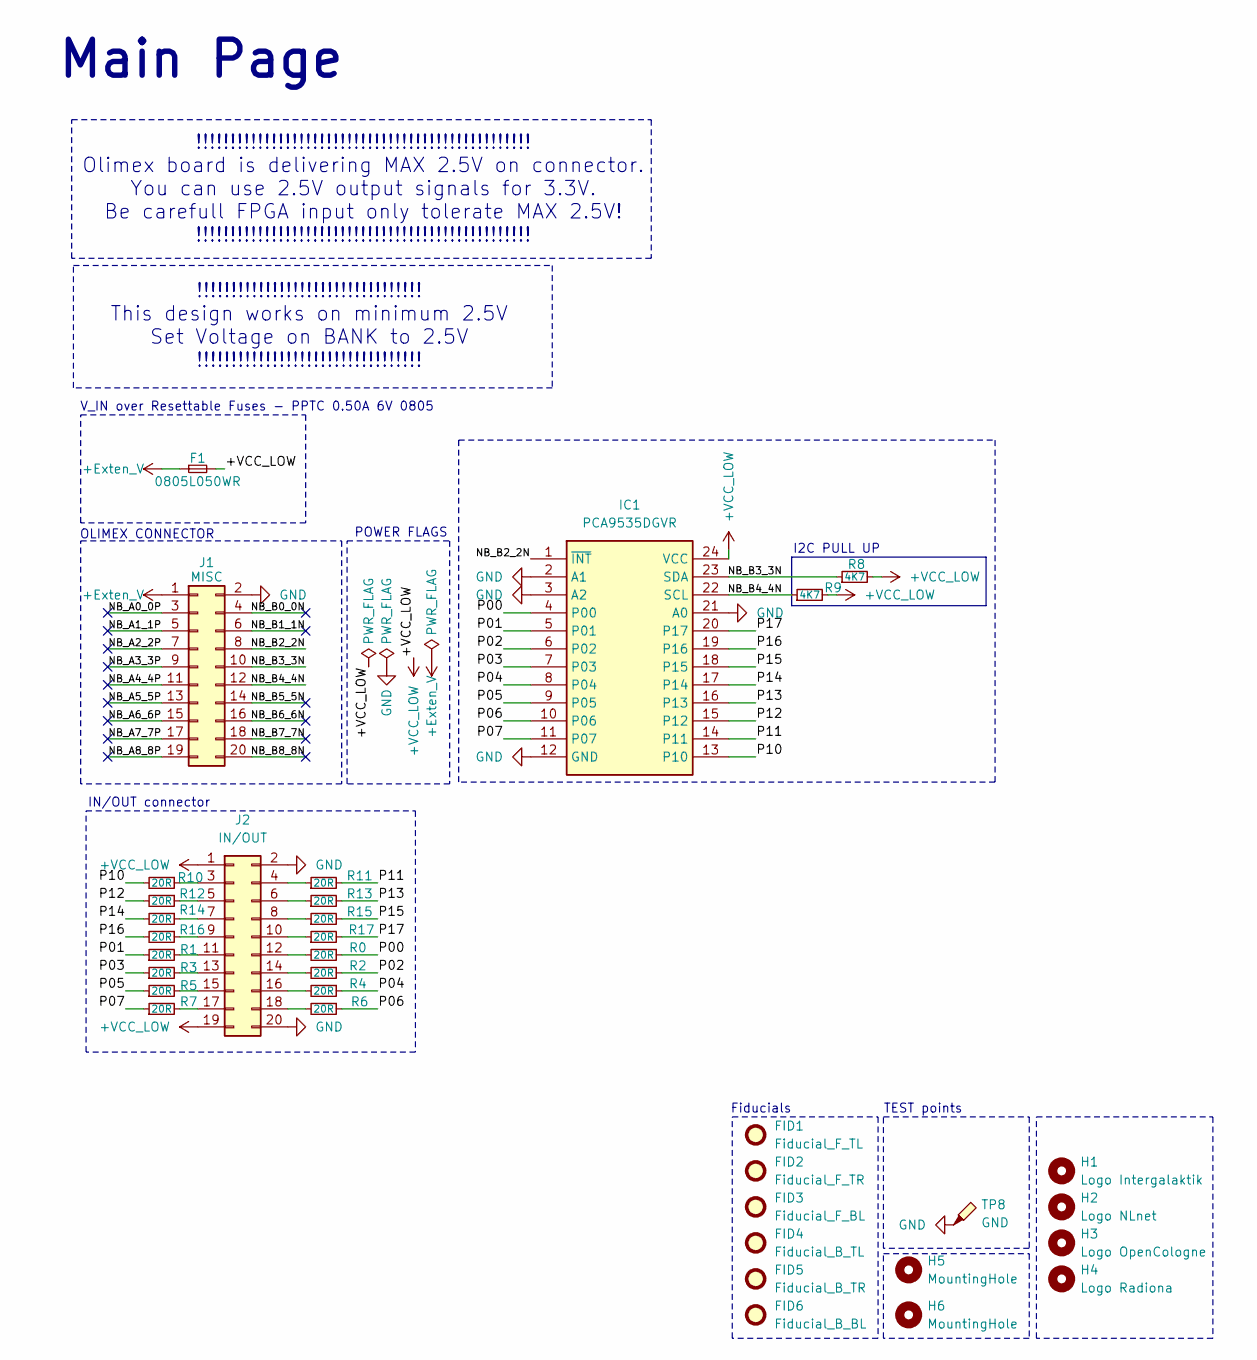
[picture p77: schematic main.kicad_sch, ${project_name} ${project_version}]

Parts:
F1: 0805L050WR; Fuse_0805_2012Metric
FID1: Fiducial_F_TL; Fiducial_0.5mm_Mask1mm
FID2: Fiducial_F_TR; Fiducial_0.5mm_Mask1mm
FID3: Fiducial_F_BL; Fiducial_0.5mm_Mask1mm
FID4: Fiducial_B_TL; Fiducial_0.5mm_Mask1mm
FID5: Fiducial_B_TR; Fiducial_0.5mm_Mask1mm
FID6: Fiducial_B_BL; Fiducial_0.5mm_Mask1mm
H1: Logo Intergalaktik; intergalaktik
H2: Logo NLnet; nlnet
H3: Logo OpenCologne; open_cologne_small
H4: Logo Radiona; radiona_small
H5, H6: MountingHole; MountingHole_2.2mm_M2
IC1: PCA9535DGVR; SOP40P640X120-24N; Mouser Part Number 595-PCA9535DGVR
J1: MISC; PinSocket_2x10_P2.54mm_Vertical_SMD
J2: IN/OUT; PinHeader_2x10_P2.54mm_Vertical
R0, R1, R2, R3, R4, R5, R6, R7, R10, R11, R12, R13, R14, R15, R16, R17: 20R; R_0402_1005Metric
R8, R9: 4K7; R_0402_1005Metric
TP8: GND; TestPoint_THTPad_1.0x1.0mm_Drill0.5mm

Connections:
+Exten_V: F1.1, J1.1
+VCC_LOW: F1.2, IC1.24 (VCC), J2.1, J2.19, R8.2, R9.2
/Main Sheet/NB_A0_0P: J1.3
/Main Sheet/NB_A1_1P: J1.5
/Main Sheet/NB_A2_2P: J1.7
/Main Sheet/NB_A3_3P: J1.9
/Main Sheet/NB_A4_4P: J1.11
/Main Sheet/NB_A5_5P: J1.13
/Main Sheet/NB_A6_6P: J1.15
/Main Sheet/NB_A7_7P: J1.17
/Main Sheet/NB_A8_8P: J1.19
/Main Sheet/NB_B0_0N: J1.4
/Main Sheet/NB_B1_1N: J1.6
/Main Sheet/NB_B2_2N: IC1.1 (~INT), J1.8
/Main Sheet/NB_B3_3N: IC1.23 (SDA), J1.10, R8.1
/Main Sheet/NB_B4_4N: IC1.22 (SCL), J1.12, R9.1
/Main Sheet/NB_B5_5N: J1.14
/Main Sheet/NB_B6_6N: J1.16
/Main Sheet/NB_B7_7N: J1.18
/Main Sheet/NB_B8_8N: J1.20
/Main Sheet/P00: IC1.4 (P00), R0.1
/Main Sheet/P01: IC1.5 (P01), R1.1
/Main Sheet/P02: IC1.6 (P02), R2.1
/Main Sheet/P03: IC1.7 (P03), R3.1
/Main Sheet/P04: IC1.8 (P04), R4.1
/Main Sheet/P05: IC1.9 (P05), R5.1
/Main Sheet/P06: IC1.10 (P06), R6.1
/Main Sheet/P07: IC1.11 (P07), R7.1
/Main Sheet/P10: IC1.13 (P10), R10.2
/Main Sheet/P11: IC1.14 (P11), R11.2
/Main Sheet/P12: IC1.15 (P12), R12.2
/Main Sheet/P13: IC1.16 (P13), R13.2
/Main Sheet/P14: IC1.17 (P14), R14.2
/Main Sheet/P15: IC1.18 (P15), R15.2
/Main Sheet/P16: IC1.19 (P16), R16.2
/Main Sheet/P17: IC1.20 (P17), R17.2
GND: IC1.2 (A1), IC1.3 (A2), IC1.12 (GND), IC1.21 (A0), J1.2, J2.2, J2.20, TP8.1
unnamed: J2.3, R10.1
unnamed: J2.4, R11.1
unnamed: J2.5, R12.1
unnamed: J2.6, R13.1
unnamed: J2.7, R14.1
unnamed: J2.8, R15.1
unnamed: J2.9, R16.1
unnamed: J2.10, R17.1
unnamed: J2.11, R1.2
unnamed: J2.12, R0.2
unnamed: J2.13, R3.2
unnamed: J2.14, R2.2
unnamed: J2.15, R5.2
unnamed: J2.16, R4.2
unnamed: J2.17, R7.2
unnamed: J2.18, R6.2

Notes on the sheet:
I2C PULL UP
TEST points
POWER FLAGS
V_IN over Resettable Fuses - PPTC 0.50A 6V 0805
!!!!!!!!!!!!!!!!!!!!!!!!!!!!!!!!!!!!!!!!!!!!!!!!! Olimex board is delivering MAX 2.5V on connector. You can use 2.5V output signals for 3.3V. Be carefull FPGA input only tolerate MAX 2.5V! !!!!!!!!!!!!!!!!!!!!!!!!!!!!!!!!!!!!!!!!!!!!!!!!!
Fiducials
IN/OUT connector
OLIMEX CONNECTOR
Main Page
!!!!!!!!!!!!!!!!!!!!!!!!!!!!!!!!! This design works on minimum 2.5V Set Voltage on BANK to 2.5V !!!!!!!!!!!!!!!!!!!!!!!!!!!!!!!!!

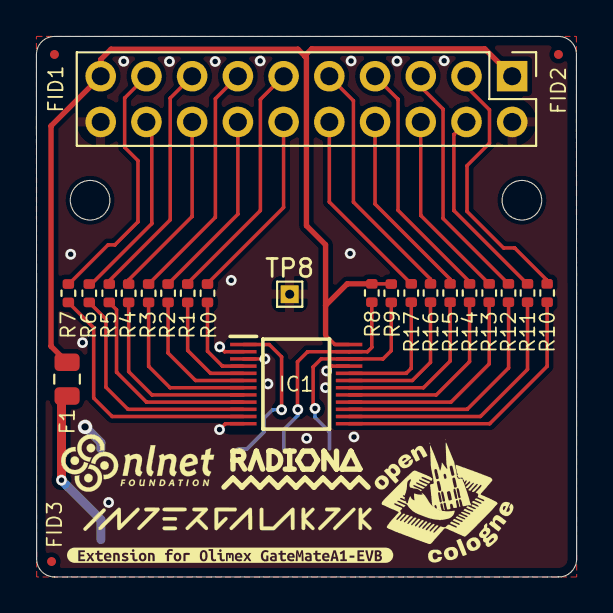
[picture p78: board eduIO.kicad_pcb from above]

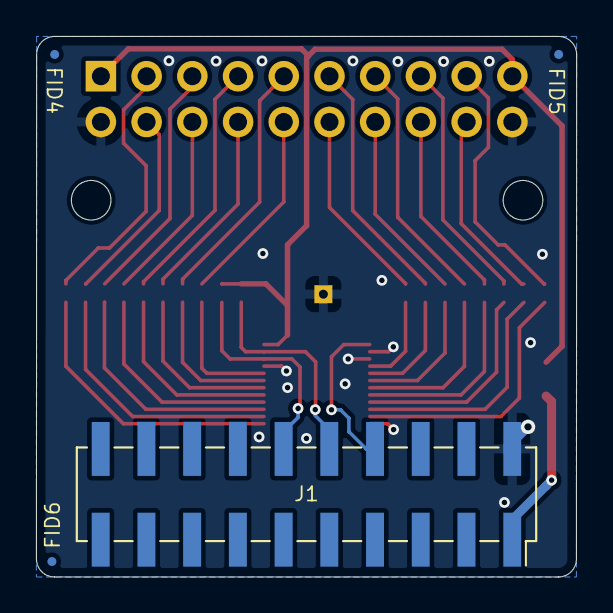
[picture p79: board eduIO.kicad_pcb from below]

Board: 2 copper layers, 30.0 x 30.0 mm, 36 parts (4 on the bottom side), 38 nets.

Other parts of the board:
kibuzzard-674D68C8: G***; kibuzzard-674D68C8
