intergalaktik/Extension_Boards_for_Olimex_GateMate/pwrIO/pwrIO.kicad_pcb

## KiCad design pwrIO/pwrIO.kicad_pcb (2024-12-11)

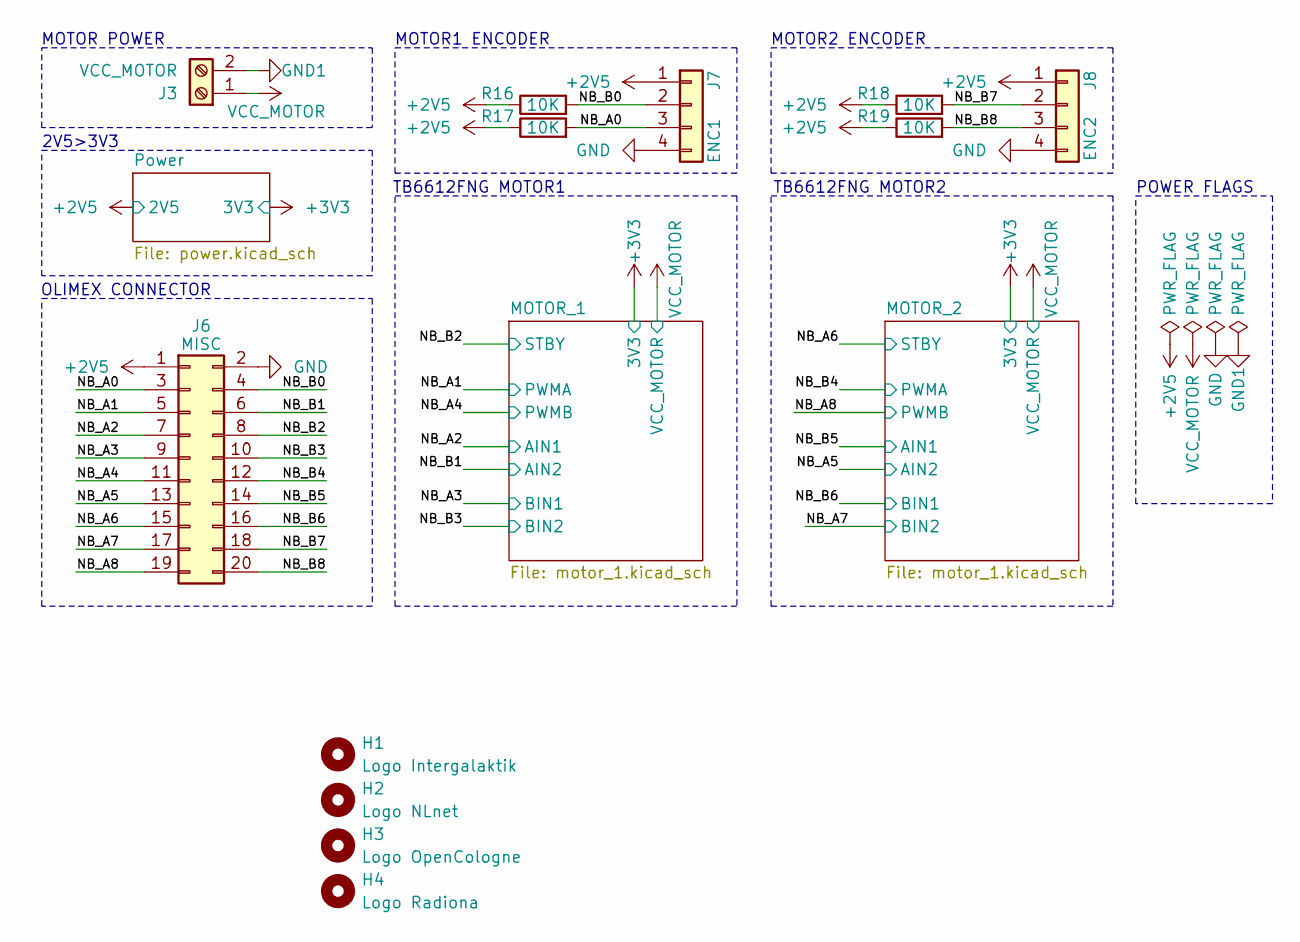
[picture p80: schematic pwrIO.kicad_sch, Motor driver board]

Parts:
H1: Logo Intergalaktik; intergalaktik
H2: Logo NLnet; nlnet
H3: Logo OpenCologne; open_cologne
H4: Logo Radiona; radiona
J3: VCC_MOTOR; TerminalBlock_Phoenix_MPT-0,5-2-2.54_1x02_P2.54mm_Horizontal
J6: MISC; PinSocket_2x10_P2.54mm_Vertical_SMD
J7: ENC1; PinSocket_1x04_P2.54mm_Vertical
J8: ENC2; PinSocket_1x04_P2.54mm_Vertical
R16, R17, R18, R19: 10K; R_0402_1005Metric

Connections:
+2V5: J6.1, J7.1, J8.1, R16.1, R17.1, R18.1, R19.1; also elsewhere on the board
/NB_A0: J6.3, J7.3, R17.2
/NB_A1: J6.5; also elsewhere on the board
/NB_A2: J6.7; also elsewhere on the board
/NB_A3: J6.9; also elsewhere on the board
/NB_A4: J6.11; also elsewhere on the board
/NB_A5: J6.13; also elsewhere on the board
/NB_A6: J6.15; also elsewhere on the board
/NB_A7: J6.17; also elsewhere on the board
/NB_A8: J6.19; also elsewhere on the board
/NB_B0: J6.4, J7.2, R16.2
/NB_B1: J6.6; also elsewhere on the board
/NB_B2: J6.8; also elsewhere on the board
/NB_B3: J6.10; also elsewhere on the board
/NB_B4: J6.12; also elsewhere on the board
/NB_B5: J6.14; also elsewhere on the board
/NB_B6: J6.16; also elsewhere on the board
/NB_B7: J6.18, J8.2, R18.2
/NB_B8: J6.20, J8.3, R19.2
GND: J6.2, J7.4, J8.4; also elsewhere on the board
GND1: J3.2; also elsewhere on the board
VCC_MOTOR: J3.1; also elsewhere on the board

Notes on the sheet:
OLIMEX CONNECTOR
TB6612FNG MOTOR1
MOTOR1 ENCODER
TB6612FNG MOTOR2
MOTOR2 ENCODER
2V5>3V3
POWER FLAGS
MOTOR POWER

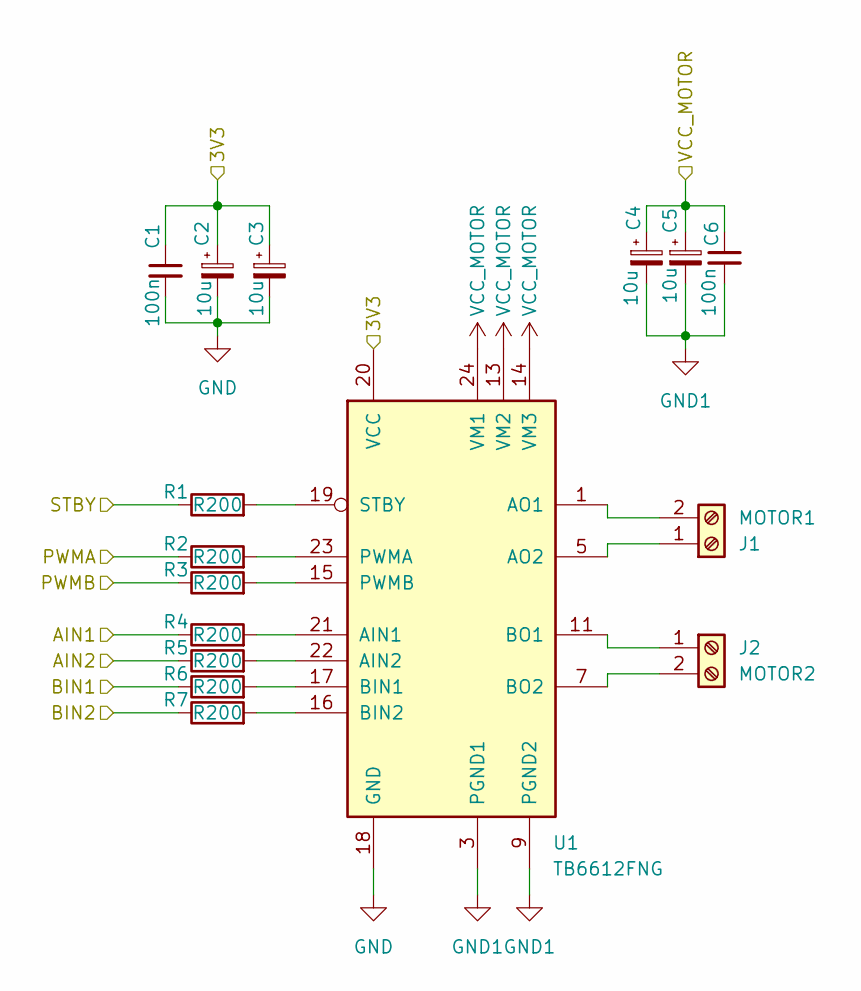
[picture p81: schematic motor_1.kicad_sch, Motor driver board]

Parts:
C1, C6: 100n; C_0402_1005Metric
C2, C3, C4, C5: 10u; CP_EIA-3216-18_Kemet-A
J1: MOTOR1; TerminalBlock_Phoenix_MPT-0,5-2-2.54_1x02_P2.54mm_Horizontal
J2: MOTOR2; TerminalBlock_Phoenix_MPT-0,5-2-2.54_1x02_P2.54mm_Horizontal
R1, R2, R3, R4, R5, R6, R7: R200; R_0402_1005Metric
U1: TB6612FNG; SSOP-24_5.3x8.2mm_P0.65mm

Connections:
+3V3: C1.1, C2.1, C3.1, U1.20 (VCC); also elsewhere on the board
/NB_A1: R2.1; also elsewhere on the board
/NB_A2: R4.1; also elsewhere on the board
/NB_A3: R6.1; also elsewhere on the board
/NB_A4: R3.1; also elsewhere on the board
/NB_B1: R5.1; also elsewhere on the board
/NB_B2: R1.1; also elsewhere on the board
/NB_B3: R7.1; also elsewhere on the board
GND: C1.2, C2.2, C3.2, U1.18 (GND); also elsewhere on the board
GND1: C4.2, C5.2, C6.2, U1.3 (PGND1), U1.4 (PGND1), U1.9 (PGND2), U1.10 (PGND2); also elsewhere on the board
unnamed: J1.1, U1.5 (AO2), U1.6 (AO2)
unnamed: J1.2, U1.1 (AO1), U1.2 (AO1)
unnamed: J2.1, U1.11 (BO1), U1.12 (BO1)
unnamed: J2.2, U1.7 (BO2), U1.8 (BO2)
unnamed: R4.2, U1.21 (AIN1)
unnamed: R5.2, U1.22 (AIN2)
unnamed: R6.2, U1.17 (BIN1)
unnamed: R7.2, U1.16 (BIN2)
unnamed: R2.2, U1.23 (PWMA)
unnamed: R3.2, U1.15 (PWMB)
unnamed: R1.2, U1.19 (STBY)
VCC_MOTOR: C4.1, C5.1, C6.1, U1.13 (VM2), U1.14 (VM3), U1.24 (VM1); also elsewhere on the board

Parts of its further copies:
C7, C12: 100n; C_0402_1005Metric
C8, C9, C10, C11: 10u; CP_EIA-3216-18_Kemet-A
J4: MOTOR1; TerminalBlock_Phoenix_MPT-0,5-2-2.54_1x02_P2.54mm_Horizontal
J5: MOTOR2; TerminalBlock_Phoenix_MPT-0,5-2-2.54_1x02_P2.54mm_Horizontal
R8, R9, R10, R11, R12, R13, R14: R200; R_0402_1005Metric
U2: TB6612FNG; SSOP-24_5.3x8.2mm_P0.65mm

Connections of its further copies:
+3V3: C7.1, C8.1, C9.1, U2.20 (VCC); also elsewhere on the board
/NB_A5: R12.1; also elsewhere on the board
/NB_A6: R8.1; also elsewhere on the board
/NB_A7: R14.1; also elsewhere on the board
/NB_A8: R10.1; also elsewhere on the board
/NB_B4: R9.1; also elsewhere on the board
/NB_B5: R11.1; also elsewhere on the board
/NB_B6: R13.1; also elsewhere on the board
GND: C7.2, C8.2, C9.2, U2.18 (GND); also elsewhere on the board
GND1: C10.2, C11.2, C12.2, U2.3 (PGND1), U2.4 (PGND1), U2.9 (PGND2), U2.10 (PGND2); also elsewhere on the board
unnamed: J4.1, U2.5 (AO2), U2.6 (AO2)
unnamed: J4.2, U2.1 (AO1), U2.2 (AO1)
unnamed: J5.1, U2.11 (BO1), U2.12 (BO1)
unnamed: J5.2, U2.7 (BO2), U2.8 (BO2)
unnamed: R11.2, U2.21 (AIN1)
unnamed: R12.2, U2.22 (AIN2)
unnamed: R13.2, U2.17 (BIN1)
unnamed: R14.2, U2.16 (BIN2)
unnamed: R9.2, U2.23 (PWMA)
unnamed: R10.2, U2.15 (PWMB)
unnamed: R8.2, U2.19 (STBY)
VCC_MOTOR: C10.1, C11.1, C12.1, U2.13 (VM2), U2.14 (VM3), U2.24 (VM1); also elsewhere on the board

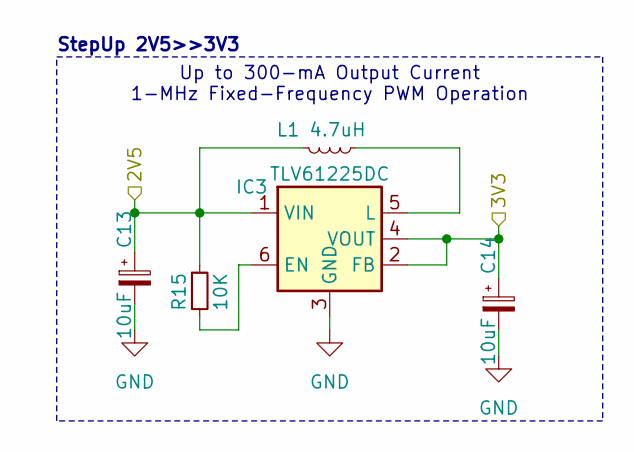
[picture p82: schematic power.kicad_sch, Motor driver board]

Parts:
C13, C14: 10uF; C_0603_1608Metric
IC3: TLV61225DC; SOT-363_SC-70-6
L1: 4.7uH; L_0603_1608Metric
R15: 10K; R_0402_1005Metric; MPN RC0603FR-071K1L; Mouser 603-RC0603FR-071K1L

Connections:
+2V5: C13.1, IC3.1 (VIN), L1.2, R15.1; also elsewhere on the board
+3V3: C14.1, IC3.2 (FB), IC3.4 (VOUT); also elsewhere on the board
GND: C13.2, C14.2, IC3.3 (GND); also elsewhere on the board

Notes on the sheet:
Up to 300-mA Output Current 1-MHz Fixed-Frequency PWM Operation
StepUp 2V5>>3V3
