intergalaktik/Extension_Boards_for_Olimex_GateMate/pwrIO/pwrIO.kicad_pcb

## KiCad design pwrIO/pwrIO.kicad_pcb (continued)

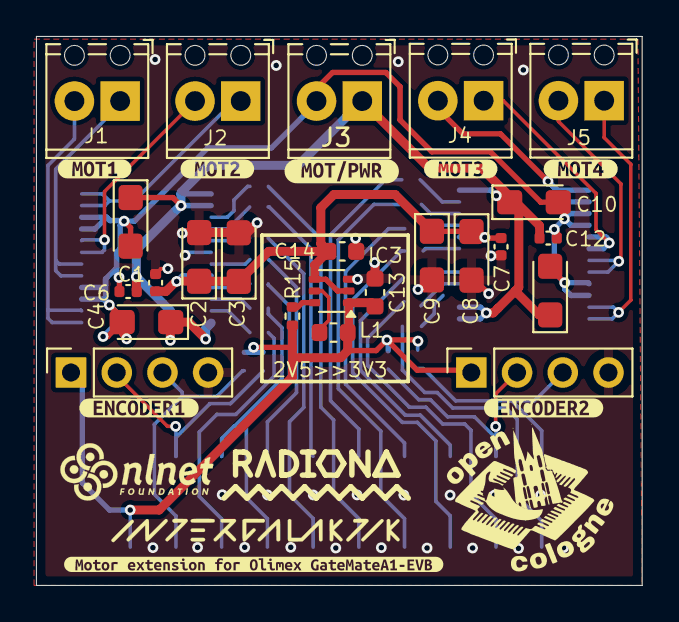
[picture p83: board pwrIO.kicad_pcb from above]

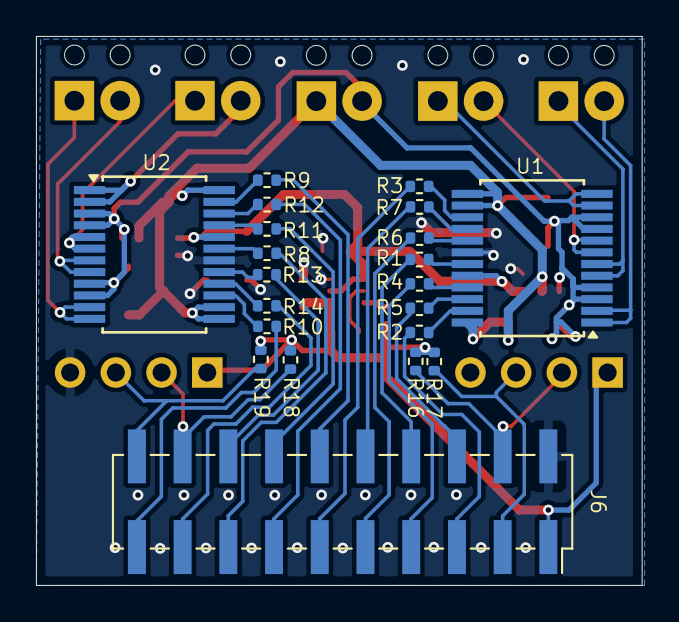
[picture p84: board pwrIO.kicad_pcb from below]

Board: 4 copper layers, 33.7 x 30.5 mm, 57 parts (21 on the bottom side), 45 nets.

Other parts of the board:
kibuzzard-674632A1: G***; kibuzzard-674632A1
kibuzzard-674632D6: G***; kibuzzard-674632D6
kibuzzard-674632E9: G***; kibuzzard-674632E9
kibuzzard-674632F5: G***; kibuzzard-674632F5
kibuzzard-6746333A: G***; kibuzzard-6746333A
kibuzzard-6746334D: G***; kibuzzard-6746334D
kibuzzard-67463311: G***; kibuzzard-67463311
kibuzzard-67464255: G***; kibuzzard-67464255
