intergalaktik/Extension_Boards_for_Olimex_GateMate/adcIO/adcIO.kicad_pcb

## KiCad design adcIO/adcIO.kicad_pcb (2024-12-11)

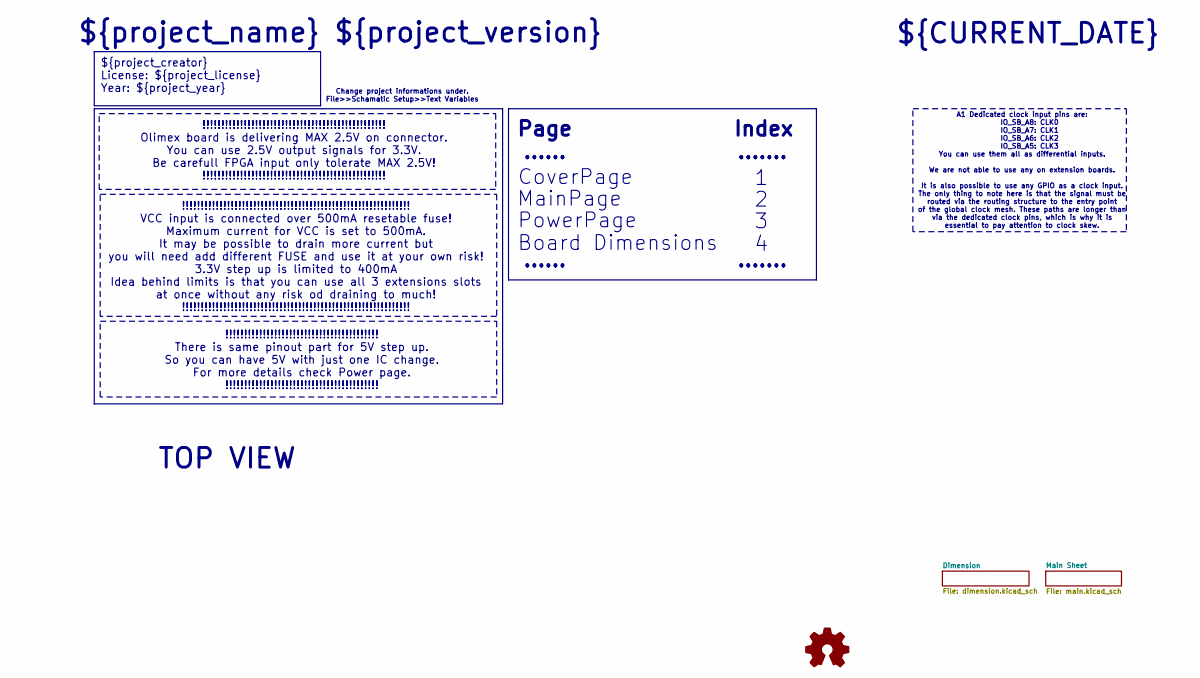
[picture p85: schematic adcIO.kicad_sch, ${project_name} ${project_version}]

Notes on the sheet:
${project_creator} License: ${project_license} Year: ${project_year}
Index
!!!!!!!!!!!!!!!!!!!!!!!!!!!!!!!!!!!!!!!!!!!!!!!!!!!!!!!!!!!!! VCC input is connected over 500mA resetable fuse! Maximum current for VCC is set to 500mA. It may be possible to drain more current but you will need add different FUSE and use it at your own risk! 3.3V step up is limited to 400mA Idea b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
!!!!!!!!!!!!!!!!!!!!!!!!!!!!!!!!!!!!!!!!!!!!!!!!! Olimex board is delivering MAX 2.5V on connector. You can use 2.5V output signals for 3.3V. Be carefull FPGA input only tolerate MAX 2.5V! !!!!!!!!!!!!!!!!!!!!!!!!!!!!!!!!!!!!!!!!!!!!!!!!!
!!!!!!!!!!!!!!!!!!!!!!!!!!!!!!!!!!!!!!!!! There is same pinout part for 5V step up. So you can have 5V with just one IC change. For more details check Power page. !!!!!!!!!!!!!!!!!!!!!!!!!!!!!!!!!!!!!!!!!
......
PowerPage
Change project informations under. File>>Schamatic Setup>>Text Variables
.......
A1 Dedicated clock input pins are: IO_SB_A8: CLK0 IO_SB_A7: CLK1 IO_SB_A6: CLK2 IO_SB_A5: CLK3 You can use them all as differential inputs. We are not able to use any on extension boards. It is also possible to use any GPIO as a clock input. The only thing to note here is that the signal must be ro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
CoverPage
Board Dimensions
MainPage
${CURRENT_DATE}
${project_name} ${project_version}
TOP VIEW
Page


Notes on the sheet:
Dimension Page

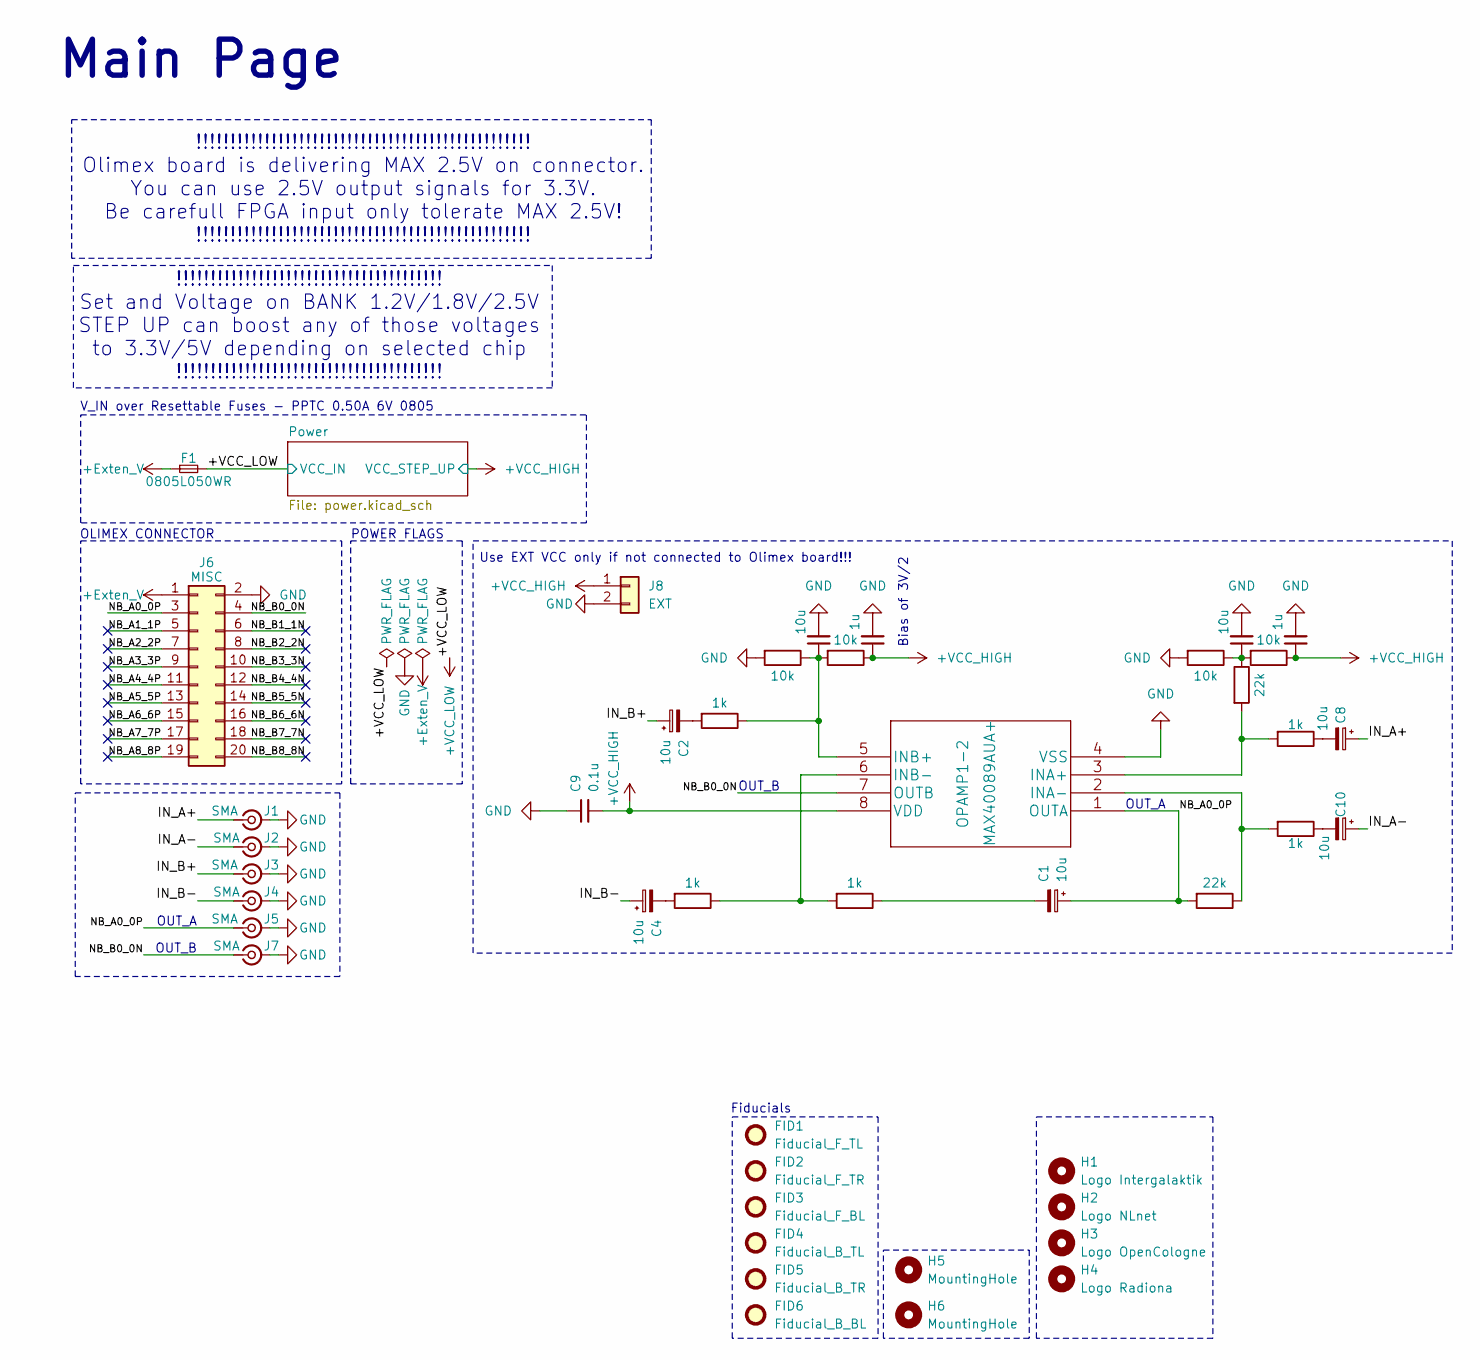
[picture p86: schematic main.kicad_sch, ${project_name} ${project_version}]

Parts:
C1, C2, C4, C8, C10: 10u; CP_EIA-1608-10_AVX-L
C3, C6: 10u; C_0603_1608Metric
C5, C7: 1u; C_0603_1608Metric
C9: 0.1u; C_0402_1005Metric
F1: 0805L050WR; Fuse_0805_2012Metric
FID1: Fiducial_F_TL; Fiducial_0.5mm_Mask1mm
FID2: Fiducial_F_TR; Fiducial_0.5mm_Mask1mm
FID3: Fiducial_F_BL; Fiducial_0.5mm_Mask1mm
FID4: Fiducial_B_TL; Fiducial_0.5mm_Mask1mm
FID5: Fiducial_B_TR; Fiducial_0.5mm_Mask1mm
FID6: Fiducial_B_BL; Fiducial_0.5mm_Mask1mm
H1: Logo Intergalaktik; intergalaktik
H2: Logo NLnet; nlnet
H3: Logo OpenCologne; open_cologne_small
H4: Logo Radiona; radiona_small
H5, H6: MountingHole; MountingHole_2.2mm_M2
J1, J2, J3, J4, J5, J7: SMA; SMA_Amphenol_901-144_Vertical
J6: MISC; PinSocket_2x10_P2.54mm_Vertical_SMD
J8: EXT; PinHeader_1x02_P2.54mm_Vertical
OPAMP1-2: MAX40089AUA+; SOP65P490X110-8N
R1, R2, R8, R9, R10: 1k; R_0402_1005Metric
R3, R4, R5, R6: 10k; R_0402_1005Metric
R7, R11: 22k; R_0402_1005Metric

Connections:
+Exten_V: F1.1, J6.1
+VCC_HIGH: C5.1, C7.1, C9.2, J8.1, OPAMP1-2.8 (VDD), R4.1, R6.1; also elsewhere on the board
+VCC_LOW: F1.2; also elsewhere on the board
/Main Sheet/IN_A+: C8.1, J1.1 (In)
/Main Sheet/IN_A-: C10.1, J2.1 (In)
/Main Sheet/IN_B+: C2.1, J3.1 (In)
/Main Sheet/IN_B-: C4.1, J4.1 (In)
/Main Sheet/NB_A0_0P: C1.1, J5.1 (In), J6.3, OPAMP1-2.1 (OUTA), R11.2
/Main Sheet/NB_A1_1P: J6.5
/Main Sheet/NB_A2_2P: J6.7
/Main Sheet/NB_A3_3P: J6.9
/Main Sheet/NB_A4_4P: J6.11
/Main Sheet/NB_A5_5P: J6.13
/Main Sheet/NB_A6_6P: J6.15
/Main Sheet/NB_A7_7P: J6.17
/Main Sheet/NB_A8_8P: J6.19
/Main Sheet/NB_B0_0N: J6.4, J7.1 (In), OPAMP1-2.7 (OUTB)
/Main Sheet/NB_B1_1N: J6.6
/Main Sheet/NB_B2_2N: J6.8
/Main Sheet/NB_B3_3N: J6.10
/Main Sheet/NB_B4_4N: J6.12
/Main Sheet/NB_B5_5N: J6.14
/Main Sheet/NB_B6_6N: J6.16
/Main Sheet/NB_B7_7N: J6.18
/Main Sheet/NB_B8_8N: J6.20
GND: C3.2, C5.2, C6.2, C7.2, C9.1, J1.2 (Ext), J2.2 (Ext), J3.2 (Ext), J4.2 (Ext), J5.2 (Ext), J6.2, J7.2 (Ext), J8.2, OPAMP1-2.4 (VSS), R3.2, R5.2; also elsewhere on the board
unnamed: C1.2, R10.1
unnamed: C2.2, R1.2
unnamed: C4.2, R2.2
unnamed: C6.1, R5.1, R6.2, R7.1
unnamed: C8.2, R8.1
unnamed: C10.2, R9.1
unnamed: OPAMP1-2.3 (INA+), R7.2, R8.2
unnamed: OPAMP1-2.2 (INA-), R9.2, R11.1
unnamed: C3.1, OPAMP1-2.5 (INB+), R1.1, R3.1, R4.2
unnamed: OPAMP1-2.6 (INB-), R2.1, R10.2

Notes on the sheet:
OUT_A
POWER FLAGS
V_IN over Resettable Fuses - PPTC 0.50A 6V 0805
OUT_B
!!!!!!!!!!!!!!!!!!!!!!!!!!!!!!!!!!!!!!!!!!!!!!!!! Olimex board is delivering MAX 2.5V on connector. You can use 2.5V output signals for 3.3V. Be carefull FPGA input only tolerate MAX 2.5V! !!!!!!!!!!!!!!!!!!!!!!!!!!!!!!!!!!!!!!!!!!!!!!!!!
Fiducials
Use EXT VCC only if not connected to Olimex board!!!
OLIMEX CONNECTOR
Bias of 3V/2
Main Page
!!!!!!!!!!!!!!!!!!!!!!!!!!!!!!!!!!!!!!! Set and Voltage on BANK 1.2V/1.8V/2.5V STEP UP can boost any of those voltages to 3.3V/5V depending on selected chip !!!!!!!!!!!!!!!!!!!!!!!!!!!!!!!!!!!!!!!


Parts:
C13, C14: 10uF; C_0603_1608Metric
IC3: TLV61225DC; SOT-363_SC-70-6
L1: 4.7uH; L_0603_1608Metric
R15: 10K; R_0402_1005Metric; MPN RC0603FR-071K1L; Mouser 603-RC0603FR-071K1L

Connections:
+VCC_HIGH: C14.1, IC3.2 (FB), IC3.4 (VOUT); also elsewhere on the board
+VCC_LOW: C13.1, IC3.1 (VIN), L1.2, R15.1; also elsewhere on the board
GND: C13.2, C14.2, IC3.3 (GND); also elsewhere on the board
unnamed: IC3.6 (EN), R15.2
unnamed: IC3.5 (L), L1.1

Notes on the sheet:
Up to 300-mA Output Current 1-MHz Fixed-Frequency PWM Operation
Use TPS61222DC for 2.5V>>5V
Power Page
StepUp 2V5>>3V3
Use TPS61225DC for 2.5V>>3.3V

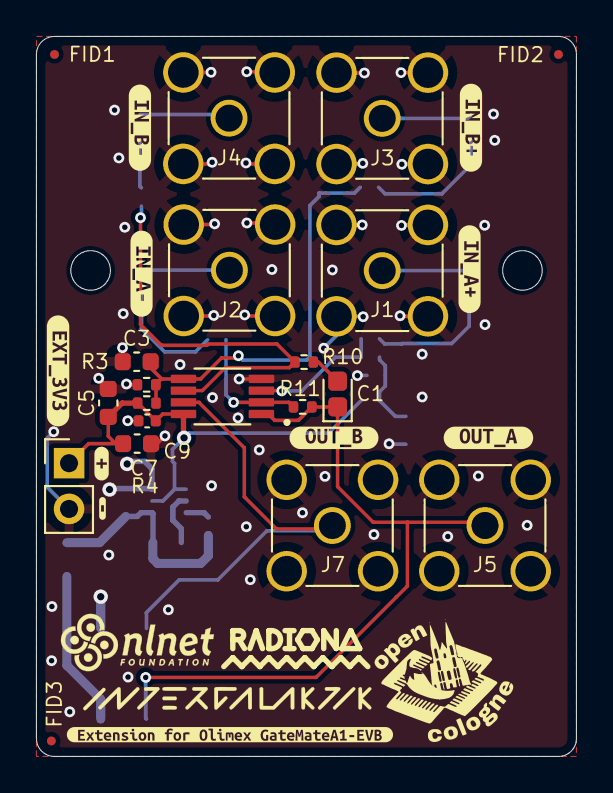
[picture p87: board adcIO.kicad_pcb from above]

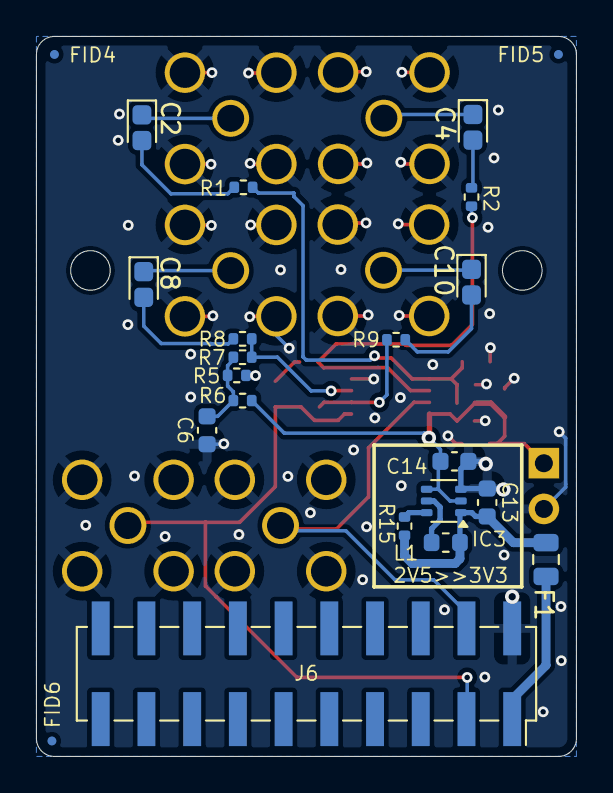
[picture p88: board adcIO.kicad_pcb from below]

Board: 4 copper layers, 30.0 x 40.0 mm, 58 parts (22 on the bottom side), 22 nets.

Other parts of the board:
kibuzzard-674D68C8: G***; kibuzzard-674D68C8
kibuzzard-67560CBC: G***; kibuzzard-67560CBC
kibuzzard-67560CDF: G***; kibuzzard-67560CDF
kibuzzard-67560D10: G***; kibuzzard-67560D10
kibuzzard-67560D36: G***; kibuzzard-67560D36
kibuzzard-67560E96: G***; kibuzzard-67560E96
kibuzzard-67560ECB: G***; kibuzzard-67560ECB
kibuzzard-67561DC2: G***; kibuzzard-67561DC2
kibuzzard-67561FBD: G***; kibuzzard-67561FBD
kibuzzard-6756200A: G***; kibuzzard-6756200A
