intergalaktik/Extension_Boards_for_Olimex_GateMate/GamePad_I2S_audio_Buttons/KiCad/GamePad_I2S_audio.kicad_pcb

## KiCad design GamePad_I2S_audio_Buttons/KiCad/GamePad_I2S_audio.kicad_pcb (2024-12-11)

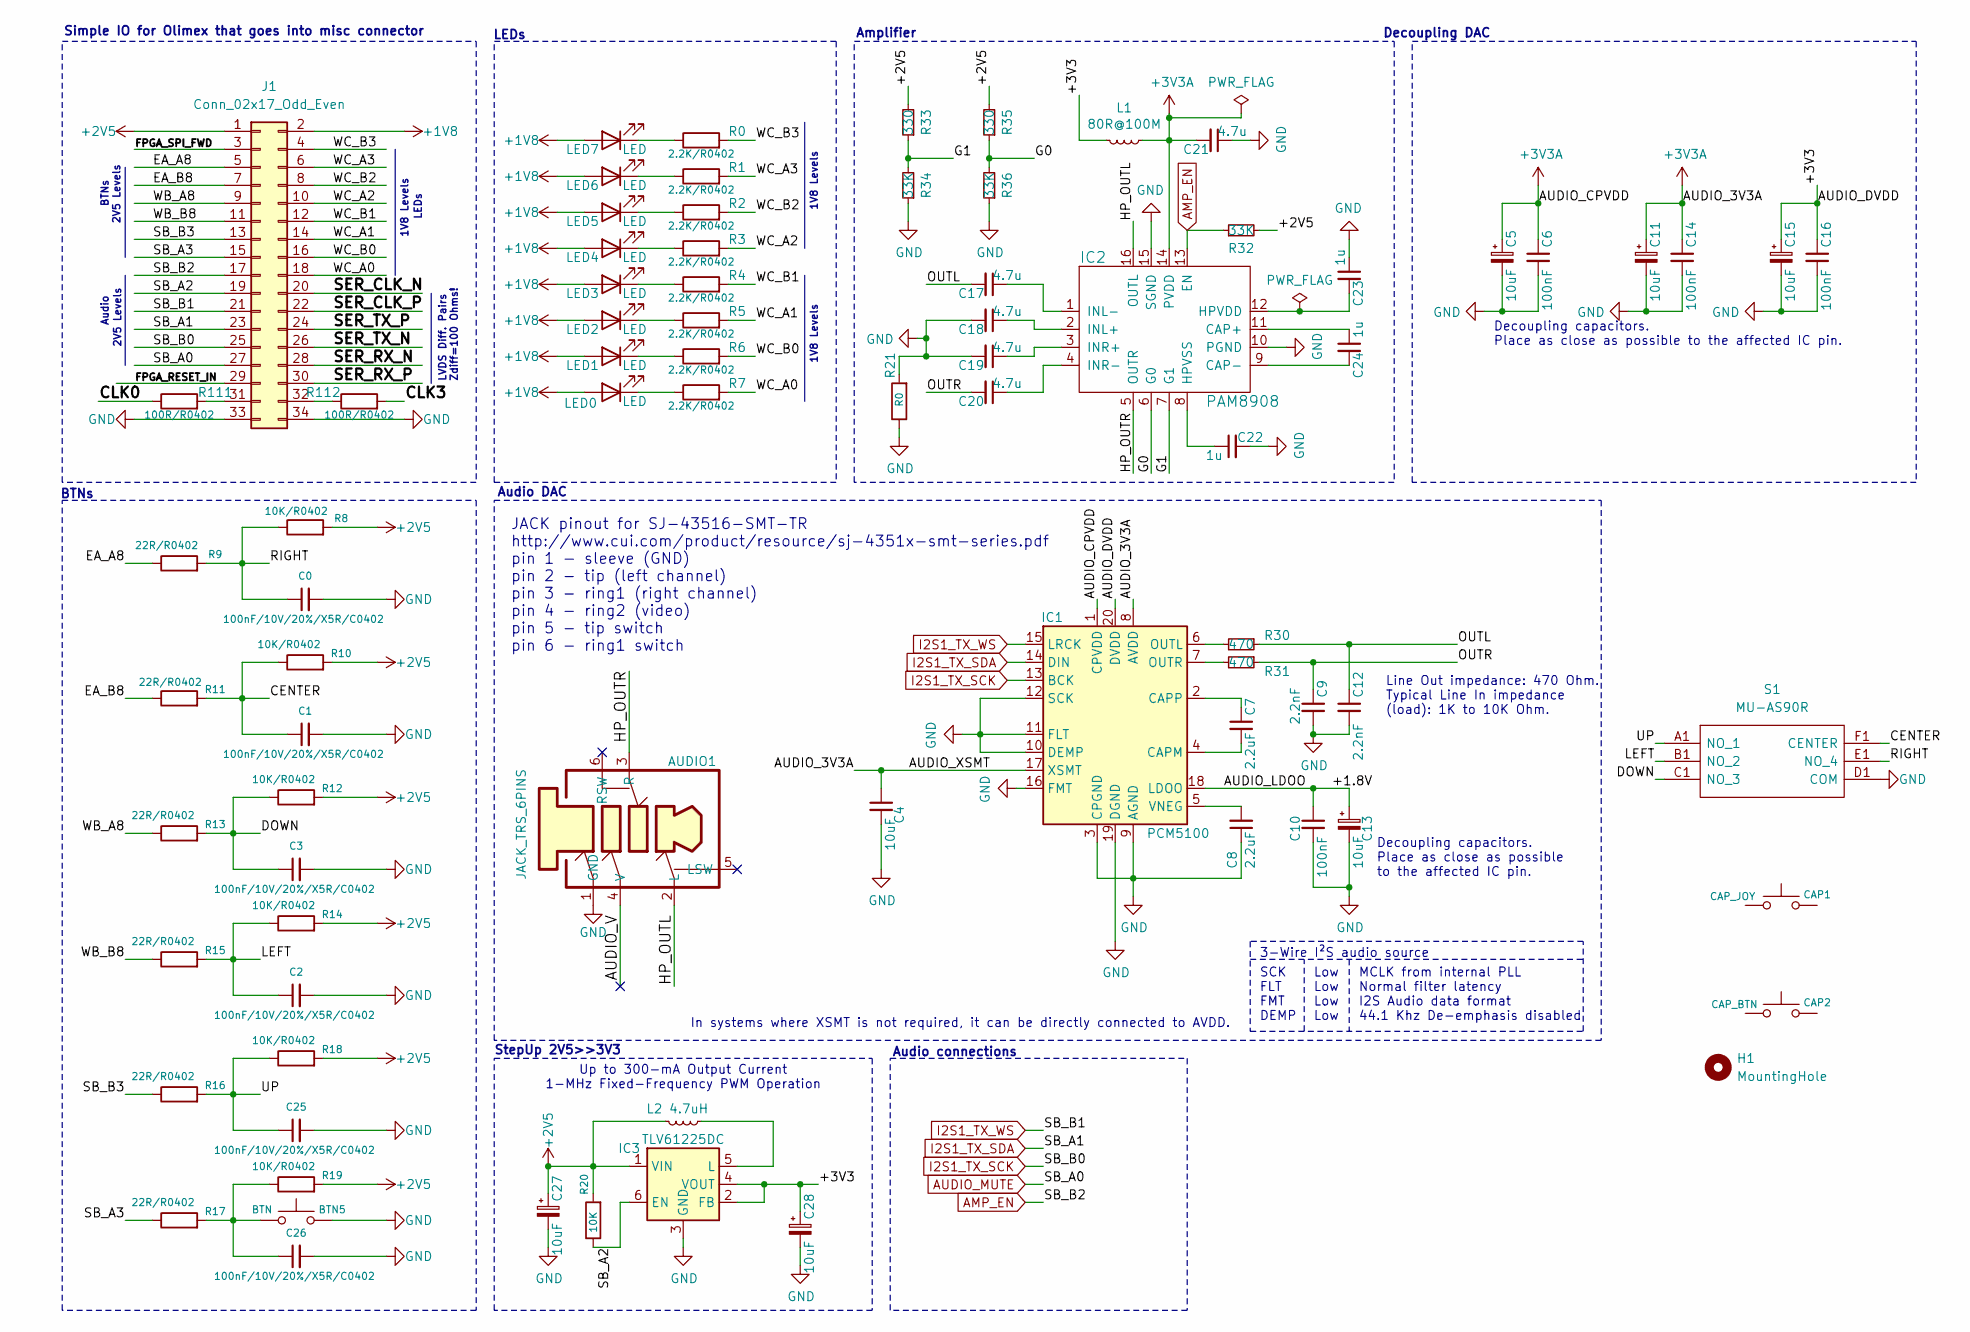
[picture p89: schematic GamePad_I2S_audio.kicad_sch]

Parts:
AUDIO1: JACK_TRS_6PINS; CUI_SJ-43516-SMT; MPN SJ-43516-SMT-TR; Mouser 490-SJ43515TS-SMT-TR
BTN5: BTN; B3FS4055P
C0, C1, C2, C3, C25, C26: 100nF/10V/20%/X5R/C0402; C_0402_1005Metric
C4, C5, C11, C13, C15, C27, C28: 10uF; C_0603_1608Metric
C6, C10, C14, C16: 100nF; C_0402_1005Metric
C7, C8: 2.2uF; C_0402_1005Metric
C9, C12: 2.2nF; C_0402_1005Metric
C17, C18, C19, C20, C21: 4.7u; C_0603_1608Metric
C22, C23, C24: 1u; C_0603_1608Metric
CAP1: CAP_JOY; TestPoint_Pad_1.0x1.0mm
CAP2: CAP_BTN; TestPoint_Pad_1.0x1.0mm
H1: MountingHole; MountingHole_2mm
IC1: PCM5100; TSSOP-20_4.4x6.5mm_P0.65mm
IC2: PAM8908; QFN-16-1EP_3x3mm_P0.5mm_EP1.7x1.7mm_ThermalVias
IC3: TLV61225DC; SOT-363_SC-70-6
J1: Conn_02x17_Odd_Even; PinSocket_2x17_P2.54mm_Vertical_SMD
L1: 80R@100M; L_0603_1608Metric
L2: 4.7uH; L_0603_1608Metric
LED0, LED1, LED2, LED3, LED4, LED5, LED6, LED7: LED; LED_0603_1608Metric
R0, R1, R2, R3, R4, R5, R6, R7: 2.2K/R0402; R_0402_1005Metric
R8, R10, R12, R14, R18, R19: 10K/R0402; R_0402_1005Metric
R9, R11, R13, R15, R16, R17: 22R/R0402; R_0402_1005Metric
R20: 10K; R_0402_1005Metric
R21: R0; R_0402_1005Metric
R30, R31: 470; R_0402_1005Metric
R32, R34, R36: 33K; R_0402_1005Metric
R33, R35: 330; R_0402_1005Metric
R111, R112: 100R/R0402; R_0402_1005Metric
S1: MU-AS90R; MUAS90R; Mouser Part Number 642-MU-AS90R

Connections:
+1V8: J1.2, LED0.2 (A), LED1.2 (A), LED2.2 (A), LED3.2 (A), LED4.2 (A), LED5.2 (A), LED6.2 (A), LED7.2 (A)
+2V5: C27.1, IC3.1 (VIN), J1.1, L2.2, R8.2, R10.2, R12.2, R14.2, R18.2, R19.2, R20.2, R32.2, R33.2, R35.2
+3V3A: C4.1, C5.1, C6.1, C11.1, C14.1, C21.2, IC1.1 (CPVDD), IC1.8 (AVDD), IC1.17 (XSMT), IC2.14 (PVDD), L1.1
/+1.8V: C10.1, C13.1, IC1.18 (LDOO)
/+3V3: C15.1, C16.1, C28.1, IC1.20 (DVDD), IC3.2 (FB), IC3.4 (VOUT), L1.2
/AUDIO_V: AUDIO1.4 (V)
/CENTER: C1.1, R10.1, R11.2, S1.F1 (CENTER)
/CLK0: R111.1
/CLK3: R112.2
/DOWN: C3.1, R12.1, R13.2, S1.C1 (NO_3)
/EA_A8: J1.5, R9.1
/EA_B8: J1.7, R11.1
/FPGA_RESET_IN: J1.29
/FPGA_SPI_FWD: J1.3
/G0: IC2.6 (G0), R35.1, R36.2
/G1: IC2.7 (G1), R33.1, R34.2
/HP_OUTL: AUDIO1.2 (L), IC2.16 (OUTL)
/HP_OUTR: AUDIO1.3 (R), IC2.5 (OUTR)
/LEFT: C2.1, R14.1, R15.2, S1.B1 (NO_2)
/OUTL: C12.1, C17.2, R30.1
/OUTR: C9.1, C20.2, R31.1
/RIGHT: C0.1, R8.1, R9.2, S1.E1 (NO_4)
/SB_A2: IC3.6 (EN), J1.19, R20.1
/SB_A3: J1.15, R17.1
/SB_B3: J1.13, R16.1
/SER_CLK_N: J1.20
/SER_CLK_P: J1.22
/SER_RX_N: J1.28
/SER_RX_P: J1.30
/SER_TX_N: J1.26
/SER_TX_P: J1.24
/UP: C25.1, R16.2, R18.1, S1.A1 (NO_1)
/WB_A8: J1.9, R13.1
/WB_B8: J1.11, R15.1
/WC_A0: J1.18, R7.2
/WC_A1: J1.14, R5.2
/WC_A2: J1.10, R3.2
/WC_A3: J1.6, R1.2
/WC_B0: J1.16, R6.2
/WC_B1: J1.12, R4.2
/WC_B2: J1.8, R2.2
/WC_B3: J1.4, R0.2
AMP_EN: IC2.13 (EN), J1.17, R32.1
AUDIO_MUTE: J1.27
GND: AUDIO1.1 (GND), BTN5.2, C0.2, C1.2, C2.2, C3.2, C4.2, C5.2, C6.2, C8.1, C9.2, C10.2, C11.2, C12.2, C13.2, C14.2, C15.2, C16.2, C18.2, C19.2, C21.1, C22.2, C23.1, C25.2, C26.2, C27.2, C28.2, IC1.3 (CPGND), IC1.9 (AGND), IC1.10 (DEMP), IC1.11 (FLT), IC1.12 (SCK), IC1.16 (FMT), IC1.19 (DGND), IC2.10 (PGND), IC2.15 (SGND), IC3.3 (GND), J1.33, J1.34, R21.1, R21.2, R34.1, R36.1, S1.D1 (COM)
I2S1_TX_SCK: IC1.13 (BCK), J1.25
I2S1_TX_SDA: IC1.14 (DIN), J1.23
I2S1_TX_WS: IC1.15 (LRCK), J1.21
unnamed: BTN5.3 (1), C26.1, R17.2, R19.1
unnamed: C7.2, IC1.4 (CAPM)
unnamed: C7.1, IC1.2 (CAPP)
unnamed: IC1.6 (OUTL), R30.2
unnamed: IC1.7 (OUTR), R31.2
unnamed: C8.2, IC1.5 (VNEG)
unnamed: C24.1, IC2.11 (CAP+)
unnamed: C24.2, IC2.9 (CAP-)
unnamed: C23.2, IC2.12 (HPVDD)
unnamed: C22.1, IC2.8 (HPVSS)
unnamed: C18.1, IC2.2 (INL+)
unnamed: C17.1, IC2.1 (INL-)
unnamed: C19.1, IC2.3 (INR+)
unnamed: C20.1, IC2.4 (INR-)
unnamed: IC3.5 (L), L2.1
unnamed: J1.31, R111.2
unnamed: J1.32, R112.1
unnamed: LED0.1 (K), R7.1
unnamed: LED1.1 (K), R6.1
unnamed: LED2.1 (K), R5.1
unnamed: LED3.1 (K), R4.1
unnamed: LED4.1 (K), R3.1
unnamed: LED5.1 (K), R2.1
unnamed: LED6.1 (K), R1.1
unnamed: LED7.1 (K), R0.1

Notes on the sheet:
2V5 Levels
1V8 Levels
Up to 300-mA Output Current 1-MHz Fixed-Frequency PWM Operation
Audio connections
Audio DAC
Line Out impedance: 470 Ohm. Typical Line In impedance (load): 1K to 10K Ohm.
StepUp 2V5>>3V3
BTNs
In systems where XSMT is not required, it can be directly connected to AVDD.
3-Wire I²S audio source
Low Low Low Low
Decoupling capacitors. Place as close as possible to the affected IC pin.
Amplifier
JACK pinout for SJ-43516-SMT-TR http://www.cui.com/product/resource/sj-4351x-smt-series.pdf pin 1 - sleeve (GND) pin 2 - tip (left channel) pin 3 - ring1 (right channel) pin 4 - ring2 (video) pin 5 - tip switch pin 6 - ring1 switch
LVDS Diff. Pairs Zdiff=100 Ohms!
SCK FLT FMT DEMP
MCLK from internal PLL Normal filter latency I2S Audio data format 44.1 Khz De-emphasis disabled
Audio
LEDs
Simple IO for Olimex that goes into misc connector
Decoupling capacitors. Place as close as possible to the affected IC pin.
Decoupling DAC

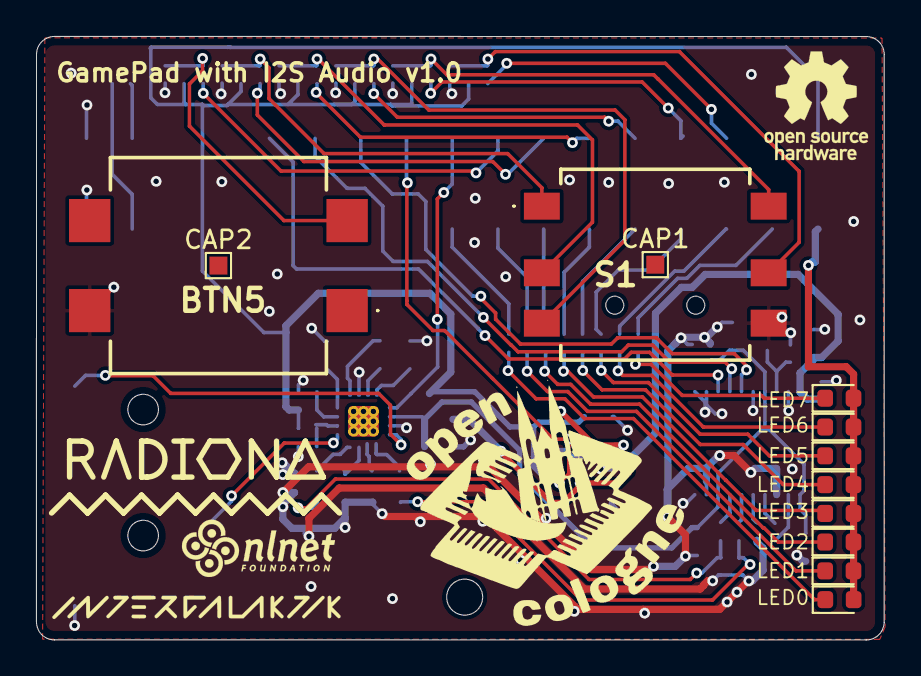
[picture p90: board GamePad_I2S_audio.kicad_pcb from above]

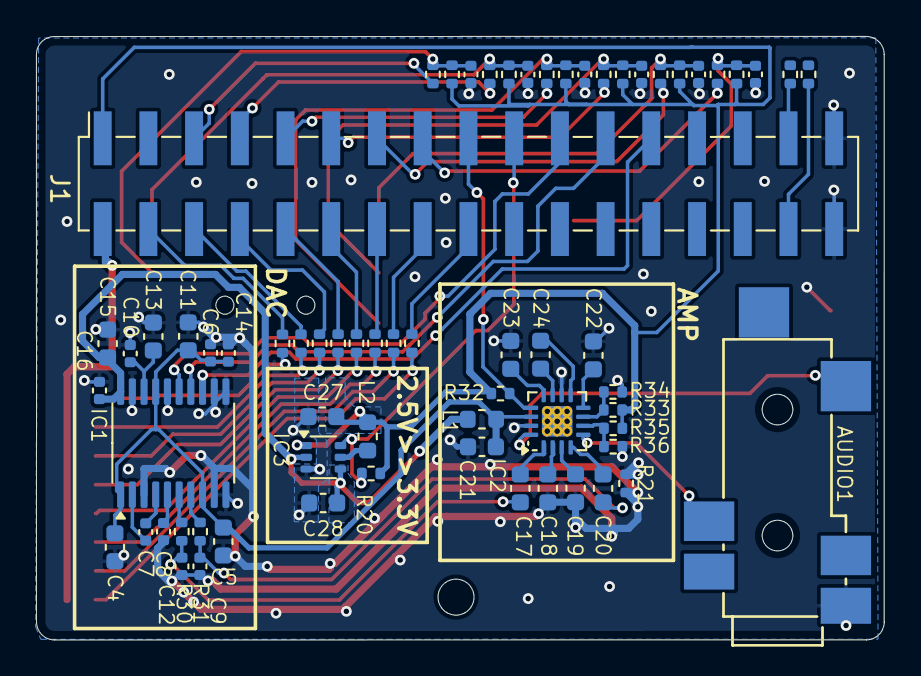
[picture p91: board GamePad_I2S_audio.kicad_pcb from below]

Board: 4 copper layers, 47.1 x 33.5 mm, 81 parts (67 on the bottom side), 61 nets.

Other parts of the board:
radiona: radiona
