intergalaktik/Extension_Boards_for_Olimex_GateMate/tmrIO/tmrIO.kicad_pcb

## KiCad design tmrIO/tmrIO.kicad_pcb (2024-12-05)

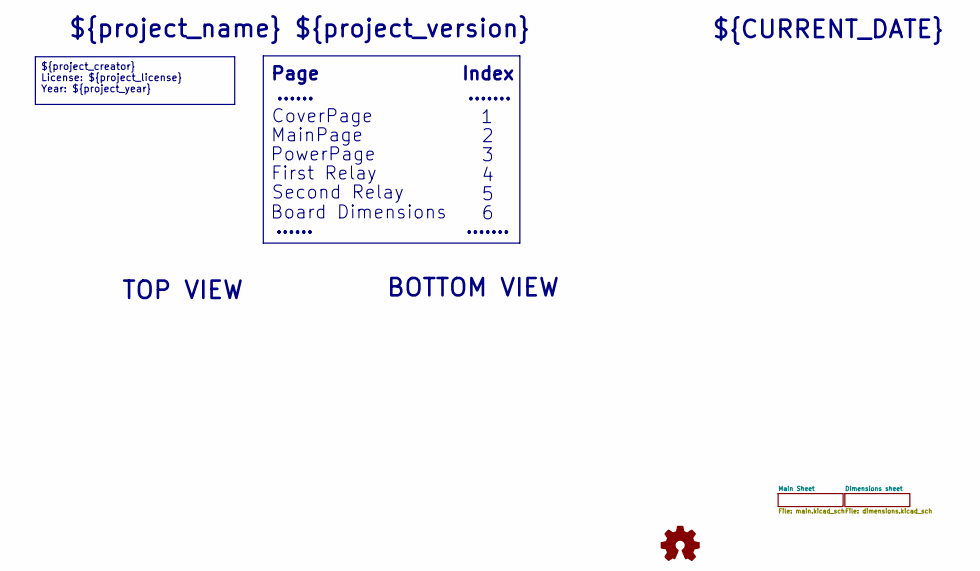
[picture p92: schematic tmrIO.kicad_sch, ${project_name} ${project_version}]

Notes on the sheet:
${project_creator} License: ${project_license} Year: ${project_year}
BOTTOM VIEW
Index
First Relay
......
PowerPage
.......
CoverPage
Board Dimensions
Second Relay
MainPage
${CURRENT_DATE}
${project_name} ${project_version}
TOP VIEW
Page

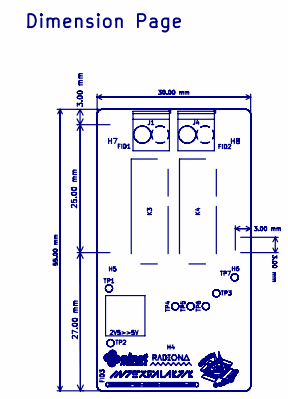
[picture p93: schematic dimensions.kicad_sch, ${project_name} ${project_version}]

Notes on the sheet:
Dimension Page

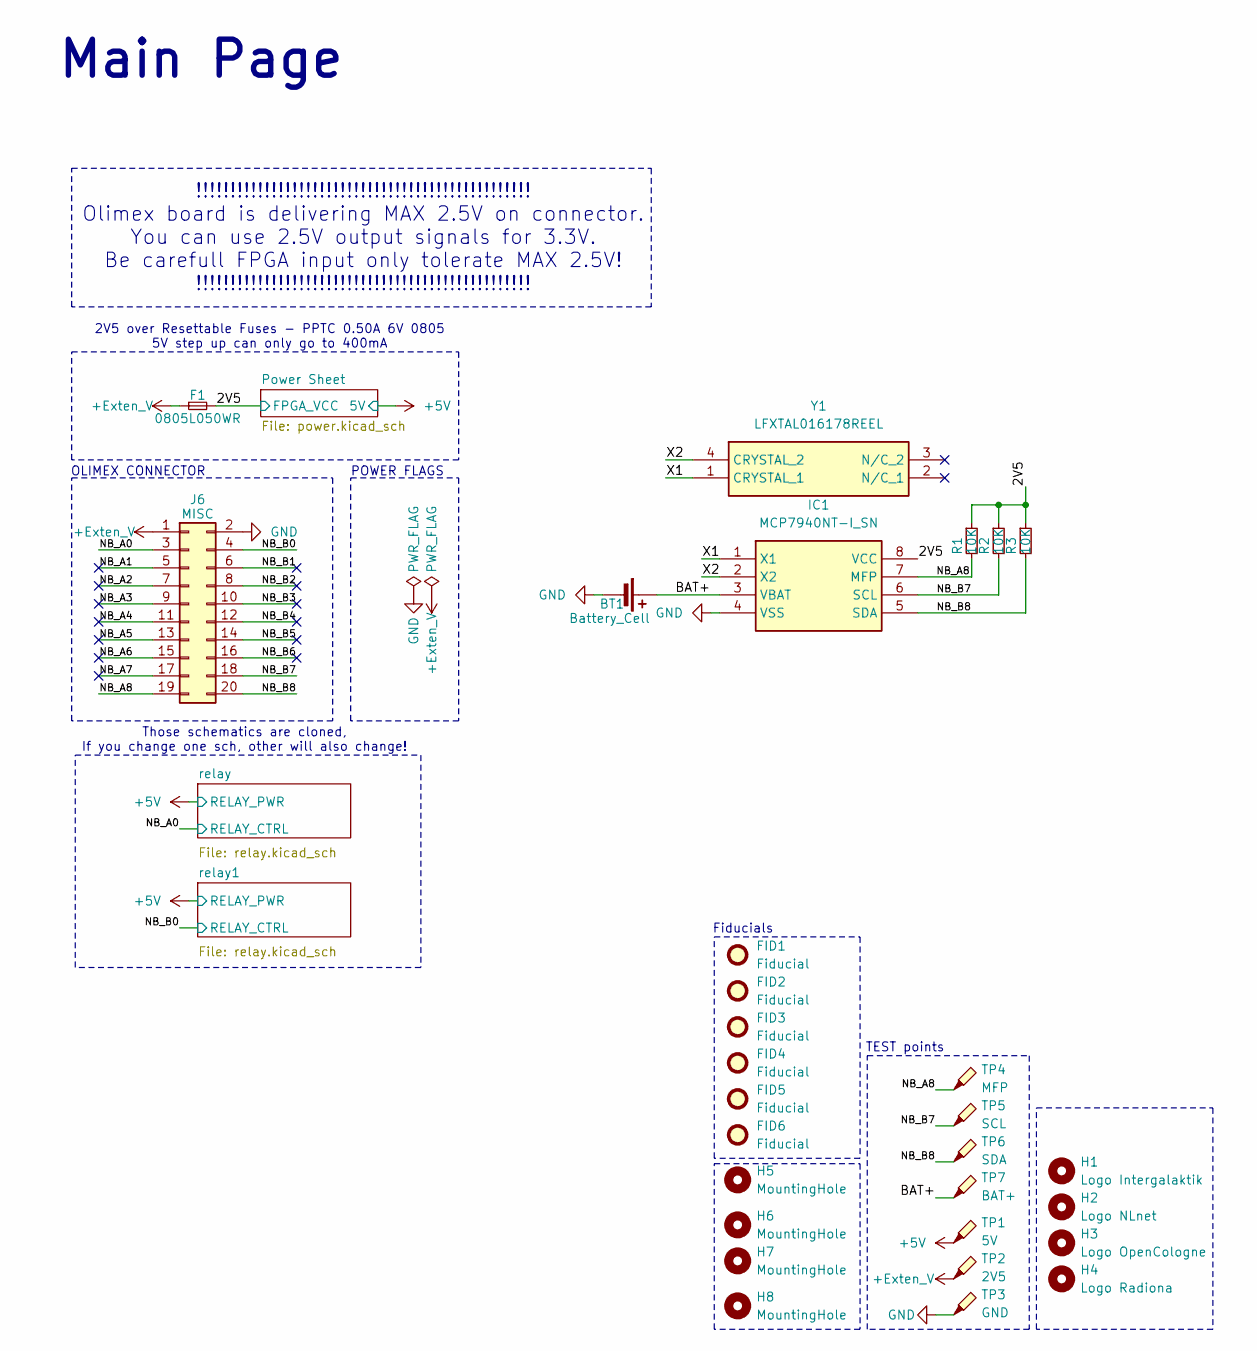
[picture p94: schematic main.kicad_sch, ${project_name} ${project_version}]

Parts:
BT1: Battery_Cell; BatteryHolder_Keystone_2998_1x6.8mm
F1: 0805L050WR; Fuse_0805_2012Metric
FID1, FID2, FID3, FID4, FID5, FID6: Fiducial; Fiducial_0.5mm_Mask1mm
H1: Logo Intergalaktik; intergalaktik
H2: Logo NLnet; nlnet
H3: Logo OpenCologne; open_cologne_small
H4: Logo Radiona; radiona_small
H5, H6, H7, H8: MountingHole; MountingHole_2.2mm_M2
IC1: MCP7940NT-I_SN; SOIC127P600X175-8N; Mouser Part Number 579-MCP7940NT-I/SN
J6: MISC; PinSocket_2x10_P2.54mm_Vertical_SMD
R1, R2, R3: 10K; R_0402_1005Metric; MPN RC0603FR-071K1L; Mouser 603-RC0603FR-071K1L
TP1: 5V; TestPoint_Pad_D1.0mm
TP2: 2V5; TestPoint_Pad_D1.0mm
TP3: GND; TestPoint_Pad_D1.0mm
TP4: MFP; TestPoint_Pad_D1.0mm
TP5: SCL; TestPoint_Pad_D1.0mm
TP6: SDA; TestPoint_Pad_D1.0mm
TP7: BAT+; TestPoint_Pad_D1.0mm
Y1: LFXTAL016178REEL; Mouser Part Number 449-LFXTAL016178REEL

Connections:
+5V: TP1.1; also elsewhere on the board
+Exten_V: F1.1, J6.1, TP2.1
/Main Sheet/2V5: F1.2, IC1.8 (VCC), R1.1, R2.1, R3.1; also elsewhere on the board
/Main Sheet/BAT+: BT1.1 (+), IC1.3 (VBAT), TP7.1
/Main Sheet/NB_A0: J6.3; also elsewhere on the board
/Main Sheet/NB_A1: J6.5
/Main Sheet/NB_A2: J6.7
/Main Sheet/NB_A3: J6.9
/Main Sheet/NB_A4: J6.11
/Main Sheet/NB_A5: J6.13
/Main Sheet/NB_A6: J6.15
/Main Sheet/NB_A7: J6.17
/Main Sheet/NB_A8: IC1.7 (MFP), J6.19, R1.2, TP4.1
/Main Sheet/NB_B0: J6.4; also elsewhere on the board
/Main Sheet/NB_B1: J6.6
/Main Sheet/NB_B2: J6.8
/Main Sheet/NB_B3: J6.10
/Main Sheet/NB_B4: J6.12
/Main Sheet/NB_B5: J6.14
/Main Sheet/NB_B6: J6.16
/Main Sheet/NB_B7: IC1.6 (SCL), J6.18, R2.2, TP5.1
/Main Sheet/NB_B8: IC1.5 (SDA), J6.20, R3.2, TP6.1
/Main Sheet/X1: IC1.1 (X1), Y1.1 (CRYSTAL_1)
/Main Sheet/X2: IC1.2 (X2), Y1.4 (CRYSTAL_2)
GND: BT1.2 (-), IC1.4 (VSS), J6.2, TP3.1; also elsewhere on the board

Notes on the sheet:
POWER FLAGS
Fiducials
!!!!!!!!!!!!!!!!!!!!!!!!!!!!!!!!!!!!!!!!!!!!!!!!! Olimex board is delivering MAX 2.5V on connector. You can use 2.5V output signals for 3.3V. Be carefull FPGA input only tolerate MAX 2.5V! !!!!!!!!!!!!!!!!!!!!!!!!!!!!!!!!!!!!!!!!!!!!!!!!!
Those schematics are cloned, If you change one sch, other will also change!
TEST points
OLIMEX CONNECTOR
2V5 over Resettable Fuses - PPTC 0.50A 6V 0805 5V step up can only go to 400mA
Main Page

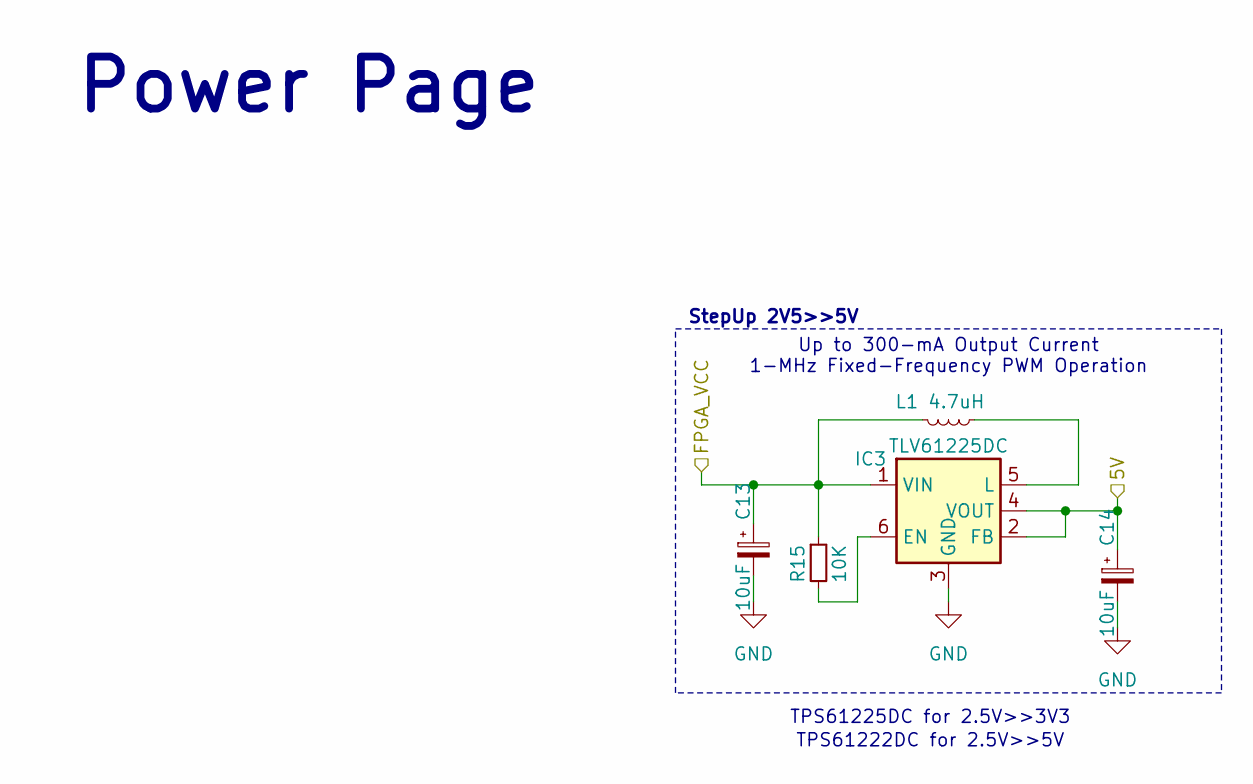
[picture p95: schematic power.kicad_sch, ${project_name} ${project_version}]

Parts:
C13, C14: 10uF; C_0603_1608Metric
IC3: TLV61225DC; SOT-363_SC-70-6
L1: 4.7uH; L_0603_1608Metric
R15: 10K; R_0402_1005Metric; MPN RC0603FR-071K1L; Mouser 603-RC0603FR-071K1L

Connections:
+5V: C14.1, IC3.2 (FB), IC3.4 (VOUT); also elsewhere on the board
/Main Sheet/2V5: C13.1, IC3.1 (VIN), L1.2, R15.1; also elsewhere on the board
GND: C13.2, C14.2, IC3.3 (GND); also elsewhere on the board
unnamed: IC3.6 (EN), R15.2
unnamed: IC3.5 (L), L1.1

Notes on the sheet:
Power Page
StepUp 2V5>>5V
Up to 300-mA Output Current 1-MHz Fixed-Frequency PWM Operation
TPS61222DC for 2.5V>>5V
TPS61225DC for 2.5V>>3V3

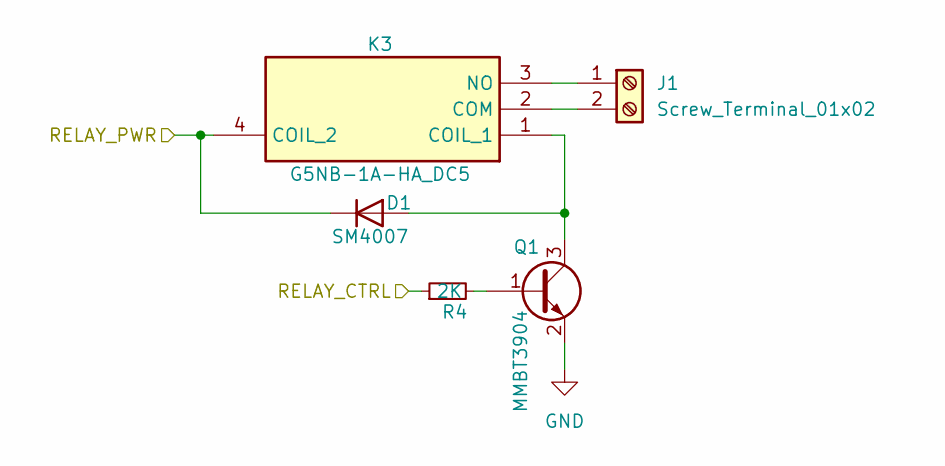
[picture p96: schematic relay.kicad_sch, ${project_name} ${project_version}]

Parts:
D1: SM4007; D_MELF
J1: Screw_Terminal_01x02; TerminalBlock_Phoenix_PT-1,5-2-3.5-H_1x02_P3.50mm_Horizontal
K3: G5NB-1A-HA_DC5; G5NB1AHADC5; Mouser Part Number 653-G5NB-1A-HADC5
Q1: MMBT3904; SOT-23
R4: 2K; R_0402_1005Metric; MPN RC0603FR-071K1L; Mouser 603-RC0603FR-071K1L

Connections:
+5V: D1.1 (K), K3.4 (COIL_2); also elsewhere on the board
/Main Sheet/NB_A0: R4.1; also elsewhere on the board
GND: Q1.2 (E); also elsewhere on the board
unnamed: D1.2 (A), K3.1 (COIL_1), Q1.3 (C)
unnamed: J1.1, K3.3 (NO)
unnamed: J1.2, K3.2 (COM)
unnamed: Q1.1 (B), R4.2

Parts of its further copies:
D2: SM4007; D_MELF
J4: Screw_Terminal_01x02; TerminalBlock_Phoenix_PT-1,5-2-3.5-H_1x02_P3.50mm_Horizontal
K4: G5NB-1A-HA_DC5; G5NB1AHADC5; Mouser Part Number 653-G5NB-1A-HADC5
Q2: MMBT3904; SOT-23
R5: 2K; R_0402_1005Metric; MPN RC0603FR-071K1L; Mouser 603-RC0603FR-071K1L

Connections of its further copies:
+5V: D2.1 (K), K4.4 (COIL_2); also elsewhere on the board
/Main Sheet/NB_B0: R5.1; also elsewhere on the board
GND: Q2.2 (E); also elsewhere on the board
unnamed: D2.2 (A), K4.1 (COIL_1), Q2.3 (C)
unnamed: J4.1, K4.3 (NO)
unnamed: J4.2, K4.2 (COM)
unnamed: Q2.1 (B), R5.2
