intergalaktik/Extension_Boards_for_Olimex_GateMate/tmrIO/tmrIO.kicad_pcb

## KiCad design tmrIO/tmrIO.kicad_pcb (continued)

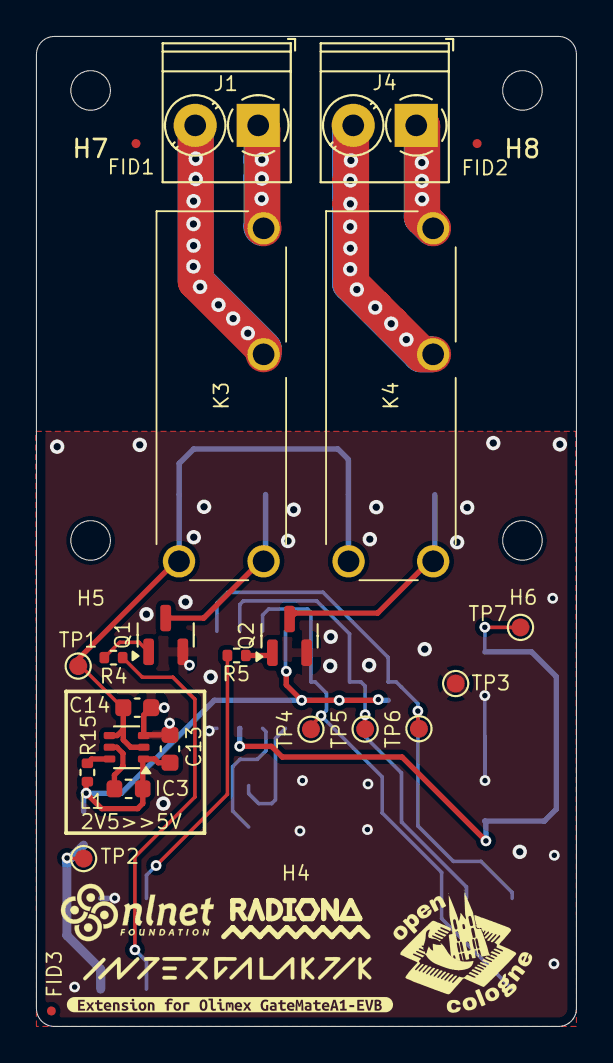
[picture p97: board tmrIO.kicad_pcb from above]

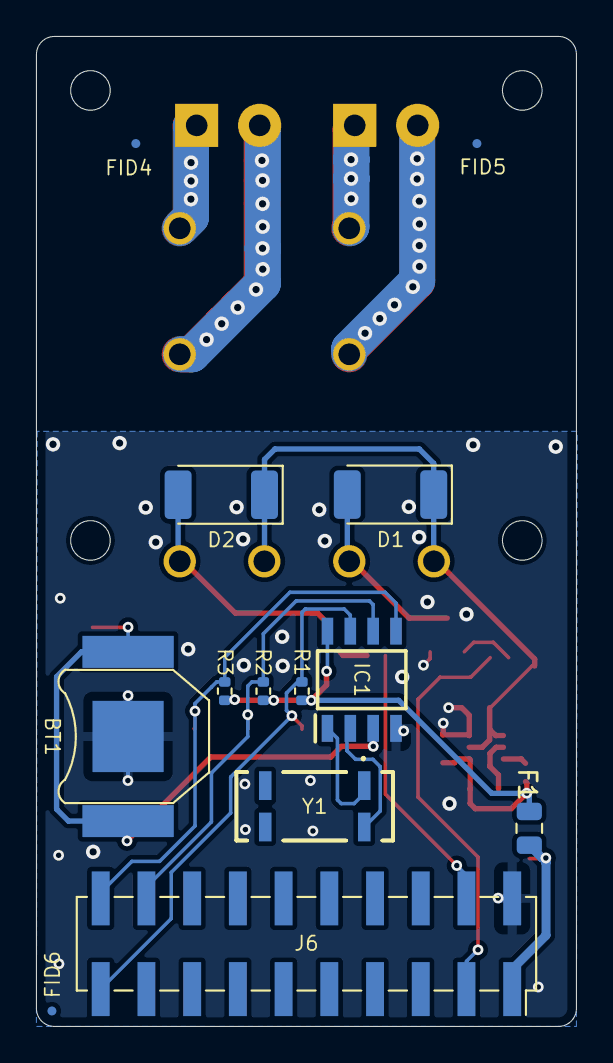
[picture p98: board tmrIO.kicad_pcb from below]

Board: 4 copper layers, 30.0 x 55.0 mm, 45 parts (13 on the bottom side), 22 nets.

Other parts of the board:
kibuzzard-674D68C8: G***; kibuzzard-674D68C8
