intergalaktik/Extension_Boards_for_Olimex_GateMate/simpleIO/KiCad/simpleIO.kicad_pcb

## KiCad design simpleIO/KiCad/simpleIO.kicad_pcb (2024-10-16)

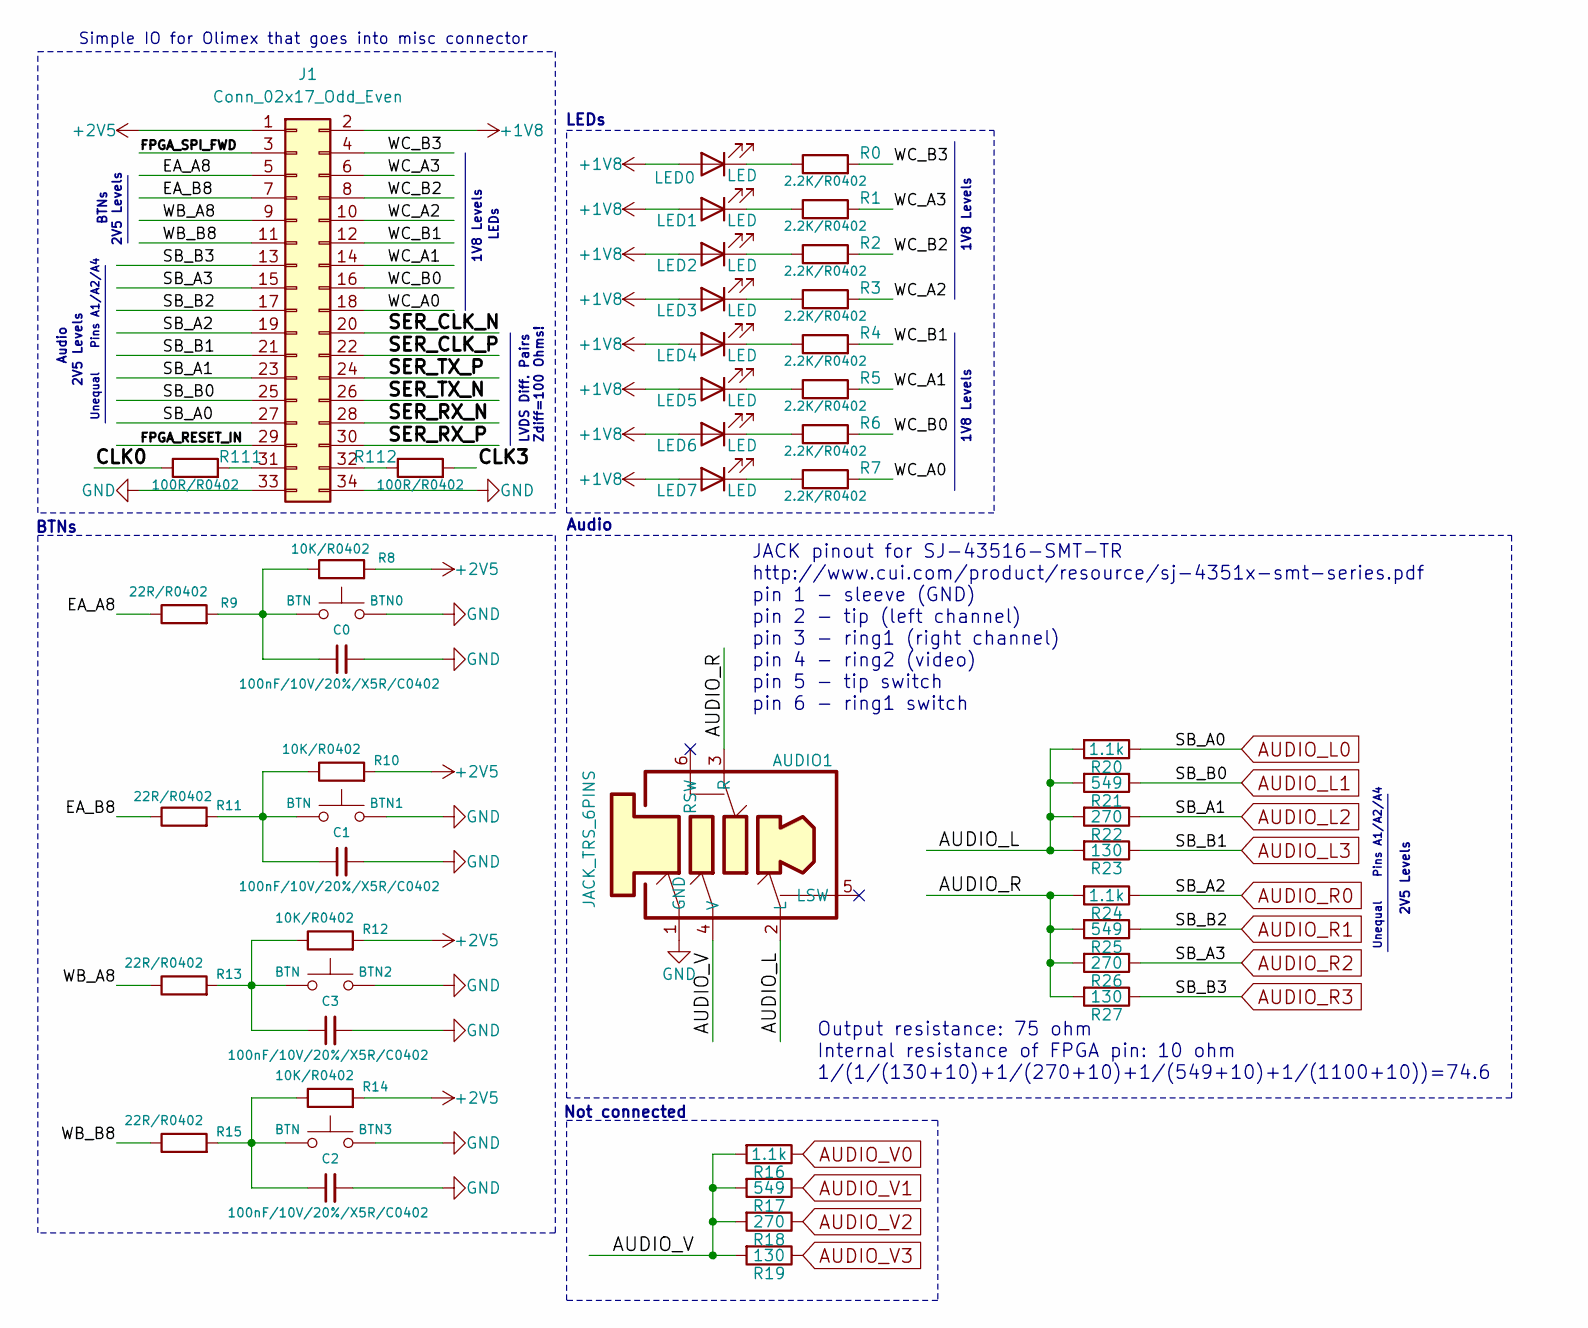
[picture p99: schematic simpleIO.kicad_sch]

Parts:
AUDIO1: JACK_TRS_6PINS; CUI_SJ-43516-SMT; MPN SJ-43516-SMT-TR; Mouser 490-SJ43515TS-SMT-TR
BTN0, BTN1, BTN2, BTN3: BTN; SW_SPST_B3S-1000
C0, C1, C2, C3: 100nF/10V/20%/X5R/C0402; C_0603_1608Metric
J1: Conn_02x17_Odd_Even; PinSocket_2x17_P2.54mm_Vertical_SMD
LED0, LED1, LED2, LED3, LED4, LED5, LED6, LED7: LED; LED_0603_1608Metric
R0, R1, R2, R3, R4, R5, R6, R7: 2.2K/R0402; R_0603_1608Metric
R8, R10, R12, R14: 10K/R0402; R_0603_1608Metric
R9, R11, R13, R15: 22R/R0402; R_0603_1608Metric
R16, R24: 1.1k; R_0603_1608Metric
R17, R25: 549; R_0603_1608Metric
R18, R26: 270; R_0603_1608Metric
R19, R27: 130; R_0603_1608Metric
R20: 1.1k; R_0603_1608Metric; MPN RC0603FR-071K1L; Mouser 603-RC0603FR-071K1L
R21: 549; R_0603_1608Metric; MPN RC0603FR-07549RL; Mouser 603-RC0603FR-07549RL
R22: 270; R_0603_1608Metric; MPN RC0603FR-07270RL; Mouser 603-AC0603FR-07270RL
R23: 130; R_0603_1608Metric; MPN RC0603FR-07130RL; Mouser 603-RC0603FR-07130RL
R111, R112: 100R/R0402; R_0603_1608Metric

Connections:
+1V8: J1.2, LED0.2 (A), LED1.2 (A), LED2.2 (A), LED3.2 (A), LED4.2 (A), LED5.2 (A), LED6.2 (A), LED7.2 (A)
+2V5: J1.1, R8.2, R10.2, R12.2, R14.2
/AUDIO_L: AUDIO1.2 (L), R20.2, R21.2, R22.2, R23.2
/AUDIO_R: AUDIO1.3 (R), R24.2, R25.2, R26.2, R27.2
/AUDIO_V: AUDIO1.4 (V), R16.2, R17.2, R18.2, R19.2
/CLK0: R111.1
/CLK3: R112.2
/EA_A8: J1.5, R9.1
/EA_B8: J1.7, R11.1
/FPGA_RESET_IN: J1.29
/FPGA_SPI_FWD: J1.3
/SER_CLK_N: J1.20
/SER_CLK_P: J1.22
/SER_RX_N: J1.28
/SER_RX_P: J1.30
/SER_TX_N: J1.26
/SER_TX_P: J1.24
/WB_A8: J1.9, R13.1
/WB_B8: J1.11, R15.1
/WC_A0: J1.18, R7.2
/WC_A1: J1.14, R5.2
/WC_A2: J1.10, R3.2
/WC_A3: J1.6, R1.2
/WC_B0: J1.16, R6.2
/WC_B1: J1.12, R4.2
/WC_B2: J1.8, R2.2
/WC_B3: J1.4, R0.2
AUDIO_L0: J1.27, R20.1
AUDIO_L1: J1.25, R21.1
AUDIO_L2: J1.23, R22.1
AUDIO_L3: J1.21, R23.1
AUDIO_R0: J1.19, R24.1
AUDIO_R1: J1.17, R25.1
AUDIO_R2: J1.15, R26.1
AUDIO_R3: J1.13, R27.1
AUDIO_V0: R16.1
AUDIO_V1: R17.1
AUDIO_V2: R18.1
AUDIO_V3: R19.1
GND: AUDIO1.1 (GND), BTN0.2, BTN1.2, BTN2.2, BTN3.2, C0.2, C1.2, C2.2, C3.2, J1.33, J1.34
unnamed: BTN0.1, C0.1, R8.1, R9.2
unnamed: BTN1.1, C1.1, R10.1, R11.2
unnamed: BTN2.1, C3.1, R12.1, R13.2
unnamed: BTN3.1, C2.1, R14.1, R15.2
unnamed: J1.31, R111.2
unnamed: J1.32, R112.1
unnamed: LED0.1 (K), R0.1
unnamed: LED1.1 (K), R1.1
unnamed: LED2.1 (K), R2.1
unnamed: LED3.1 (K), R3.1
unnamed: LED4.1 (K), R4.1
unnamed: LED5.1 (K), R5.1
unnamed: LED6.1 (K), R6.1
unnamed: LED7.1 (K), R7.1

Notes on the sheet:
2V5 Levels
1V8 Levels
Unequal Pins A1/A2/A4
Audio
Output resistance: 75 ohm Internal resistance of FPGA pin: 10 ohm 1/(1/(130+10)+1/(270+10)+1/(549+10)+1/(1100+10))=74.6
BTNs
JACK pinout for SJ-43516-SMT-TR http://www.cui.com/product/resource/sj-4351x-smt-series.pdf pin 1 - sleeve (GND) pin 2 - tip (left channel) pin 3 - ring1 (right channel) pin 4 - ring2 (video) pin 5 - tip switch pin 6 - ring1 switch
LVDS Diff. Pairs Zdiff=100 Ohms!
Not connected
LEDs
Simple IO for Olimex that goes into misc connector

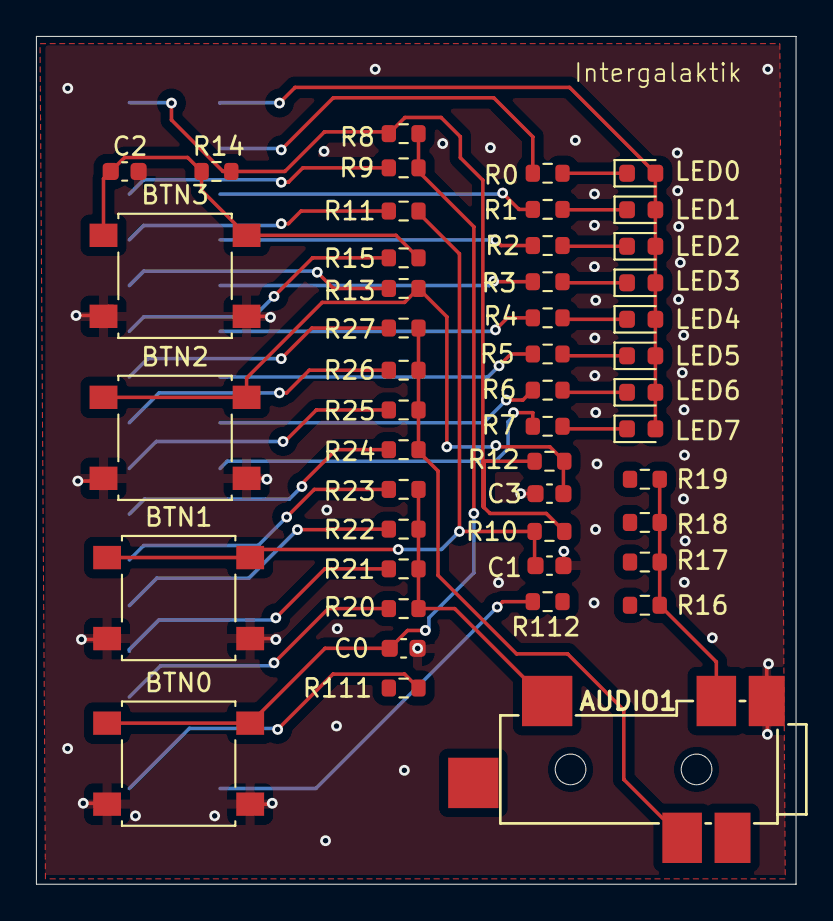
[picture p100: board simpleIO.kicad_pcb from above]

Board: 4 copper layers, 42.2 x 47.1 mm, 48 parts (1 on the bottom side), 40 nets.
