intergalaktik/Extension_Boards_for_Olimex_GateMate/camIO/camIO.kicad_pcb

## KiCad design camIO/camIO.kicad_pcb (2024-12-11)

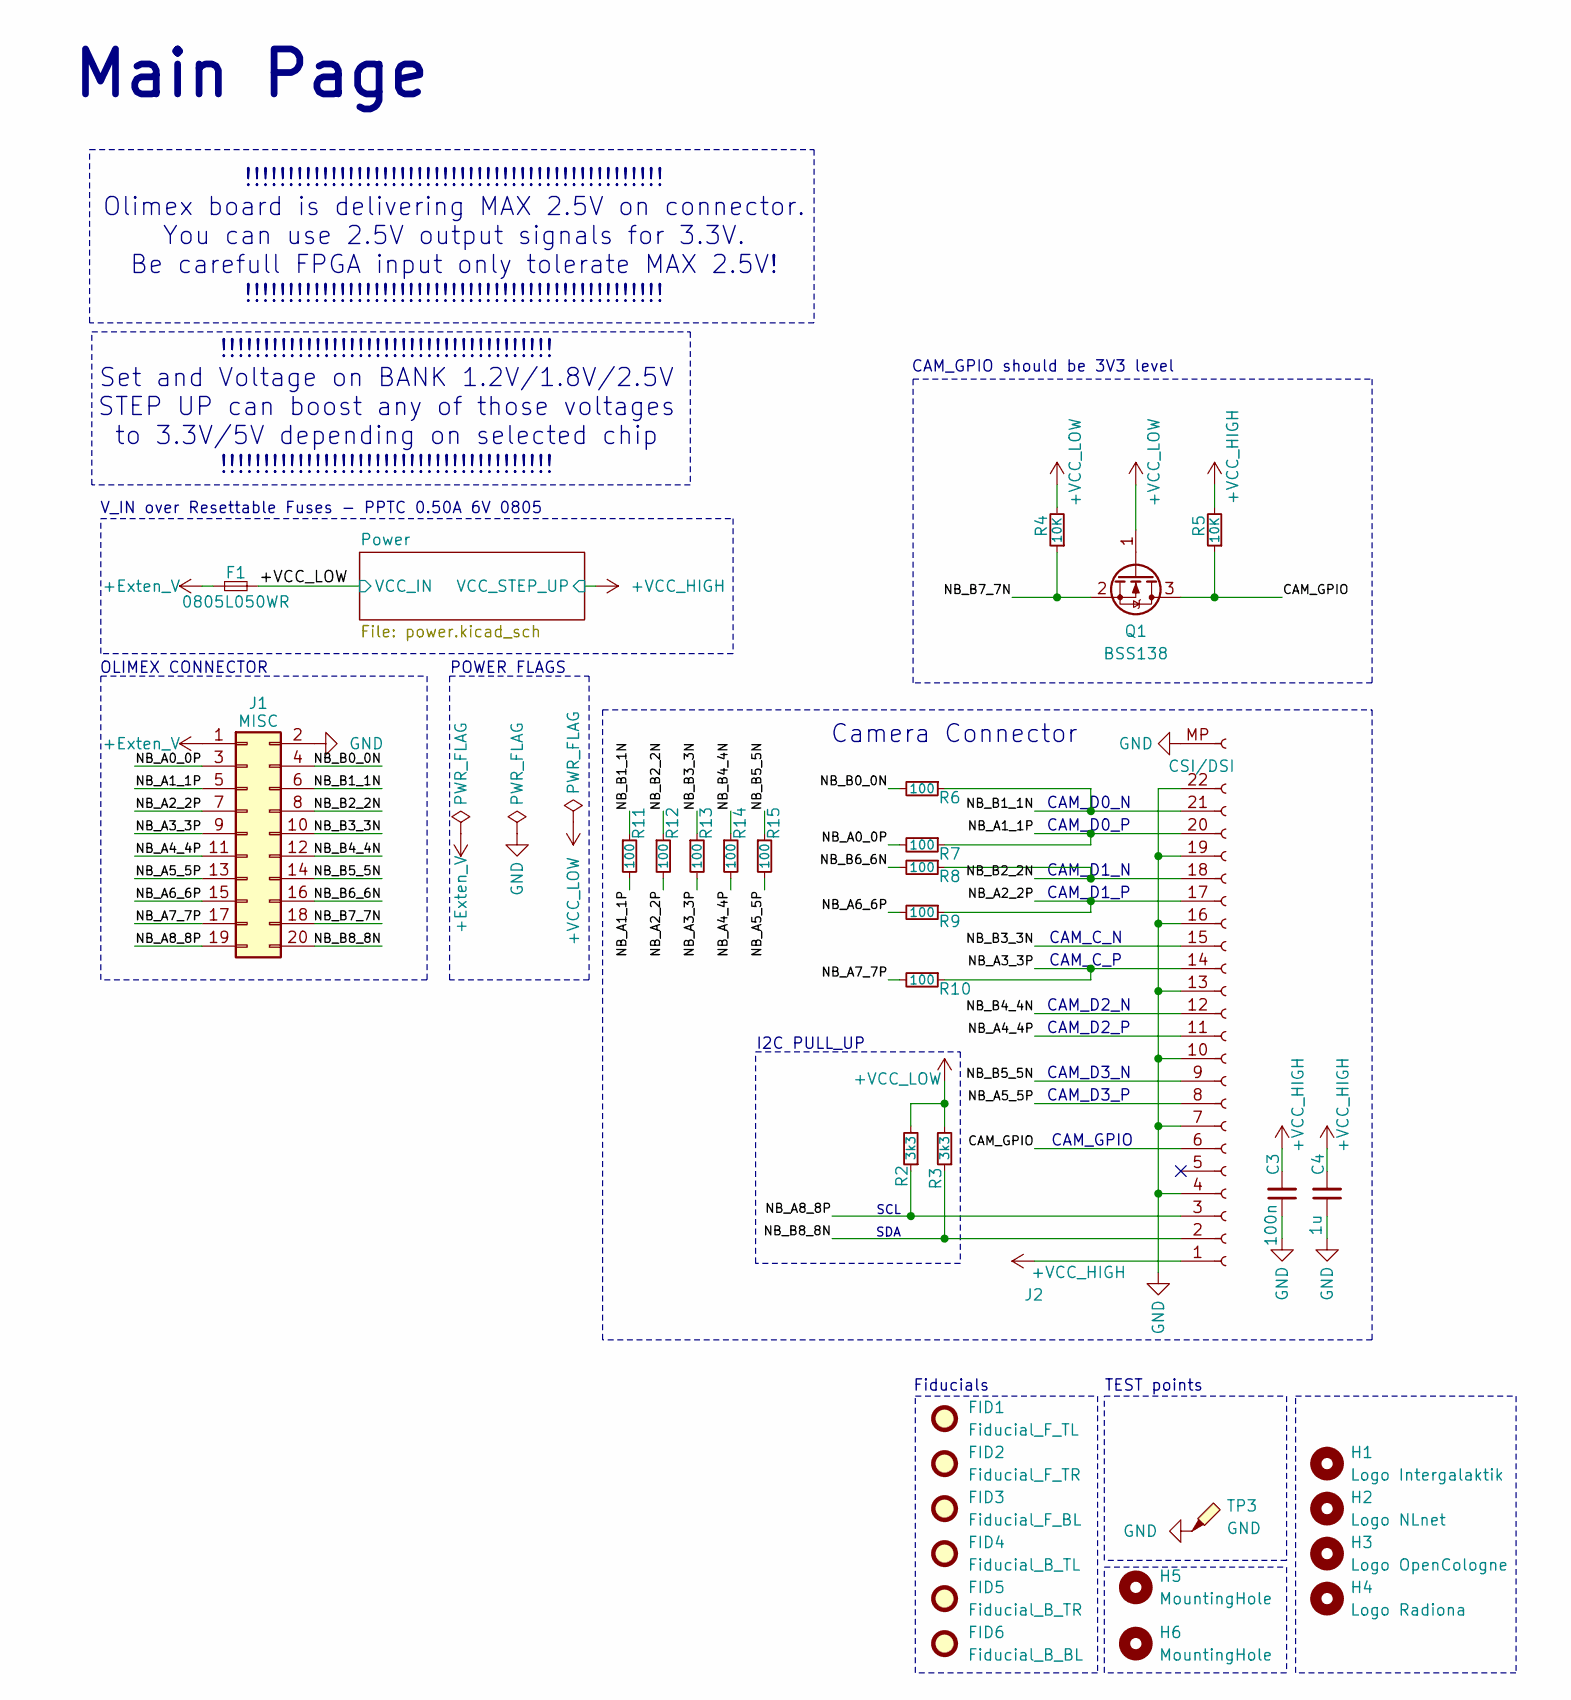
[picture p101: schematic main.kicad_sch, ${project_name} ${project_version}]

Parts:
C3: 100n; C_0402_1005Metric
C4: 1u; C_0603_1608Metric
F1: 0805L050WR; Fuse_0805_2012Metric
FID1: Fiducial_F_TL; Fiducial_0.5mm_Mask1mm
FID2: Fiducial_F_TR; Fiducial_0.5mm_Mask1mm
FID3: Fiducial_F_BL; Fiducial_0.5mm_Mask1mm
FID4: Fiducial_B_TL; Fiducial_0.5mm_Mask1mm
FID5: Fiducial_B_TR; Fiducial_0.5mm_Mask1mm
FID6: Fiducial_B_BL; Fiducial_0.5mm_Mask1mm
H1: Logo Intergalaktik; intergalaktik
H2: Logo NLnet; nlnet
H3: Logo OpenCologne; open_cologne_small
H4: Logo Radiona; radiona_small
H5, H6: MountingHole; MountingHole_2.2mm_M2
J1: MISC; PinSocket_2x10_P2.54mm_Vertical_SMD
J2: CSI/DSI; Hirose_FH12-22S-0.5SH_1x22-1MP_P0.50mm_Horizontal; Part Description 22 Position FFC, FPC Connector Contacts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
Q1: BSS138; SOT-23
R2, R3: 3k3; R_0402_1005Metric; MPN RC0603FR-071K1L; Mouser 603-RC0603FR-071K1L
R4, R5: 10K; R_0402_1005Metric; MPN RC0603FR-071K1L; Mouser 603-RC0603FR-071K1L
R6, R7, R8, R9, R10, R11, R12, R13, R14, R15: 100; R_0402_1005Metric; MPN RC0603FR-071K1L; Mouser 603-RC0603FR-071K1L
TP3: GND; TestPoint_Pad_D1.0mm

Connections:
+Exten_V: F1.1, J1.1
+VCC_HIGH: C3.2, C4.2, J2.1, R5.2; also elsewhere on the board
+VCC_LOW: F1.2, Q1.1 (G), R2.2, R3.2, R4.2; also elsewhere on the board
/Main Sheet/CAM_GPIO: J2.6, Q1.3 (D), R5.1
/Main Sheet/NB_A0_0P: J1.3, R7.2
/Main Sheet/NB_A1_1P: J1.5, J2.20, R7.1, R11.2
/Main Sheet/NB_A2_2P: J1.7, J2.17, R9.1, R12.2
/Main Sheet/NB_A3_3P: J1.9, J2.14, R10.1, R13.2
/Main Sheet/NB_A4_4P: J1.11, J2.11, R14.2
/Main Sheet/NB_A5_5P: J1.13, J2.8, R15.2
/Main Sheet/NB_A6_6P: J1.15, R9.2
/Main Sheet/NB_A7_7P: J1.17, R10.2
/Main Sheet/NB_A8_8P: J1.19, J2.3, R2.1
/Main Sheet/NB_B0_0N: J1.4, R6.2
/Main Sheet/NB_B1_1N: J1.6, J2.21, R6.1, R11.1
/Main Sheet/NB_B2_2N: J1.8, J2.18, R8.1, R12.1
/Main Sheet/NB_B3_3N: J1.10, J2.15, R13.1
/Main Sheet/NB_B4_4N: J1.12, J2.12, R14.1
/Main Sheet/NB_B5_5N: J1.14, J2.9, R15.1
/Main Sheet/NB_B6_6N: J1.16, R8.2
/Main Sheet/NB_B7_7N: J1.18, Q1.2 (S), R4.1
/Main Sheet/NB_B8_8N: J1.20, J2.2, R3.1
GND: C3.1, C4.1, J1.2, J2.4, J2.7, J2.10, J2.13, J2.16, J2.19, J2.22, J2.MP, TP3.1; also elsewhere on the board

Notes on the sheet:
Camera Connector
CAM_D1_N
TEST points
I2C PULL_UP
POWER FLAGS
V_IN over Resettable Fuses - PPTC 0.50A 6V 0805
!!!!!!!!!!!!!!!!!!!!!!!!!!!!!!!!!!!!!!!!!!!!!!!!! Olimex board is delivering MAX 2.5V on connector. You can use 2.5V output signals for 3.3V. Be carefull FPGA input only tolerate MAX 2.5V! !!!!!!!!!!!!!!!!!!!!!!!!!!!!!!!!!!!!!!!!!!!!!!!!!
CAM_D0_N
CAM_GPIO should be 3V3 level
CAM_D1_P
SCL
Fiducials
CAM_D0_P
CAM_D2_P
CAM_GPIO
CAM_D3_P
CAM_C_N
CAM_D2_N
OLIMEX CONNECTOR
CAM_D3_N
SDA
CAM_C_P
Main Page
!!!!!!!!!!!!!!!!!!!!!!!!!!!!!!!!!!!!!!! Set and Voltage on BANK 1.2V/1.8V/2.5V STEP UP can boost any of those voltages to 3.3V/5V depending on selected chip !!!!!!!!!!!!!!!!!!!!!!!!!!!!!!!!!!!!!!!

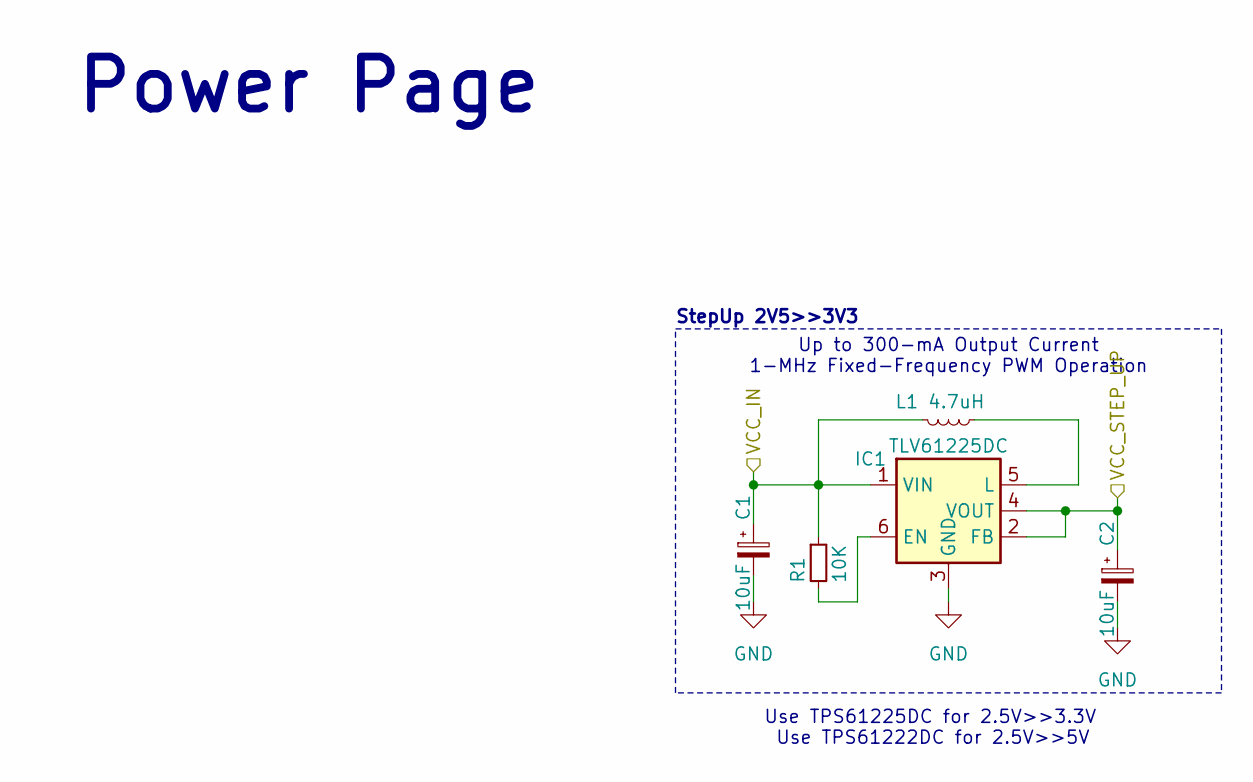
[picture p102: schematic power.kicad_sch, ${project_name} ${project_version}]

Parts:
C1, C2: 10uF; C_0603_1608Metric
IC1: TLV61225DC; SOT-363_SC-70-6
L1: 4.7uH; L_0603_1608Metric
R1: 10K; R_0402_1005Metric; MPN RC0603FR-071K1L; Mouser 603-RC0603FR-071K1L

Connections:
+VCC_HIGH: C2.1, IC1.2 (FB), IC1.4 (VOUT); also elsewhere on the board
+VCC_LOW: C1.1, IC1.1 (VIN), L1.2, R1.1; also elsewhere on the board
GND: C1.2, C2.2, IC1.3 (GND); also elsewhere on the board
unnamed: IC1.6 (EN), R1.2
unnamed: IC1.5 (L), L1.1

Notes on the sheet:
Up to 300-mA Output Current 1-MHz Fixed-Frequency PWM Operation
Use TPS61222DC for 2.5V>>5V
Power Page
StepUp 2V5>>3V3
Use TPS61225DC for 2.5V>>3.3V

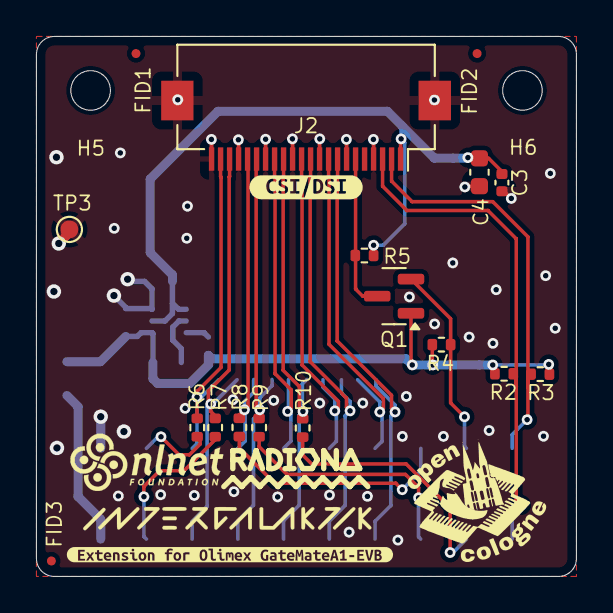
[picture p103: board camIO.kicad_pcb from above]

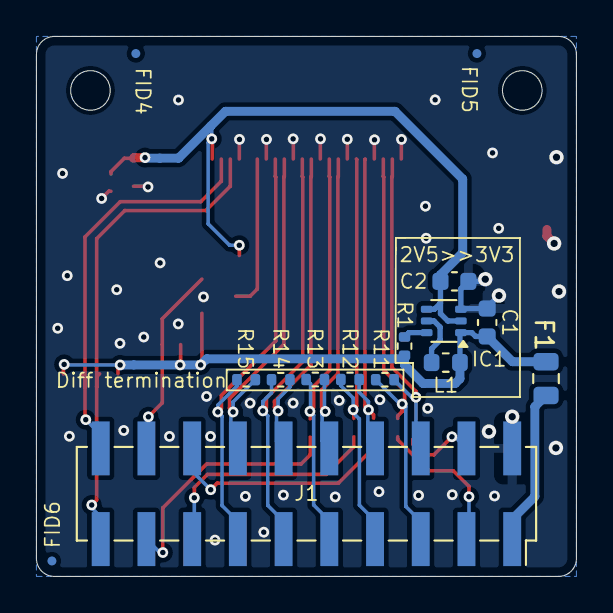
[picture p104: board camIO.kicad_pcb from below]

Board: 4 copper layers, 30.0 x 30.0 mm, 40 parts (15 on the bottom side), 25 nets.

Other parts of the board:
kibuzzard-674D68C8: G***; kibuzzard-674D68C8
kibuzzard-67584A5F: G***; kibuzzard-67584A5F
