intergalaktik/Extension_Boards_for_Olimex_GateMate/(commit log)

2024-10-16 initial version
    [simpleIO.kicad_pcb, simpleIO.kicad_sch]
2024-10-16 Cleanup - switch to 4layer
    [simpleIO.kicad_pcb]
2024-10-16 Changing audio connector
    [simpleIO.kicad_pcb, simpleIO.kicad_sch]
2024-10-16 Starting to work on version with more buttons and I2S audio
    [DAC.kicad_sch, GamePad_I2S_audio.kicad_pcb, GamePad_I2S_audio.kicad_sch]
2024-10-16 Adding StepUP
    [GamePad_I2S_audio.kicad_sch]
2024-10-16 Adding initial schematics
    [GamePad_I2S_audio.kicad_sch]
2024-10-16 initial PCB setup
    [GamePad_I2S_audio.kicad_pcb, GamePad_I2S_audio.kicad_sch]
2024-10-16 Removing not needed file
    [DAC.kicad_sch]
2024-10-16 Adding schematic link
2024-10-18 Adding new libs
    [GamePad_I2S_audio.kicad_pcb, GamePad_I2S_audio.kicad_sch]
2024-10-18 Better GND
    [GamePad_I2S_audio.kicad_pcb]
2024-10-18 update schematics
2024-10-18 Sqitching to only one GND
    [GamePad_I2S_audio.kicad_pcb, GamePad_I2S_audio.kicad_sch]
2024-11-27 Adding initial USB and motor extension
    [USB.kicad_pcb, USB.kicad_sch, motor_1.kicad_sch, power.kicad_sch, pwrIO.kicad_pcb, pwrIO.kicad_sch]
2024-11-28 sch pcb
    [pwrIO.kicad_pcb, pwrIO.kicad_sch]
2024-11-28 Connecting encoder to 2.5V
    [pwrIO.kicad_pcb, pwrIO.kicad_sch]
2024-11-28 initial connection done
    [pwrIO.kicad_pcb, pwrIO.kicad_sch]
2024-11-28 Updating pdf - adding blender export
    [pwrIO.kicad_pcb]
2024-11-29 Adding initial not routed dualTransition PCB
    [dualTranslation.kicad_pcb, dualTranslation.kicad_sch, power.kicad_sch]
2024-11-29 Adding PULL UPs on LOW Level
    [dualTranslation.kicad_sch, power.kicad_sch]
2024-11-29 Adding PULL UPs on HIGH Level
    [dualTranslation.kicad_sch]
2024-11-29 Adding diode footprint
    [dualTranslation.kicad_sch]
2024-11-29 Adding initial timmer board
    [tmrIO.kicad_pcb, tmrIO.kicad_sch]
2024-11-29 Routing dualTranslarion
    [dualTranslation.kicad_pcb]
2024-11-29 Exporting dualTranslation schematic to pdf
2024-12-02 Adding initial extension template
    [extension_template.kicad_pcb, extension_template.kicad_sch, power.kicad_sch]
2024-12-02 Extension template update
    [extension_template.kicad_pcb]
2024-12-02 Adding smaller logo footprints
2024-12-02 PCB update
    [dualTranslation.kicad_pcb, power.kicad_sch, pwrIO.kicad_pcb]
2024-12-02 Template update
    [extension_template.kicad_pcb, extension_template.kicad_sch, tmrIO.kicad_pcb, tmrIO.kicad_sch]
2024-12-02 Adding license - update tmrIO
    [power.kicad_sch]
2024-12-02 dualTranslation update
    [dualTranslation.kicad_pcb]
2024-12-03 Adding git ignore
    [extension_template.kicad_pcb, extension_template.kicad_sch]
2024-12-03 Update tmrIO
    [dimensions.kicad_sch, main.kicad_sch, power.kicad_sch, relay.kicad_sch, tmrIO.kicad_sch]
2024-12-03 tmrIO update
    [dimensions.kicad_sch, main.kicad_sch, relay.kicad_sch, tmrIO.kicad_pcb, tmrIO.kicad_sch]
2024-12-04 Adding transistor
    [dualTranslation.kicad_pcb, dualTranslation.kicad_sch]
2024-12-04 Changing tekst preferences
    [extension_template.kicad_pcb]
2024-12-05 Adding DVI
    [dimension.kicad_sch, dvi.kicad_pcb, dvi.kicad_sch, main.kicad_sch, power.kicad_sch]
2024-12-05 Routing DVI
    [dvi.kicad_pcb, main.kicad_sch]
2024-12-05 DVI update
    [dvi.kicad_pcb, main.kicad_sch, power.kicad_sch]
2024-12-06 Adding initial MikroBus
    [MikroBusIO.kicad_pcb, MikroBusIO.kicad_sch, dimension.kicad_sch, main.kicad_sch, power.kicad_sch]
2024-12-06 Routing extensions
    [MikroBusIO.kicad_pcb, MikroBusIO.kicad_sch, main.kicad_sch]
2024-12-06 Cleanup MikroBus
    [MikroBusIO.kicad_sch]
2024-12-07 Adding initial eduIO board
    [dimension.kicad_sch, eduIO.kicad_pcb, eduIO.kicad_sch, main.kicad_sch, power.kicad_sch]
2024-12-08 Adding initial adcIO
    [adcIO.kicad_pcb, adcIO.kicad_sch, dimension.kicad_sch, main.kicad_sch, power.kicad_sch]
2024-12-08 Updating USB
    [USB.kicad_pcb, USB.kicad_sch]
2024-12-09 Adding ethIO
    [dimension.kicad_sch, ethIO.kicad_pcb, ethIO.kicad_sch, ethernet.kicad_sch, main.kicad_sch, power.kicad_sch]
2024-12-09 Updating ethIO
    [dimension.kicad_sch, ethIO.kicad_pcb, ethIO.kicad_sch, ethernet.kicad_sch, main.kicad_sch, power.kicad_sch]
2024-12-10 Adding voltage level converter for USB
    [USB.kicad_pcb, USB.kicad_sch]
2024-12-10 Adding camIO
    [camIO.kicad_pcb, dimension.kicad_sch, main.kicad_sch, power.kicad_sch]
2024-12-10 fix #1
    [GamePad_I2S_audio.kicad_pcb, GamePad_I2S_audio.kicad_sch]
2024-12-10 Removing U1 as it is not needed - #4
    [camIO.kicad_pcb, main.kicad_sch]
2024-12-10 sch cleanup - reference cleanup
    [camIO.kicad_pcb, main.kicad_sch, power.kicad_sch]
2024-12-10 Adding LP pins on P side of diff pair #4
    [camIO.kicad_pcb, main.kicad_sch]
2024-12-11 Adding termination #4
    [camIO.kicad_pcb, main.kicad_sch]
2024-12-11 Updating ethIO license
    [ethIO.kicad_pcb, ethernet.kicad_sch]
2025-04-01 Moving schematics to v9 adding more details
    [GamePad_I2S_audio.kicad_sch, USB.kicad_sch, motor_1.kicad_sch, power.kicad_sch, pwrIO.kicad_sch, simpleIO.kicad_sch]
2025-04-07 Updating schematics moving to v9
    [GamePad_I2S_audio.kicad_sch]
2025-04-07 Update to KiCad v9
    [tmrIO.kicad_sch]
2025-04-07 Moving to v9
    [dimension.kicad_sch, main.kicad_sch, power.kicad_sch]
2025-04-09 napravljena promjena dolje desno
    [GamePad_I2S_audio.kicad_sch]
2025-04-24 Fix #7
    [USB.kicad_pcb, USB.kicad_sch]
2025-04-24 Fix #6
    [USB.kicad_pcb, USB.kicad_sch]
2025-04-24 Fix #5
    [dualTranslation.kicad_pcb, dualTranslation.kicad_sch, power.kicad_sch]
2025-06-30 V0.2 dualTranslation - it should now work
    [dualTranslation.kicad_pcb, dualTranslation.kicad_sch]
