intergalaktik/Extension_Boards_for_Olimex_GateMate/(notices)

Notices in the files:
GamePad_I2S_audio_Buttons/KiCad/GamePad_I2S_audio.kicad_sch:
CERN-OHL-S v2
parts and their libraries:
project_license: CERN-OHL-S v2
project_license: GPL-3.0
